Mlngyu-Park/2026ESWContest_free_A_IndustryGyuArm/ARM_STUDIO.md

# ARM STUDIO — 블록 코딩 · 디지털 트윈 · 실물 로봇 제어

ARM STUDIO 는 [RACHEL](RACHEL.md) 이 만든 블록을 **실제 로봇의 움직임**으로 바꾸는 프로그램이다.
블록을 직접 끌어다 놓아도 되고, 말로 시켜도 된다. 어느 쪽이든 3D 디지털 트윈에서 먼저 검증한 뒤 실물을 움직인다.

```
말 ─▶ RACHEL ─▶ 블록 ─▶ [ARM STUDIO] 경로 계산 ─▶ 3D 디지털 트윈 검증 ─▶ 실물 실행
```

블록을 손으로 조립해도 같은 길을 간다.

> 원칙: **AI 에 전적으로 의존하지 않는다.** AI 는 블록까지만. 관절 각도·경로·충돌·높이는 전부 기구학 계산이고,
> 계산 결과도 시뮬레이션에서 먼저 확인한 뒤에만 실물로 보낸다.

---

## 1. 화면

| 탭 | 하는 일 |
|---|---|
| ① 공장 꾸미기 | 도킹 스테이션·펜·바닥판을 3D 공장에 배치. 이름과 색 지정 (색은 무지개 6색만 — 말로 부를 때 헷갈리지 않게) |
| ② 시뮬레이션 | 블록 조립, 또는 마이크로 말하기 → 블록 자동 생성 → ▶ 3D 미리보기 |
| ③ 연동 | 실물 로봇 실행 · 일시 정지 · 정지, 자리 보정(미세 조정) |

웹 화면(`http://localhost:7900`, 3D 뷰어 7870). LattePanda Mu 에서는 바탕화면 아이콘으로 전체 화면(키오스크)으로 켠다.

---

## 2. 블록

| 블록 | 뜻 |
|---|---|
| 이동 | 그 대상(도킹·펜) 위로 이동 |
| 잡기 | 열기 → 하강 → 닫기 → 상승 |
| 놓기 | 하강 → 열기 → 상승 → 닫기 |
| 열기 / 닫기 | 그리퍼 |
| 하강 / 상승 | 지금 자리에서 수직으로 |
| 팔 | 이 뒤의 블록은 A팔 또는 B팔이 한다 |
| 기다리기 | N초 쉬기 |

- 「옮기기」 는 [이동→펜] [잡기] [이동→도킹] [놓기] 4개로 자동으로 풀린다.
- 복잡한 동작도 새로운 종류의 일이 아니라 **기존 블록의 조합**이다. 새 동작이 생기면 AI 는 그대로 두고 블록 이름만 늘린다.

---

## 3. 모터 제어 과정 — 블록이 실제 움직임이 되기까지

### ① 닿을 수 있는 곳을 미리 전부 계산 (도달표)

로봇 기준으로 엔드이펙터(그리퍼 끝)가 갈 수 있는 자리를 미리 계산해 둔다.
가로·세로 20mm 칸마다, 높이는 1mm 간격으로 "어느 높이 구간에 닿는가" 를 저장한다.
**로봇 기준 상대 좌표**라서 로봇이나 설비를 옮겨도 다시 계산하지 않고 표만 찾는다.

### ② 목표의 z축 선과 그리퍼의 z축 선을 맞춘다

도킹(목표)의 수직선과 그리퍼의 수직선을 일치시킨다. 그 위에서 **수직으로만** 내려가고 올라온다.
옆으로 밀면서 내려가면 펜이 소켓에 걸리기 때문이다.

### ③ 높이를 기준으로 가장 짧은 경로부터

출발점과 목표 사이를 지나갈 안전 높이를 정하고, 갈 수 있는 경로 중 가장 짧은 것부터 시도한다.
잡는 높이는 실측 치수로 **고정**했다:

```
바닥판 원점 → 도킹 윗면  115mm
도킹 윗면  → 펜 잡는 면  +10mm
그 면      → 그리퍼 기준점 +37mm
                         = 162mm   (잡는 높이, 고정)
접근·이동 높이 = 209mm   (도킹 윗면 + 여유 20mm + 그리퍼 아래로 늘어진 펜 74mm)
```

잡는 높이를 다른 값에서 빼고 더해 구하면, 기준이 어긋날 때마다 펜을 부순다. 그래서 상수로 박았다.

### ④ 경로를 검증한다 — 공정 조건, 물병 규칙

- 관절 한계 안인가, 목표에 3mm 안으로 도달하는가 (IK 결과를 다시 순기구학으로 확인).
- 설비·다른 팔과 부딪히지 않는가 (fcl 충돌 검사).
- **물병 규칙**을 지키는가 (4장).

통과하면 3D 시뮬레이션으로 보여 주고, 실물 실행은 그다음이다.

---

## 4. 물병 규칙 — 그리퍼 위에 물병을 올려도 쏟지 않는다

물건을 나르는 로봇은 도착 정확도만큼 **가는 동안 기울지 않는 것**이 중요하다.

- j2·j3·j4 는 회전축이 나란하다. 그래서 **세 각도의 합이 그리퍼 기울기**를 정한다. 이 합을 경로 전체에서 일정하게 유지한다.
- 손목(j5)은 돌리면 무조건 기울어지므로 쓰지 않는다. 팔이 방향을 바꿀 때는 j1 으로 **몸 전체를 돌린다** (닭이 머리 대신 몸을 돌리듯).
- 축마다 움직이는 양이 다른데 속도가 같으면, 적게 가는 축이 먼저 도착해 합이 깨진다. 많이 가는 축의 속도를 **올려서** 같이 도착하게 했다 (느린 축을 낮추면 떨림이 생긴다).
  → 기울기 최대 4.49° → **0.70°**, 떨림 0회.
- 자리 보정이 있으면 "수평" 은 그 보정 자세의 기울기다. 보정한 기울기를 지키며 수직으로 내려간다.

---

## 5. 디지털 트윈 → 실물

| | 3D 디지털 트윈 | 실물 |
|---|---|---|
| 자세 | 이론값 (URDF 기구학) | 이론값 + **자리 보정** |
| 용도 | 블록 검증, 공정 시간 측정 | 실제 작업 |

### 자리 보정 — 사람이 손으로 맞춘 값을 그대로 쓴다

- 실물 팔은 뻗는 방향에 따라 처지고 유격이 있다. 그래서 자주 쓰는 자리(펜이 놓이는 XY 자리)에서 사람이 팔을 손으로 맞추고 [보정 저장] 을 누른다.
- **보정 = 그 자리에서의 모터값.** 사람이 다시 저장하기 전에는 프로그램이 절대 바꾸지 않는다.
- 보정은 도킹 개체가 아니라 **자리(XY)에 묶인다.** 도킹을 바꿔 끼워도 그 자리의 보정은 그대로다.
- B팔은 보정 자세의 점을 지나는 **수직선**을 따라 내려가 잡는 높이까지 간다.

### 두 팔

- A팔 = 모터 ID 1~5, B팔 = ID 11~15. USB 선 하나에 두 팔이 같이 물려 있다.
- B팔은 A팔과 같은 모델이라 도달표도 그대로 복사해 쓴다.
- 충돌 방지 규칙: **한 팔이 움직이기 전에 다른 팔은 반드시 기본 자세로.** 기본 자세의 팔은 다른 팔이 절대 닿지 않는 곳에 있다.

### 떨림 잡기

| 설정 | 정지 오차 |
|---|---|
| 모터 공장 기본 (Kp32/Kd32/Ki0) | 1.58° |
| 실측 튜닝 (Kp64/Kd64/Ki4, 가속 8) | **0.35° · 떨림 0** |

---

## 6. 블록 코딩 응용 — 산업형 로봇 제어

- **조립된 블록은 물건의 상태와 상관없이 작동한다.** 이동 블록은 실행하는 순간 대상의 위치를 다시 계산한다. 실행 중에 [일시 정지] 하고 3D 화면에서 도킹을 옮기면, [계속] 을 누를 때 팔이 **새 자리**로 간다.
- **조립된 블록은 로봇의 종류와 상관없이 쓸 수 있다.** 블록에는 관절 각도가 없고 "어디로, 무엇을" 만 있다. 기구학은 URDF 에서 읽으므로 로봇이 바뀌면 URDF 만 바뀐다 (`urdf/` 에 SO-ARM(STS3215)·OpenManipulator(Dynamixel) 모델).

---

## 7. 안전

| 기능 | 동작 |
|---|---|
| 일시 정지 | 토크를 유지한 채 멈춤. 그동안 3D 에서 도킹을 옮기면 계속할 때 새 자리로 |
| 정지 | 실행을 멈추고 지금 팔의 토크를 끔 |
| 비상정지 버튼 (아두이노) | 누르는 순간 **두 팔 모두** 그 자리에서 토크 유지로 멈춤 → 버튼을 떼면 두 팔 토크 해제. 버튼 선이 빠지면 뗀 것과 같게 |
| 그리퍼 잡힘 감지 | 닫는 중 위치가 멈추면 잡은 것으로 보고 더 조이지 않음 (모터 과부하 방지) |
| 실행 전 검사 | 도달 불가·충돌·안전 높이 불가면 시작하지 않고 이유를 알려 줌 |

---

## 8. 실행

### LattePanda Mu (시연)

바탕화면의 **ARM STUDIO** 아이콘 → 서버가 켜지고 전체 화면으로 열린다.
실행 스크립트: `dusk_boom_fpga_v35/mu/dusk_tpu/panda_launch_tpu.sh` (DUSK_BOOM TPU 화면까지 같이 연결).
모니터를 더 꽂으면 같은 화면이 자동으로 복제되게 해 두었다 (`mu/dusk_tpu/auto_mirror.py`).

### 노트북 (Windows + WSL2)

```powershell
# Windows PowerShell — 로봇 USB 를 WSL 로 넘기기
usbipd list
usbipd attach --wsl --busid <busid>
```

```bash
conda create -n gyu_arm python=3.10 && conda activate gyu_arm
pip install fastapi uvicorn numpy trimesh python-fcl ikpy pyserial
cd Industry_gyu_arm && ./start_pro.sh        # → http://localhost:7900
```

- 보정·배치 데이터(`calib.json`)는 로봇마다 달라 저장소에 넣지 않았다. 처음 켜면 빈 공장에서 시작한다.
- 더블 레이첼 가중치가 없으면 「말로 만들기」 는 규칙 파서로 동작한다 → [RACHEL.md](RACHEL.md) 8장.

---

## 9. 파일

| 무엇 | 어디 (`Industry_gyu_arm/` 아래) |
|---|---|
| 코어: 기구학·경로·모터·보정·RACHEL 연결 (약 1만 3천 줄) | `arm_studio_web.py` |
| 웹 서버 (FastAPI) | `arm_studio_pro.py` |
| 화면 (바닐라 JS + three.js) | `pro_ui/` |
| B팔 모터 영점·범위 | `sts_arm2.py` |
| 실행 스크립트 | `start_pro.sh` |
| 로봇 모델 · 설비 메쉬 | `../urdf/` · `../stl/` |

---

## 10. 기술 스택

| 분야 | 쓴 것 |
|---|---|
| 기구학 | numpy (동차변환·IK 직접 구현), ikpy, trimesh, python-fcl |
| 모터 | pyserial — Feetech STS3215 직접 통신 |
| 서버 · 화면 | FastAPI, three.js, 바닐라 JS |
| 개발 | ROS 2 Humble · RViz (초기 개발), VS Code |
