Mlngyu-Park/2026ESWContest_free_A_IndustryGyuArm/Industry_gyu_arm/ARMSTUDIO_전체정리_20261026.md

# ARM STUDIO — AI 로봇팔 프로그램 정리

**박민규 · 2026-10-26 기준 · 프로그램(소프트웨어)만**

말이나 블록으로 로봇팔에 일을 시키고, 그 움직임을 3D 디지털 트윈에서 먼저 확인한 뒤, 같은 명령을 실물 팔로 보내는 프로그램이다. 휴대폰 카메라로 실제 판을 비추면, 도킹·로봇이 놓인 자리를 읽어 트윈에 그대로 옮기고, 실행 중 목표가 사라지면 팔을 든 채 기다렸다가 다시 꽂으면 이어 간다.

이 문서는 코드와 실측 기록에서 확인한 사실만 적는다. 모터·회로 같은 하드웨어 이야기는 뺐다. 10-03 문서(`인규암_ARMSTUDIO.md`) 이후 바뀐 것은 **[10-03 이후]** 로 표시했다.

---

## 목차

1. 한눈에 보기
2. 설계 원칙 — AI 경계선
3. 프로그램 구성
4. 좌표계·툴 중심·목심 격자
5. 기구학
6. 모션 실행 논리
7. 블록 파이프라인
8. AI 층 — 말이 블록이 되는 과정
9. RACHEL — 직접 만든 언어모델
10. 디지털 트윈
11. 공장 꾸미기와 배치 프리셋
12. 미세조정(보정) — 자리에 묶는 보정
13. 휴대폰 카메라 — 실제 판을 트윈에 옮기기
14. 실행 중 카메라 연동 — 경로 표시·대기·이어가기
15. DUSK — 파이썬 없는 C 엔진
16. 실측 숫자 종합
17. 장점
18. 단점과 알려진 문제
19. 파일 구조와 실행 방법

---

## 1. 한눈에 보기

```
사람의 말 / 블록 끌어놓기                 휴대폰 카메라 (실제 판)
        │                                        │
        ▼                                        ▼
  [음성 인식]  소리 → 글자          AI     [격자 추적]  구멍 → 판 좌표·카메라 위치   계산
  [힌트]       색·번호 → 도킹 id    계산   [물건 찾기]  바닥색·3D 모양 → 로봇·도킹    계산
  [명령 해석]  글자 → 블록 목록     AI     [판 맞춤]    카메라 판 → 앱 바닥판         계산
  [검증]       없는 대상 버리기     계산          │
  [기구학]     블록 → 관절각 경로   계산          │ 도킹 이동·숨김·로봇 이동
        │                                        ▼
        ├──▶ [3D 디지털 트윈]  이론 자세 + 지금 블록의 경로 + 카메라 위치
        └──▶ [실물 명령]       이론 자세 + 그 자리의 XY 보정
                                (목표가 카메라에서 사라지면 팔을 든 채 대기)
```

| 항목 | 값 |
|---|---|
| 코어 | `arm_studio_web.py` **11,722줄** — 기구학·경로·충돌·명령 전송·LLM·시뮬레이션·카메라 반영 |
| 서버 | `arm_studio_pro.py` **1,028줄**, FastAPI. `/api/call` 하나로 핸들러 약 90개를 부른다 |
| 화면 | `pro_ui/` — app.js 1,756줄 · index.html 555줄 · app.css 461줄 · phone.html 106줄, 바닐라 JS + three.js |
| 카메라 | `cam_grid/` — livecam.py 815줄 · grid.py 393줄 · objects.py 178줄 · pose.py 61줄 |
| 포트 | 앱 7900 · 3D 뷰어 7870 · 휴대폰 https 7943 · DUSK 7880 · (선택) Spark LLM 18000 · Spark 음성 18090 |
| 실행 | `Industry_gyu_arm/start_pro.sh` |

화면은 네 탭이다.

| 탭 | 하는 일 |
|---|---|
| ① 공장 꾸미기 | 설비(STL)를 끌어다 놓기, 다리 2개를 목심에 찍어 자리·방향 정하기, 바닥판 늘리기, 배치 저장·불러오기 |
| ② 시뮬레이션 | 블록 목록과 3D. [🎤 누르고 말하기] [보내기] [▶ 미리보기] [실물 실행] |
| ③ 연동 | 자세별 미세조정·보정 저장, **📱 휴대폰 카메라** |
| ④ 조이콘 | 조그 이동 (미리 계산한 조종표) |

---

## 2. 설계 원칙 — AI 경계선

> **AI 는 말을 블록으로 바꾸는 일까지만 한다. 좌표·경로·충돌·명령·카메라 인식은 전부 계산이 한다.**

AI 는 두 곳에만 있다. 소리를 글자로 바꾸는 곳과, 글자를 블록으로 바꾸는 곳이다. 그 사이와 그 뒤는 전부 결정론적 계산이라 같은 블록은 언제나 같은 관절각을 낸다. 카메라 인식도 신경망이 아니라 기하 계산(호모그래피·색 비교·3D 투영)이다.

이유는 안전이다. "대체로 맞는" 답을 내는 부품을 좌표를 만드는 자리에 두지 않는다. 효과는 실측으로 확인했다. "빨간 도킹이 몇 번인가" 같은 표 조회를 신경망에 시켰을 때 색 지칭 정확도가 **65.2%** 였고, 이것을 20여 줄짜리 계산(`hints.py`)으로 옮기자 **99.6%** 가 됐다 (같은 검증셋 267문장).

---

## 3. 프로그램 구성

```
브라우저 (pro_ui)  ──/api/call──▶  arm_studio_pro.py (FastAPI)  ──▶  arm_studio_web.py (코어)
      │                               │  /state·/mesh·/camframe 중계        │
      └── 3D 뷰어 (7870, three.js) ◀──┘                                     ├─ 기구학·경로·충돌
                                                                             ├─ 블록 실행 (시뮬 / 실물)
휴대폰 phone.html ──POST /api/live/frame (https 7943)──▶ cam_grid/livecam   ├─ LLM 호출·검증
                                                         (일꾼 스레드)       └─ 카메라 반영 루프 (0.5초)
```

| 구성 | 하는 일 |
|---|---|
| 코어 | 로봇 정의(URDF)를 읽어 기구학을 세우고, 블록을 관절각 경로로 바꿔 시뮬레이션·실물 명령으로 보낸다 |
| 서버 | 화면 요청을 코어 핸들러로 연결하고, 3D 뷰어·휴대폰 페이지를 띄운다. 화면 파일은 캐시하지 않는다 (옛 app.js 가 남아 보정이 한 번에 지워지던 일 뒤) |
| 화면 | 블록 편집, 3D 조작, 보정, 카메라 버튼 |
| 3D 뷰어 | 트윈 표시. 서버를 거쳐 앱 상태를 받는다 |
| 카메라 | 휴대폰 영상으로 판·로봇·도킹 인식 (별도 스레드, 최신 장만 처리) |
| 로봇 교체 | URDF 만 바꾸면 기구학이 따라온다. 보정 파일도 로봇(URDF 패키지)마다 따로 |

---

## 4. 좌표계·툴 중심·목심 격자

### 4-1. cr_7 (툴 중심)

로봇이 "어디에 있는가"를 말할 때의 기준점이다. j6 링크에서 `[-9, 39.5, 39.3] mm` 떨어진, 그리퍼 회전 원의 중심이다. 그리퍼를 열면 움직이는 죠의 좌표가 바뀌므로, 툴 중심은 j6 를 기준각(`J6_TOOL_REF`)으로 고정하고 계산한다.

### 4-2. 잡는 높이 — 고정값

```
115 mm   도킹 스테이션 높이
+ 10 mm  도킹 윗면 → 그리퍼가 닿는 면      (GRASP_FACE_DZ)
+ 37 mm  잡는 면 → cr_7 중심               (실측 36.67)
= 162 mm 바닥 기준 잡는 점
```

메쉬로 매번 계산하면 오차가 쌓이고 도킹마다 흔들려서, 한 번 재서 고정했다.

### 4-3. 목심 격자 — 바닥판은 안 바뀐다

바닥판은 20 mm 간격 목심 격자다. 타일 하나가 200 mm(10×10칸), 판은 최대 **3×3 타일(30×30칸)** 이다. 파랑·흰 타일이 체크무늬로 깔린다. 앱의 첫 목심은 (−90, −90) mm 에서 20 mm 간격이다.

**바닥판은 고정 기준이고, 로봇과 도킹은 움직일 수 있다** — 카메라 연동의 기본 전제다 (§13).

---

## 5. 기구학

| 항목 | 내용 |
|---|---|
| 순기구학 | URDF 관절 체인 행렬 곱. `fk(q)` = j6 원점, `tool_pos(q)` = cr_7 |
| 수평 구속 「물컵 규칙」 | j2·j3·j4 가 평행하므로 **j2+j3+j4 = 0** 이면 그리퍼가 늘 수평. j5 는 0 고정. 실측 최대 오차 1.07° |
| IK | `ik_level`(수평 유지, 여러 초기값), `ik_tool`(툴 기준, 수렴 0.002 mm), `ik_general`(구속 없는 로봇용) |
| 간편 이동 | **뽑기(수직 상승) → 수평(A* 격자 경로, 높이 유지) → 하강(수직)**, `plan_simple` |
| 목심 도달표 | 658칸, 목심마다 닿는 높이 구간을 1 mm 단위로 미리 계산 |
| 조종표 | 143,667칸(10 mm 격자). 시작할 때 0.5~0.7초에 불러온다 |
| 충돌검사 | trimesh + fcl. 로봇 링크와 설비 STL 의 겹침을 **실행 전 표시만** 한다 (피해 가지는 않음) |

도달표·조종표는 **로봇 기준 상대좌표**라, 로봇이나 설비를 옮겨도 다시 계산할 필요가 없다 (재계산 0초). 카메라가 로봇을 옮겨도 마찬가지다.

---

## 6. 모션 실행 논리

- 이동은 **"보내고 → 기다리고"** 의 반복이 전부다. 도착 확인 후 오차만큼 다시 미는 단계(settle)가 진동의 근원이라 뺐다 (`SETTLE_ON=[False]`).
- 이동 중 상태 읽기도 뺐다 (걸음마다 250 ms 씩 멈췄다).
- 그리퍼만 닫힘을 확인한다 (쥐면 목표 각도에 못 가므로).
- **3D 는 이론 자세, 실물 명령은 이론 자세 + 그 자리의 보정** (§12).
- 카메라가 지켜보는 중이면 실물로 보내는 매 걸음마다 목표가 그대로 있는지 확인한다 (§14).
- 정지 버튼은 즉시 멈춤. 3D 에서 고른 로봇과 실물이 다르면 실물 전송을 막는다 (`real_robot_ok()`). 말로 실물을 움직이려면 "실물 실행 확인"까지 두 번 말해야 한다.

---

## 7. 블록 파이프라인

### 7-1. 블록 7종

| 블록 | 기호 | 실제 동작 | 좌표 |
|---|---|---|---|
| 이동 | `@goto:<id>` | 뽑기 → 수평 → 하강 | **있음** |
| 잡기 | `@grasp:<물체>` | 열기 → 하강 → 닫기 → 상승 | 없음 |
| 놓기 | `@release:<도킹>` | 하강 → 열기 → 상승 → 닫기 | 없음 |
| 열기 / 닫기 | `@open` `@close` | 제자리 | 없음 |
| 하강 / 상승 | `@down` `@up` | 지금 XY 유지, 수직 | 없음 |

### 7-2. 좌표는 이동 블록만 갖는다

잡기·놓기가 스스로 XY 를 계산하면 이동이 계산한 XY 와 둘이 생겨 실측 23 mm 가 어긋났다. 그래서 좌표는 이동 블록 하나만 갖고, 잡기·놓기 앞에 이동이 없으면 `seq_fix_moves()` 가 넣는다.

### 7-3. 이동 블록은 실행하는 순간 다시 계산한다

미리 계산한 경로는 물체가 중간에 옮겨지면 옛 위치로 간다. 이동 블록은 실행하는 순간 대상의 **지금 위치**로 경로를 다시 푼다. 카메라가 도킹을 옮겨 놓았으면 옮긴 자리로 간다.

### 7-4. 블록 어휘의 한계

"등록된 도킹 사이의 이송"만 표현한다. "옆에", "두 개 다", 밀기·누르기는 못 한다. 위치 제어만 있다.

---

## 8. AI 층 — 말이 블록이 되는 과정

### 8-1. 음성 인식

| 엔진 | 위치 | 특징 |
|---|---|---|
| Spark Whisper (large-v3-turbo) | DGX Spark (18090) | 정확하다. 네트워크가 필요하다 |
| Moonshine 한국어 27MB | 로컬 단독 | 네트워크 없이 돈다. 정확도는 낮다 |

Moonshine 은 4초 창을 3초 간격으로 겹쳐 돌리고 이어 붙인다. 반복 루프와 끝의 헛말("감사합니다" 등)은 규칙으로 자른다.

### 8-2. FIXER — 받아쓴 말 다듬기 (자작 7.5MB)

Moonshine 결과에만 쓴다. 글자 단위 GPT(7,603,200 파라미터, int8 7.5MB, 호출당 25~31 ms). 고친 결과에서 색·동작이 사라지거나, 순서가 바뀌거나, 없던 것이 생기면 **원문을 그대로** 쓴다. 음성 인식과 FIXER 를 합쳐 WHISPER DUSK 라 부른다.

### 8-3. 명령 해석 엔진

| 선택 | 내용 |
|---|---|
| `auto` (기본) | Spark 가 살아 있으면 Gemma 4 E4B **원본**(5.15 GB, 생각하기 끔), 없으면 로컬 ollama, 둘 다 없으면 규칙 파서 |
| `rachel` | 직접 만든 RACHEL (C++, §9) |
| `rule` | 규칙 파서 (AI 없음) |

Gemma 4 는 "생각하기"를 끄지 않으면 블록을 못 만든다 (켜면 14초·블록 0개, 끄면 4.3초·블록 8개).

### 8-4. 힌트 — AI 에게 시키지 않는 일

`hints.py` 가 문장에서 색·번호 언급을 찾아 언급 순서대로 도킹 id 를 붙인다. 모델에 남는 일은 "어느 것이 출발·경유·도착인가" 뿐이다.

```
장면: 보라=d2 빨강=d10 주황=d11 | 펜=초록@d2
힌트 d2 d10
보라색 도킹의 초록 펜 빨간 데로 옮겨
>
```

### 8-5. 출력 검증과 폴백

- 이중 포장된 배열을 펴고(`_flat_blocks`), 짧은 별명을 실제 id 로 바꾸고(`_llm_expand`), **등록되지 않은 대상은 버린다**(`_resolve_item`).
- 입력 문장의 **줄바꿈·여러 칸 띄어쓰기를 한 칸으로** 바꾼 뒤 넣는다 **[10-03 이후]** — 받아쓴 문장에 줄바꿈이 섞이면 RACHEL 이 그 뒤 색(빨강)을 건너뛰었다.
- 폴백: RACHEL/Gemma → 실패 → 규칙 파서(검증 200문장 중 30.0%) → "무슨 뜻인지 모르겠습니다".
- 검증은 id 가 있는지만 본다. 같은 도킹으로 세 번 가는 식의 **뜻이 틀린 순서는 걸러지지 않는다.**

---

## 9. RACHEL — 직접 만든 언어모델

Robot Arm Command Handling Embedded Language-model. 한국어 명령을 블록 JSON 으로 바꾸는 일 하나만 하도록 밑바닥부터 만들었다.

### 9-1. 제원 (`rachel_v9.bin`)

| 항목 | 값 |
|---|---|
| 구조 | GPT decoder-only, 차원 320 / 8층 / 8헤드 |
| 어휘 / 문맥 | 448 (글자 단위) / 179 |
| 파라미터 | **10,122,240** |
| 파일 | **10,126,061 B (10.1 MB)**, int8 |
| 앱이 여는 파일 | `rachel_cpp/rachel.bin` = **v9 와 같은 파일** (md5 일치) **[10-03 이후 — 예전엔 v8]** |

### 9-2. 학습 데이터

규칙 생성기로 합성한 15만 쌍(사람 라벨 없음). 명령 분기 9종, 문장 틀 48개, 음성 오염 규칙 7개. 장면(색↔도킹 배치) 140,483가지를 무작위 배정해 외우지 않고 장면을 읽게 했다. 장면에 없는 요청은 빈 블록으로 거절하게 학습했다. 손실은 답 부분에만 건다.

### 9-3. 정확도

| 시험 | 결과 |
|---|---|
| 검증 200문장 | **197/200 (98.5%)** — 정수 엔진·평가기·Spark 모두 같은 값 |
| 검증 3,000문장 | 2,875/3,000 (95.8%) |
| Gemma 4 E4B 원본 (같은 200문장) | 78/200 · 5.15 GB · 메모리 3,866 MB |
| RACHEL 메모리 | **21.9 MB, CPU 1스레드** |
| 지연 (C int8) | 중앙 180 ms · 평균 225 ms |
| **실제 사람이 한 말** (사용 기록 98문장, 화자 1명) | 명령 86문장 중 **최소 36개(42%) 오류** — 합성 검증과 큰 차이 |

---

## 10. 디지털 트윈

### 10-1. 구조

three.js 뷰어가 별도 포트(7870)에서 돌고, 앱(7900)이 애니메이션 청크를 보낸다. 서버가 `/state`, `/mesh`, `/camframe` 등을 뷰어로 중계한다. **같은 파이프라인이 3D 와 실물 양쪽으로 나간다.** 청크를 바이너리로 바꿔 4.1 MB/2,825 ms → 1.1 MB/6 ms 가 됐다. **[10-03 이후]** 설비 이름에 든 `#` 을 중계가 잘라먹지 않게 주소를 다시 인코딩했다.

### 10-2. 트윈이 보여 주는 것

| 표시 | 내용 |
|---|---|
| 로봇 | URDF 메쉬. **언제나 이론 자세** (보정은 실물 명령에만, §12) |
| 설비 | 바닥판·도킹·물체 STL. 도킹 색은 이름 붙이기에서 정한 색 |
| **지금 블록의 경로** **[10-03 이후]** | 실행 중인 이동 블록 **하나**의 예상 경로를 하늘색 반투명 관으로 (`PATH_VIS` → `/state` 의 `path` → 뷰어 `drawPath`, 불투명도 0.35) |
| **휴대폰 카메라 위치** **[10-03 이후]** | 주황 사각뿔(시야)로 카메라 위치·방향. 손떨림은 One Euro 필터로 거른다 |
| **1인칭** **[10-03 이후]** | 카메라 자리에서 본 트윈. 보기 3가지: 트윈+영상 겹치기 / 트윈만 / 영상만 |
| 카메라가 옮긴 결과 | 도킹 이동·숨김·다시 보임, 바닥판 추가, 로봇 이동이 바로 반영된다 |

### 10-3. 트윈 검증

| 무엇 | 값 |
|---|---|
| 툴 IK 수렴 | 0.15 mm → 0.002 mm |
| 도착 판정 | 3 mm |
| 트윈 3단계 (검증 200문장, 3 mm) | 블록 정답 197 · 도달·충돌 없음 143 · 3 mm 도착 143. 못 잰 57개는 판정 불가(도킹 3개뿐인 배치 등)이고 실패 0건 |

### 10-4. 원위치 버튼 **[10-03 이후]**

[원위치]는 팔을 영(0) 자세로 돌리면서, **물체(펜)도 [불러오기]로 고른 배치 프리셋의 자리로** 되돌린다 (`h_home_zero(preset)`, 고른 게 없으면 마지막으로 불러온 배치). 실물 실행으로 펜이 다른 도킹에 남았는데 손으로 되돌려 놓은 경우, 트윈이 옛 자리를 믿는 문제를 없앴다. 설비·로봇 위치는 건드리지 않는다.

---

## 11. 공장 꾸미기와 배치 프리셋

- 설비 STL 을 끌어다 놓으면 실물 모양이 커서를 따라온다. **다리(핀) 2개를 목심에 클릭**해 자리와 방향을 정한다. 위치는 20 mm 격자에 맞춘다.
- 우클릭으로 이동·핀 다시 찍기·삭제.
- 물체는 늘 도킹 위에 올라간다 (중심축 일치).
- 도킹은 배치 순서대로 색·번호를 고정 배정한다.
- 바닥판은 3D 에서 더블클릭 → 빈 자리 클릭으로 늘린다. 카메라도 9장까지 자동으로 늘린다.
- 배치를 이름 붙여 **프리셋**으로 저장·불러오기 한다. 켤 때는 "바닥판만 있는 공장"으로 시작하고, 직전 배치는 '이전 배치' 프리셋에 남는다.
- **[10-03 이후]** 도킹 모델을 다리가 하나 더 있는 새 STL 로 바꿨다. 주요 치수·소켓 자리(270, 62.5 mm)는 이전과 같다.

---

## 12. 미세조정(보정) — 자리에 묶는 보정 **[10-03 이후 크게 바뀜]**

### 12-1. 원칙

| 원칙 | 내용 |
|---|---|
| **보정의 주인은 물건이 아니라 판 위 XY 자리** | 보라 도킹에서 보정해 두고 같은 자리에 주황 도킹을 놓아도 그 보정을 쓴다. 이동 목표 XY 에서 10 mm(`SLOT_TOL`) 안에 등록된 '이동' 자세를 이름과 상관없이 찾는다 (`_goto_pose_q`, `_slot_pose`) |
| **트윈은 이론, 실물은 이론 + 보정** | 예전엔 보정 각도로 3D 까지 움직여 트윈 속 펜이 도킹에서 어긋났다. 이제 3D 는 계산 자세 그대로 간다 |
| **보정은 XY 만** | 보정 자세에서 "실제로 가리키는 XY − 자리 XY" 만 뽑아(`_slot_delta`), 트윈 팔 끝과 **같은 높이**에서 XY 만 옮긴 자리를 실물 목표로 푼다. 미세조정 중 높이까지 바뀐 채 저장된 경우(실측: 이름은 235 mm 인데 실제 175.9 mm) 펜 속으로 내려가던 문제를 없앴다 |
| 서서히 붙고 떨어짐 | 자리 중심에서 XY 5→30 mm 사이, 등록 높이보다 2→8 cm 위 사이에서 보정량이 1→0 으로 준다. 30 mm 넘는 XY 보정은 잘못 저장된 것으로 보고 안 쓴다 |

### 12-2. 흐름

```
블록 우클릭 [🎯 자세 등록]  →  ③연동 [로봇을 이 자세로]  →  J1~J5 +/−  →  [보정 저장]
```

- **같은 자리를 다시 등록하면 덮어쓴다** (값이 둘이 되어 옛 값으로 가던 문제 해결).
- **보정 자세를 지울 때는 두 번 묻는다** — "보정 좌표까지 삭제할까요? (취소하면 삭제하지 않습니다)" (`poseDelOk`).
- +/− 는 메모리에서만 바뀌고, [보정 저장]이 저장 파일에 쓴다. 저장 직전 하루 한 번 자동 백업(`calib.json.YYYYMMDD.bak`).
- 저장 파일 `calib.json`(로봇마다 하나)에 자세·보정·블록·배치·프리셋·로봇 자리가 다 들어 있다. 자동 저장은 "파일에는 있는데 메모리에는 없는 항목"을 지우지 않고 살려 둔다.

---

## 13. 휴대폰 카메라 — 실제 판을 트윈에 옮기기 **[10-03 이후 새로 만듦]**

휴대폰을 손에 들고 판을 비추면, 판 위 로봇·도킹의 자리(와 도킹 색)를 읽어 트윈에 그대로 옮긴다. 예전의 녹화 영상용 연동(`camsync.py`)은 자동 반영이 보정 파일을 덮어쓴 사고 뒤 꺼 두었다 (`CAM_ENABLED=False`). 지금 쓰는 것은 휴대폰 실시간판이다.

### 13-1. 전체 흐름

```
휴대폰 브라우저  https://<주소>:7943/phone   [시작]
   │  후면 카메라 → 긴 변 1920 JPEG(품질 0.75) → POST /api/live/frame
   │  답을 기다리지 않고 동시에 2장까지, 초당 최대 10장
   ▼
livecam.LiveCam (일꾼 스레드, 늘 가장 최근 장만 처리 — 밀리지 않는다)
   ├ 빠른 길 (매 장)     : 격자 추적 → 카메라 위치·방향
   └ 느린 길 (0.4초마다) : 판 무늬 · 바닥색 · 로봇·도킹 찾기 · 도킹 3D 모양 맞추기
   ▼
layout()  : 로봇 받침 칸, 도킹(색·가운데·다리·방향), 비어 보이는 칸, 본 타일
   ▼
앱 _live_apply_loop (0.5초마다)
   ├ 판 맞춤 (카메라 판 → 앱 바닥판)
   ├ 바닥판 늘리기 · 도킹 옮기기/숨기기/다시 보이기 · 로봇 옮기기
   └ 트윈: 카메라 위치(주황 사각뿔), 1인칭
```

### 13-2. 휴대폰 연결

| 항목 | 내용 |
|---|---|
| 왜 https 인가 | 아이폰 브라우저는 https 에서만 카메라를 연다. 앱이 같은 서버를 **https 7943** 으로도 띄운다 (`start_phone_https`) |
| 인증서 | 처음 켤 때 openssl 로 자체 서명 인증서를 만든다 (`certs/`). 사파리 경고에서 "이 웹사이트 방문" |
| 주소 표시 | ③연동 → 📱 휴대폰 카메라에 접속 주소가 나온다 |
| 화면 꺼짐 방지 | 촬영 중 화면이 꺼지지 않게 잠금(wakeLock) |
| 상태 | 휴대폰 화면 아래에 "격자 추적 중 · 카메라 높이 · 장/초 · 처리 시간"과 안내 문구 |

③연동의 버튼: 판 90° 회전·◀▶▲▼(손으로 맞추기), 1인칭 켜기/끄기, 1인칭 보기 바꾸기, 자동 반영 켜기/끄기, 판 다시 맞추기, **녹화 시작/끝**(모든 프레임 저장 — 인식 맞추기용), 손떨림 거르기, 처음부터 다시 찾기.

### 13-3. 구멍 찾기 (`grid.detect_holes`)

1. 화면에서 **파랑 또는 흰색 판 영역**만 남긴다 (벽·책상·로봇 제외).
2. 주변보다 **어두운 동그란 덩어리**를 찾는다 (구멍 안은 그늘이 진다).
3. 너무 길쭉하거나(가로세로 2배 넘게) 작은 것은 버린다.
4. 크기로 큰 구멍(목심 자리)과 작은 물빠짐 구멍을 가른다.
   - 처음: 면적 분포를 두 무리로 나눠 큰 쪽.
   - **추적 중: 예상 격자로 화면 자리마다 칸 넓이를 계산해, 그 자리에 맞는 크기만** (면적 ≈ 0.107 × 칸 넓이). 비스듬히 보면 가까운 구멍은 크고 먼 구멍은 작아서, 화면 가운데 크기 하나로 거르면 맞음 비율이 55~60% 로 떨어졌다 → 자리별로 바꿔 **96%**.

### 13-4. 각도 찾기 — 구멍 4개 + 판 색 경계

- **처음부터 찾기** (`fit_full`): 이웃 구멍끼리의 짧은 화살표에서 격자의 두 방향을 고르고, **구멍 하나와 그 오른쪽·아래·대각선, 구멍 4개로 판의 기울기·크기(호모그래피)를 계산**한다. 그것으로 판 전체 구멍 자리를 예측해 실제 구멍과 맞춰 다듬는다. 출발 구멍을 바꿔 최대 60번, 75% 이상 맞으면 바로 멈춘다.
- **판 색 경계 검사** (사용자 제안): 그렇게 구한 격자로 **구멍이 맞은 칸의 색이 10칸 타일 체크무늬와 85% 넘게 맞아야** 받아들인다. 실측: 맞는 격자는 중앙 99%, 틀린 격자는 중앙 87%.
- **몇 번째 칸인지**: 구멍은 다 똑같이 생겨 칸 번호를 모르므로 파랑·흰 체크무늬로 정한다. 칸 색은 구멍 사이 한가운데가 아니라 **구멍에서 0.3칸 안쪽**에서 읽는다 — 한가운데(0.5)는 타일 마지막 줄에서 퍼즐 이음새 위라 무늬 위치가 1칸 어긋났다 (판 경계와 맞는 장 4장 → 23장).
- **추적 중**: 앞 장과 이번 장에서 로봇·도킹·판 모서리처럼 하나뿐인 모양(특징점)으로 화면 이동을 먼저 잡고, 앞 장 격자를 그만큼 옮겨 실제 구멍에 다듬는다. 특징점은 절반 크기 화면에서 1,500개, 앞 장 것은 다시 쓴다.
- **실패 판정**: 맞은 구멍 60% 미만이거나 오차 4px 초과면 실패. 추적 결과가 나쁘면 **같은 장에서 바로 처음부터** 다시 찾는다. 두 번 연속 실패하면 앞 장 정보를 버린다.

### 13-5. 카메라 위치·방향 (`pose.py`)

- 호모그래피와 카메라 화각으로 판 기준 카메라 위치·방향을 푼다 (`camera_pose`).
- 화각: 아이폰 1080×1920 실측 초점거리 약 1,356~1,384 px. 계산값이 긴 변 화각 55~80° 범위일 때만 받아 최근 40장 중앙값을 쓰고, 모이기 전엔 70° 로 둔다. (계산이 흔들려 411~3,454 px 이 나와 주황 사각형이 갑자기 커지던 문제를 이렇게 막았다.)
- **거울상 판 축**: 보는 쪽에 따라 판 격자 축이 거울상(왼손 좌표)으로 잡히는 장면이 있다. 그때 카메라가 반대 방향을 보는 것으로 그려지고 판 맞춤도 거울상이 됐다 → 진짜 카메라→판 변환으로 투영하고, 밖으로 낼 때는 늘 오른손 좌표로 맞춘다.
- **판이 아닌 것 거르기**: 화면 속 판 칸 중 파란 바닥이 8% 미만이거나 카메라 높이가 말이 안 되면 버린다 (키보드 같은 네모 무늬).
- **손떨림**: 위치·방향을 One Euro 필터로 거른다. 1인칭에서 영상과 겹칠 때만 거르지 않은 값을 쓴다 (영상과 같이 흔들려야 맞으므로).

### 13-6. 로봇·도킹 찾기 — 바닥색 차이 (사용자 제안)

판 무늬를 알면 칸마다 **원래 바닥색(파랑/흰)** 을 안다. 실제 찍힌 색이 그와 꾸준히 다르면 "그 칸에 물건이 서 있다"고 본다.

| 바닥 | '다르다'의 기준 |
|---|---|
| 흰 타일 | 채도가 80 넘음 (색이 있음) |
| 파란 타일 | 희거나(채도<60, 밝기>150) 파랑이 아닌 색 |
| 타일 가장자리 칸 | **판정 안 함 = 모름** (퍼즐 톱니로 옆 타일 색이 들어와 이음새를 따라 가짜 줄이 생겼다) |

칸마다 이동 평균(0.25)을 쌓아 0.6 넘고 4번 넘게 본 칸만 "다른 칸"이다.

**로봇 받침**: 다른 칸 중 **흰·회색(채도<70) 덩어리**의 가장 큰 것, 그중 카메라 쪽 40% 의 가운데. 키 큰 로봇이 뒤쪽 칸을 가려 덩어리가 길게 늘어지기 때문이다. 바닥색이 다르지 않은 자리는 로봇으로 보지 않는다 — 휴대폰 앞 흐린 판이 로봇으로 잡혀 판 맞춤이 180° 뒤집혔던 일(실측: 그 자리 바닥색 차이 0.0, 진짜 받침 0.57~1.0) 뒤에 넣었다.

**도킹 다리**: 다리 간격이 40 mm(2칸) 정사각형으로 정해져 있다. 네 다리 자리가 모두 "다르거나 모름"이고 **진짜 다른 색 다리가 2개 이상**이면 후보다. 파란 도킹 다리는 파란 타일 위에서 색으로 안 갈리므로 그 칸은 모름으로 봐준다. 판 가장자리 한 줄과 로봇 받침 6칸 안은 뺀다. 3칸 안끼리는 한 도킹으로 묶고 카메라에 가까운 것을 쓴다. 색은 다른 칸들의 색상 평균.

### 13-7. 도킹 다듬기 — 3D 모양 맞추기

비스듬히 보면 키 큰 다리가 뒤쪽 칸을 가려 다리 자리가 한 칸(20 mm)씩 밀렸다. 그래서 후보 근처 ±2칸에 **진짜 도킹 모양(다리 4개 + 윗판, 높이 95 mm)** 을 세워 화면에 그려 보고, 도킹 색이 실루엣 안에 가장 많고 바로 바깥 띠(8 mm)에 가장 적은 자리를 고른다.

| 거르는 것 | 방법 |
|---|---|
| 가짜 도킹 (빛 반사·그늘) | 모양 맞추기 점수 **0.19 이상**만 도킹 (실측 진짜 0.21~0.35, 가짜 0~0.16) |
| 유령 도킹 | 높이 있는 윗판이 뒤쪽 바닥을 가려 "도킹이 하나 더"처럼 보인다 → 다리 자리가 카메라에 더 가까운 도킹의 실루엣 안이면 버린다 |
| 손 | 빨강·주황 후보는 채도 중앙값 140 이상이어야 (손 피부 실측 중앙 102) |

**도킹 방향 (U 홈)**: 윗판의 펜 꽂는 홈이 열린 쪽(STL 로컬 −y)으로 방향을 정한다. 4방향으로 홈 모양을 투영해, 도킹 색이 가장 적은(홈으로 바닥·그늘이 보이는) 쪽에 한 표. 30° 쯤 비스듬히 보면 홈이 화면에서 20~30px 인데 투영 오차가 10px 라 장마다 뒤집혀서, **위에서 50° 넘게 내려다보고 윗판이 90px 넘게 보이는 장에서만** 표를 준다. 또렷한 장(1·2등 차이 0.12)의 표가 2.5 넘고 2등의 두 배일 때만 앱 방향을 바꾸고, 그 전엔 앱의 방향을 그대로 둔다. 휴대폰에는 "도킹 위에서 내려다보듯 가까이 비춰 주세요"가 뜬다.

### 13-8. 판 맞춤과 앱 반영 — 바닥판이 기준 (`_live_register`, `_live_apply_once`)

**판 맞춤**

- 카메라의 30×30 판 창(구멍이 판 위에만 있으므로 판이 대부분 보이면 판 가장자리와 맞는다)을 앱의 바닥판 3×3 에 맞춘다. 타일이 5장 넘게 보여야 한다.
- 3×3 체크무늬는 90° 돌려도 똑같아 보인다. 그래서 4방향 중 **앱에 지금 있는 로봇·도킹 자리와 가장 잘 맞는 방향**을 고른다 (= 이전 자리 유지). 그래도 같으면 "로봇 팔이 판 안쪽을 본다"로 가른다.
- 처음(앱 바닥판이 9장이 아닐 때)은 로봇 받침이 보여야 위치를 정한다. 그 뒤 카메라가 본 타일이 5장 넘으면 9장을 모두 깐다.
- **한 번 맞추면 유지한다.** 추적이 이어지는 동안 판 창이 옮겨지면 그만큼만 정확히 옮긴다. **처음부터 다시 찾았을 때만**(칸 번호가 90°·180° 돌아 잡힐 수 있다) 다시 맞추고, 그때 쌓아 둔 증거(바닥색·가려진 구멍·판 칸 기록)도 그 장 것만 남긴다 — 안 그러면 예전 증거가 돌아간 번호에 남아 엉뚱한 자리가 로봇으로 보였다(실측).
- 로봇·도킹이 하나도 안 보이면 맞추지 않고 기다린다. 그동안 트윈은 이전 자리 그대로다.

**도킹 반영**

- 실제 도킹 하나 = 추적 하나. 색은 그동안 읽힌 색의 다수결.
- 같은 색의 앱 도킹을 데려온다 → 없으면 숨긴 도킹의 색을 바꿔 쓴다 → 그것도 없으면 복제한다.
- 3 cm 넘게 옮겨졌을 때만 옮긴다 (20 mm 격자에 맞춤). 방향 표가 정해지면 방향도 돌린다.
- **지우지 않고 숨긴다.** 블록이 "#10 도킹"처럼 이름으로 가리키므로, 지웠다 다시 만들면 이름이 바뀌어 블록이 끊긴다. 그 자리가 **또렷이 비어 보이는 판정이 2번 연속**일 때만 숨기고, 다시 보이면 같은 도킹을 다시 보이게 한다.

**로봇 반영 (로봇은 움직일 수 있다)** — 아래를 모두 만족할 때만 앱 로봇을 옮긴다.

- 판 맞춤이 맞다는 증거: 도킹 하나 이상이 (옮기기 전) 앱 자리와 4 cm 안
- 받침이 앱 자리에서 **9 cm 넘게** 떨어진 같은 자리에서 3번, **2초 넘게** 보임 (안 옮겼을 때 받침 인식 차이가 50~67 mm 라 그보다 크게 잡음)
- 블록 실행 중이 아님

옮길 때 방향은 지금 값 그대로, **로봇 핀이 목심에 오게** 20 mm 격자로 맞춘다. 저장은 배치 상태에만 하고 보정 값은 건드리지 않는다.

### 13-9. 속도 — 빠른 길과 느린 길

카메라는 빨리 움직이지 않으므로, 매 장은 격자 추적과 카메라 위치만 하고 나머지는 0.4초마다 한다.

| 하는 일 | 시간 (1080×1920) | 언제 |
|---|---|---|
| 화면 이동 잡기 | 약 12 ms (절반 크기, 앞 장 재사용) | 매 장 |
| 구멍 찾기 | 약 40 ms (색 마스크 11 → 1 ms) | 매 장 |
| 판 칸 색·무늬 | 3~4 ms (한꺼번에 계산, 예전 3~6초 걸리던 반복 제거) | 0.4초마다 |
| 바닥색·물건·도킹 모양 | 약 120 ms | 0.4초마다 |

| 결과 | 전 | 후 |
|---|---|---|
| 한 장 (빠른 길) | 약 240 ms | **57 ms** |
| 서버 처리 | 약 4장/초 | **약 15장/초** |
| 가장 느린 장 | 6.4초 (다시 찾기) | 0.22초 |
| 예상 화면 | 2~3장/초 | **8~10장/초** (휴대폰 → 전송이 먼저 막힘, 한 장 약 390 KB) |

바꾸기 전후 결과는 같다 (구멍·칸 색·판 무늬 동일 확인, 카메라 위치 차이 중앙 5.8 mm).

### 13-10. 인식 정확도 (10-22 실제 아이폰 사진)

| 항목 | 결과 |
|---|---|
| 격자 | 구멍 92~98% 가 한 격자에 맞음, 오차 약 1px = 판 위 **0.3~0.9 mm** |
| 로봇 받침 판 | 41장 중 38장 맞음 (93%) |
| 도킹 | 41장 중 32장. 못 찾은 9장 중 5장은 실제로 도킹이 없거나 손에 들려 있던 장면 |
| 연속 시험 (판 놓쳤다 다시 찾기 5번) | 로봇 제자리 유지, 도킹 가운데 판 유지(장마다 20~60 mm 흔들림), 판 맞춤 매번 앱 바닥판 9장 |
| 연속 영상 (1280×720) | 31장 모두 추적, 평균 39 ms |

### 13-11. 카메라 기능의 한계

- 로봇 **방향**(제자리에서 돌린 경우)은 아직 안 읽는다. 위치만 따라간다.
- 도킹 방향은 위에서 내려다본 실제 장면으로 아직 확인하지 못했다.
- 로봇을 9 cm 미만(목심 1~4칸) 옮긴 것은 못 잡는다.
- 파란 도킹이 파란 타일 위에 서 있으면 색으로 안 보인다 (흰 타일 위에서만 잡힌다).
- 판 무늬 위치는 41장 중 18장에서 아직 어긋나서, 판 맞춤은 판 무늬가 아니라 판 창(구멍이 있는 30×30)을 기준으로 한다.
- 위 수치는 저장된 사진·가짜 연속 재생으로 잰 것이고, 실제 휴대폰으로 연속 촬영한 시험은 아직이다.

---

## 14. 실행 중 카메라 연동 — 경로 표시·대기·이어가기 **[10-03 이후]**

| 기능 | 동작 |
|---|---|
| 경로 표시 | 실행 중인 이동 블록 **하나**의 예상 경로를 트윈에 반투명으로 그린다 (모든 블록이 아니라 지금 것만) |
| 목표가 사라지면 | 카메라에서 목표 도킹이 사라지면(트윈에서 숨겨짐) **팔을 든 채 그 자세를 유지하고** 기다린다 (`_wait_target`) |
| 이동 중 사라지거나 옮겨지면 | 실물로 보내는 걸음마다 목표를 확인해(`GOTO_GUARD`), 숨겨지거나 15 mm 넘게 옮겨지면 그 자리에서 멈추고 다시 계산한다 (`_TargetLost`) |
| 다시 꽂으면 | 트윈에 그 자리로 놓고 **확인 없이 바로 이어 간다** (블록은 그대로, 좌표만 그 순간 다시 계산) |
| 잡기·놓기 | 시작 전 목표가 있는지 확인하고, 옮겨졌으면 다시 이동한 뒤 한다 |
| 켜지는 조건 | 실물 모드 + 휴대폰 연결 중 + 자동 반영 켬 + 판 맞춤 완료일 때만. 시뮬레이션에는 영향 없음 |

실측: 실행 중 목표 도킹을 숨기자 2초 멈췄다가, 새 자리 (70, 22)에 다시 보이게 하자 그 자리로 이어서 도착했다 (가짜 실물 전송으로 시험).

---

## 15. DUSK — 파이썬 없는 C 엔진

앱과 완전히 분리된 C 실행 파일(`dusk/dusk`, 포트 7880). 파이썬 링크 0개.

| 기능 | 내용 |
|---|---|
| RACHEL 추론 | **실수 연산 0줄**의 정수 추론. 200문장 197/200, 문장당 1.6초 |
| 기구학 | FK/IK 를 C 로 이식. FK 20/20 · IK 29/29 일치, 호출당 0.005 ms |
| 블록 실행·3D | 앱의 규칙을 그대로 옮김, 자체 렌더링 |

---

## 16. 실측 숫자 종합

| 항목 | 값 | 비고 |
|---|---|---|
| 툴 IK 수렴 | 0.002 mm | |
| 수평 유지 오차 | 최대 1.07° | |
| 도착 판정 | 3 mm | |
| RACHEL | 197/200 (98.5%) · 10.1 MB · 21.9 MB 메모리 · 중앙 180 ms | 합성 검증 |
| RACHEL 실제 발화 | 명령 86문장 중 최소 42% 오류 | 화자 1명 |
| Gemma 4 E4B 원본 | 78/200 · 5.15 GB | |
| 규칙 파서 | 60/200 | |
| 트윈 3단계 | 197 / 143 / 143 (200문장, 3 mm) | 실패 0, 판정 불가 57 |
| 뷰어 청크 전송 | 2,825 ms → 6 ms | JSON → 바이너리 |
| 휴대폰 격자 정밀도 | 0.3~0.9 mm (판 위) | |
| 휴대폰 처리 | 57 ms/장, 약 15장/초 | |
| 로봇 받침 판 인식 | 93% | 41장 |
| 도킹 모양 맞추기 점수 | 진짜 0.21~0.35 / 가짜 0~0.16 | 기준 0.19 |
| 체크무늬 검사 | 맞는 격자 중앙 99% / 틀린 87% | 기준 85% |
| 목표 사라짐 → 이어가기 | 2초 대기 후 새 자리 도착 | 가짜 실물 |

---

## 17. 장점

1. **안전한 구조.** AI 는 말 → 블록까지. 좌표·경로·명령·카메라 인식은 전부 계산이라, 같은 블록은 언제나 같은 동작이다.
2. **작은 모델로 된다.** 10.1 MB RACHEL 이 같은 과제에서 5.15 GB Gemma 원본보다 정확했다 (197 대 78).
3. **네트워크 없이 돈다.** RACHEL·Moonshine·FIXER·카메라 인식 모두 로컬 CPU 에서 단독으로 돈다.
4. **사람이 읽고 고칠 수 있다.** AI 출력이 블록이라 실행 전에 보고 끌어서 고친다.
5. **트윈과 실물이 같은 파이프라인.** 트윈은 이론 자세, 실물 명령만 그 자리의 XY 보정을 더한다.
6. **실제 배치를 트윈이 따라온다.** 휴대폰으로 비추면 도킹 자리·색, 로봇 자리, 바닥판이 트윈에 맞춰진다. 바닥판을 기준으로 삼아 판을 놓쳤다 다시 찾아도 이전 자리를 유지한다.
7. **실행 중 사람이 끼어들어도 안전하다.** 목표를 빼면 팔을 든 채 기다리고, 다시 꽂으면 새 자리로 이어 간다.
8. **보정이 자리에 묶인다.** 같은 자리에 다른 물건을 놓아도 보정이 따라오고, 트윈은 흐트러지지 않는다.
9. **미리 계산한 표.** 도달표·조종표가 로봇 기준이라 로봇·설비를 옮겨도 재계산 0초.
10. **모든 기준값에 실측 근거가 있다.** 잡는 높이 37 mm, 구멍 면적 비율 0.107, 모양 맞추기 기준 0.19, 체크무늬 기준 85%, 로봇 이동 기준 9 cm 같은 값이 전부 재서 정한 값이다.

---

## 18. 단점과 알려진 문제

### 18-1. 동작

| 문제 | 내용 |
|---|---|
| 충돌을 피하지 않는다 | 검출해서 ⚠ 표시만 하고 진행한다 |
| 뜻이 틀린 블록은 통과 | 검증은 id 가 있는지만 본다 |
| 블록 어휘가 좁다 | 등록된 도킹 사이 이송만 |

### 18-2. AI

| 문제 | 내용 |
|---|---|
| **실제 말에 약하다** | 합성 98.5% 지만 실제 발화 명령의 최소 42% 가 틀렸다. 학습·검증이 같은 생성기에서 나왔다 |
| 생성 상한 200토큰 | `rachel_cpp/rachel.cpp` 가 200토큰에서 끊어 5단계 답(약 238자)이 잘린다. 평가용 `rachel_eval` 만 상한 400 |
| 문맥 179자 | 긴 답을 통째로 못 담는다 |
| 기본 엔진 | `auto` 는 Spark 가 살아 있으면 Gemma 원본을 쓴다. RACHEL 은 직접 골라야 돈다 |

### 18-3. 보정과 저장

| 문제 | 내용 |
|---|---|
| +/− 만으로는 저장되지 않는다 | [보정 저장]을 눌러야 한다 |
| 켤 때 배치 초기화 | "바닥판만 있는 공장"으로 시작, 직전 배치는 '이전 배치' 프리셋 |
| 앱 코어를 import 하면 파일을 쓴다 | 시험 스크립트는 반드시 복사본 경로(`ARM_BASE_URDF`)로 돌린다 |
| ~~같은 자리 재등록 시 옛 자세로 감~~ | **해결 [10-03 이후]** — 같은 자리는 덮어쓴다 |
| ~~앱이 옛 RACHEL(v8)을 씀~~ | **해결 [10-03 이후]** — 앱 파일이 v9 |

### 18-4. 카메라

§13-11 참고. 로봇 방향 미인식, 도킹 방향 미확인, 로봇 9 cm 미만 이동 미인식, 파란 도킹·파란 타일 구분 불가, 실제 연속 촬영 시험 전.

### 18-5. 개발 관리

| 문제 | 내용 |
|---|---|
| 핵심 폴더 일부가 git 미추적 | `nano_llm/`, `dusk/`, `rachel_cpp/`, `whisper_dusk/`, `cam_grid/` 등 |
| 코어가 한 파일 1만 2천 줄 | `arm_studio_web.py` 에 기구학·명령·LLM·UI 핸들러·카메라 반영이 다 있다 |

---

## 19. 파일 구조와 실행 방법

### 19-1. 주요 파일

```
Industry_gyu_arm/
├─ start_pro.sh            앱 실행 (이전 서버 정리 → Spark 터널 → 앱 기동, 로그 /tmp/arm_studio.log)
├─ arm_studio_web.py       코어 11,722줄
├─ arm_studio_pro.py       FastAPI 서버 1,028줄 (+ 휴대폰 https 7943)
├─ pro_ui/                 화면 — app.js · index.html · app.css · phone.html(휴대폰 카메라 페이지)
├─ cam_grid/
│  ├─ livecam.py           휴대폰 실시간 카메라 (빠른 길/느린 길, 로봇·도킹 찾기, 3D 모양 맞추기)
│  ├─ grid.py              구멍 찾기 · 격자 맞추기 · 추적 · 판 무늬
│  ├─ pose.py              초점거리 · 카메라 위치
│  ├─ objects.py           가려진 구멍으로 물건 판정
│  ├─ camsync.py           녹화 영상 연동 (꺼 둠)
│  └─ shots/live/          진단용 표본 (실패 3초·성공 10초마다, 최근 60장) · rec_*/ 녹화
├─ certs/                  휴대폰 https 인증서 (자동 생성)
├─ nano_llm/ · rachel_cpp/ RACHEL 학습 · C++ 추론기 (rachel.bin = v9)
├─ nano_fix/ · whisper_dusk/  FIXER · 음성 인식
├─ dusk/                   C 단독 엔진 (7880)
├─ 인규암_ARMSTUDIO.md     10-03 기술 문서
└─ ARMSTUDIO_전체정리_20261026.md   이 문서

urdf/sts3215/Industry_gyu_arm_20260728_base/
├─ urdf/*.urdf             로봇 형상
└─ calib.json              자세·보정·블록·배치·프리셋 (+ 날짜별 .bak)
```

### 19-2. 실행

```bash
cd ~/2026_project/Industry_gyu_arm
bash start_pro.sh                      # 브라우저 http://localhost:7900
tail -f /tmp/arm_studio.log            # 로그

# 휴대폰 카메라: 사파리에서 https://<주소>:7943/phone → '이 웹사이트 방문' → 카메라 허용 → [시작]

cd dusk && ./dusk                      # DUSK (앱과 별개) http://localhost:7880
```

카메라 쓰는 순서:
1. 앱을 켜고 휴대폰 페이지에서 [시작]
2. **로봇과 판이 같이 보이게** 한 번 훑는다 (처음 판 맞춤)
3. 도킹을 옮기거나 빼고 꽂으면 트윈이 따라온다
4. 도킹 방향을 맞추려면 도킹 위에서 내려다보듯 가까이 비춘다
5. 이상하면 ③연동 [녹화 시작/끝]으로 그 구간을 남긴다

---

## 2026-11-04 변경 (Claude)

| 무엇 | 내용 |
|---|---|
| **보정 자리 = 로봇 기준** | §12 의 '판 위 XY 자리' 를 **로봇 기준 자리**로 바꿨다. 자세마다 `rel`(등록 때 이론 목표점, 로봇 좌표 m)·`arm`(잰 팔) 을 저장하고, 쓸 때 `l2w(rel)` 로 지금 로봇 자리의 판 좌표를 다시 구한다 (`_pose_slot`). 로봇을 옮기거나 돌려도 '로봇 기준 X+2칸, Y+3칸' 보정이 그대로 따라간다. 팔마다 자기 보정만 쓴다 (B팔도 B팔로 잰 보정은 쓴다). 이름 속 숫자는 등록 당시 판 좌표(표시용). |
| 예전 보정 옮겨 적기 | 시작할 때 `_adopt_legacy_slots()` 가 rel 없는 자세의 등록 당시 로봇 자리를 후보(지금·프리셋·원점) 중에서 찾아 딱 하나 맞으면 rel 을 붙인다. 11-04 기준 #2·#10·#11 세 개 모두 로봇 원점(0,0,0°)에서 등록한 것으로 확정. |
| **잡기·놓기가 '어디' 를 가짐** | 대상(잡기=물체, 놓기=도킹) 위가 아니면(15mm 넘게) [이동] 과 같은 길(goto_move, 자리 보정 포함)로 먼저 그 위로 간 뒤 동작 (`_goto_before`). 예전엔 제자리 수직만 해서 [놓기 #8] 을 #2 위에서 하면 실물은 #2 에, 트윈만 #8 에 놓였다. 시작 때 잡기/놓기 앞에 이동을 몰래 끼우던 정리(`seq_fix_moves`)는 끔. |
| 블록 칸 = 사물 이름 | 잡기·놓기 칸에 색만이 아니라 사물 이름 알약을 그대로 보인다 (app.js). |
| 펜은 도킹 위에만 | [원위치] 가 프리셋 자리로 펜을 되돌릴 때 그 자리에 도킹이 없으면 옮기지 않는다 (`_bricks_to_preset`). |
| 이동 미리 계산 | 이동 블록으로 가는 구간은 미리 풀지 않는다 (실행 때 goto_move 가 푼다, 미리 계산분은 원래 버려졌음). '#2 → #2', '펜 꽂힌 #2 → #8' 이 '시작/도착이 금지 영역' 으로 전체를 막던 문제. 지금 자리와 같은 목표면 움직이지 않는다 (`SAME_SPOT_*`). |
| 판다 웹캠·마이크 | `panda_devices.py`. ③연동 [🖥 판다 웹캠 켜기/끄기] (휴대폰과 같은 처리 길), 🎤 는 브라우저 마이크가 안 되면 판다 USB 마이크(arecord)로. |
| 주의 | 앱은 시작할 때 배치를 '이전 배치' 로 덮어쓰고 바닥판만 남긴다. 재시작 뒤 배치를 안 불러온 채 또 재시작하면 '이전 배치' 가 빈 배치(도킹 위치 0)로 덮인다 → 11-04 에 실제로 겪음, '복구 배치 1104' 프리셋으로 되살림. |
| **보정 자세 이름 = 로봇 기준 mm** | 이동 블록을 자세로 등록하면 이름이 `A팔 보정 (X+210, Y-37)` (로봇 기준 좌표만, 도킹 이름 없음). 로봇 기준 같은 자리(10mm 안)의 보정이 이미 있으면 새로 만들지 않고 그것을 연다 → 보정 자세 수 ≤ 팔이 닿는 점의 수. 시작할 때 예전 이름을 이 형식으로 바꾸고 같은 자리 중복은 최근 것만 남긴다 (`_rename_slot_poses`). |
| 배치 불러오기 = 로봇 자리도 저장 | `_factory_apply` 가 로봇을 save=False 로 옮겨서, 다시 켜면 로봇이 옛 자리(0,0)로 돌아가던 문제. `h_factory_load` 가 S['robot_xy'/'robot_yaw'] 도 저장한다. |
| **놓은 자리 기억 → 다시 잡기** | 놓기 바닥에서 꽂힌 채(A1)·놓은 뒤(A2) 실제 각도를 읽어 A1-A2(소켓이 팔을 끌어준 양)를 그 도킹에 기억(SEAT_MEM). 같은 로봇 자리·같은 도킹 축에서 그 펜을 잡을 때 이만큼 더해 내려간다(SEAT_FIX, 실물만, j1~j4, 4°/10mm 넘으면 안 씀). 놓기·잡기 명령 좌표는 틱까지 같았는데 다시 내려갈 때 펜 머리를 찍던 문제. 로그: [꽂힘 자리] |
| 자리 보정 높이 페이드 | 보정 자리 바로 위(5mm)면 높이와 상관없이 100% — 이동의 마지막 하강에서 옆으로 4mm 밀리던 것 |
