Mlngyu-Park/2026ESWContest_free_A_IndustryGyuArm/RACHEL.md

# RACHEL — 말을 블록으로 바꾸는 25MB 자체 AI

**R**obot **A**rm **C**ommand **H**andling **E**mbedded **L**anguage-model

```
사람의 언어 (자연어) ──[ RACHEL ]──▶ 중간 다리 (블록) ──[ 계산 · 디지털 트윈 ]──▶ 로봇의 언어 (모터 제어)
```

사람이 한국어로 말하면 RACHEL 이 그 말을 **블록 코딩의 블록**으로 바꾼다.
블록을 실제 관절 각도와 경로로 바꾸는 일은 AI 가 아니라 **계산**이 하고, 실물로 보내기 전에 디지털 트윈에서 먼저 검증한다.
AI 는 해석만 하고 제어에는 손대지 않는다. 그래서 모델이 작아도 되고, 로봇이 AI 의 실수를 그대로 따라 하지 않는다.

모델 구조, 글자 사전, 학습 데이터, 학습 코드(PyTorch), C++ 추론 엔진, FPGA TPU 까지 전부 직접 만들었다.
TPU 는 [DUSK_BOOM.md](DUSK_BOOM.md) 에 따로 정리했다.

🎬 영상: [한이음 드림업 — 자체 개발 AI 'RACHEL' 기반 자연어 음성 로봇팔 제어 · 디지털 트윈](https://www.youtube.com/watch?v=7IwZH8eliuM) (2026-09, 한 팔 RACHEL 시기) · [임베디드SW경진대회 시연 영상](https://www.youtube.com/watch?v=rnEmlPO3QYE)

---

## 1. 한눈에 보기

| 항목 | 더블 레이첼 (지금 쓰는 판, 두 팔용) |
|---|---|
| 하는 일 | 지저분한 한국어 말 → 두 팔 로봇 블록 |
| 구조 | 글자 단위 GPT (디코더만 있는 트랜스포머), PyTorch 로 직접 구현 |
| 크기 | 파라미터 2,560만 개 · 가중치 파일 **25.6MB** (int8) |
| 층 / 차원 / 헤드 | 10 / 448 / 8 |
| 한 번에 읽는 길이 | 768글자 |
| 글자 사전 | 2,502자 (자주 쓰는 한글 2,350자 + 영문·숫자·기호 + 낱자모) |
| 학습 | DGX Spark GPU 1장 · 사람이 라벨을 단 데이터 0줄 (전부 규칙으로 합성) |
| 실행 | CPU (C++ 엔진, 외부 라이브러리 없음) 또는 직접 만든 FPGA TPU |
| 실제 말 시험 | 사용자의 실제 음성 명령 87문장 → **87/87** |

---

## 2. 작동 원리 — 4단계

예: 발표 자료의 문장을 지금 모델에 그대로 넣은 결과.

```
말:    "펜을 잡고 파란색 도킹스테이션으로 옮기고, 다음에 빨간색으로 옮겨"

① 글자 쪼개기   펜 / 을 / (띄어쓰기) / 잡 / 고 / …
② 입력 만들기   팔 A=빨강 B=파랑 | 보라=d2 파랑=d4 빨강=d10 | 펜=초록@d2   ← 공장 화면을 한 줄로
③ 읽기          "펜" 이 대상, "파란색" 다음 "빨간색" 이 순서라는 걸 파악
④ 블록 쓰기     펜을 파란색으로 옮긴 다음 빨간색으로 옮겨
                =move_to:펜 grab:pen move_to:파랑 release:파랑 grab:pen move_to:빨강 release:빨강

앱 블록:  이동 #2 → 잡기 펜 → 이동 #4 → 놓기 #4 → 잡기 펜 → 이동 #10 → 놓기 #10
```

### ① 글자 쪼개기

말을 **글자 하나하나**로 쪼개 글자 사전의 번호로 바꾼다 (`nano_norm/tok_norm.py`).
- 사전 = 자주 쓰는 한글 2,350자 + 영문·숫자·기호 + 낱자모(ㄱ~ㅣ).
- 사전에 없는 한글 음절은 낱자모로 풀어서 넣는다. "모르는 글자" 로 뭉개지지 않게.
- 단어 단위가 아니라 글자 단위인 이유: 음성 인식은 띄어쓰기와 받침을 자주 틀린다 (도킹 → 토킹·도킨, B팔 → 비팔·B8팔).

### ② 입력 만들기 — 공장 화면을 글로

모델은 화면을 볼 수 없다. 그래서 앱이 지금 공장 배치를 **한 줄**로 만들어 말 앞에 붙인다.

```
팔 A=빨강 B=파랑 | 보라=d2 파랑=d4 빨강=d10 | 펜=초록@d2
```

팔 이름과 색, 도킹 색과 번호, 펜이 꽂힌 자리. 색과 도킹의 짝은 배치마다 다르므로 외우게 하지 않고 **이 줄을 읽고 답하게** 학습했다.

### ③ 읽기 — 트랜스포머

최대 768글자 안의 **모든 글자 사이의 관계**를 본다 (어텐션).
"빨간색" 과 "옮겨", "다음에" 같은 순서 표현을 서로 이어서, 무엇을 어떤 순서로 해야 하는지 파악한다.

### ④ 블록 쓰기

한 글자씩 써 나간다. 매 글자마다 다음에 올 글자를 계산하고 **가장 가능성이 높은 글자**를 고른다. 그래서 같은 말은 늘 같은 답이 된다.
모델이 쓰는 답은 두 줄이다.

1. **정리문** — 지저분한 말을 정해진 꼴로 다시 쓴 문장. "음…", "아 아니", 잡담, 고쳐 말하기가 여기서 빠진다.
2. **이름 블록** — 도킹을 번호가 아니라 **색 이름**으로 쓴 블록 (`move_to:파랑`).

### ⑤ 검사 — AI 출력을 그대로 믿지 않는다

모델 출력은 블록이 되기 전에 **계산으로 9가지를 검사**한다 (`nano_double/check.py`).

| | 검사 |
|---|---|
| ① | 정리문이 문법에 맞나 |
| ② | 모델이 쓴 블록이 정리문을 계산으로 푼 블록과 같나 |
| ③ | 말에 없는 색·번호를 지어내지 않았나 |
| ④ | 말에 '팔' 이 없는데 팔을 지어내지 않았나 |
| ⑤ | 명령을 지우지 않았나 |
| ⑥ | 뒤쪽 단계를 빠뜨리지 않았나 |
| ⑦ | 가운데 단계·기다리기를 빠뜨리지 않았나 |
| ⑧ | 말이 분명히 부른 팔을 다른 팔로 바꾸지 않았나 |
| ⑨ | 출발지를 목적지로 바꾸지 않았나 |

- 걸리면 조금씩 다르게 6번 더 뽑아, 검사를 통과한 답 중 가장 많이 나온 것을 쓴다.
- 그래도 없으면 **실행하지 않고** "못 알아들었다" 고 말한다. 실물이 움직이는 시스템에서는 틀린 답보다 못 한다는 답이 낫다.

### ⑥ 이름 → 번호 → 앱 블록

- `move_to:파랑` → `d4` 처럼 색 이름을 도킹 번호로 바꾸는 일은 **계산**이 한다 (`canon.resolve`). 사전 찾기는 계산이 완벽하게 하는 일이라 모델에 시키지 않는다 (4장).
- 이름 블록은 앱 블록과 1:1 로 바뀐다: `arm:A`→팔 고르기, `move_to`→이동, `grab`→잡기, `release`→놓기, `wait:10`→10초 기다리기.
- 그다음은 ARM STUDIO 가 기구학으로 경로를 만들고, 3D 디지털 트윈에서 검증한 뒤 실물로 보낸다 → [ARM_STUDIO.md](ARM_STUDIO.md).

두 팔 예 (지금 모델로 실제로 돌린 결과):

```
말:   빨간 팔이 보라색에 있는 펜 잡아서 노랑에 두고 10초 뒤에 파란 팔이 그거 초록으로 옮겨
정리: A팔: 보라색 도킹의 펜을 노란색으로 옮겨 / 10초 기다려 / B팔: 노란색 도킹의 펜을 초록색으로 옮겨
블록: [A팔] 이동 #2 → 잡기 → 이동 #12 → 놓기 #12 → 10초 기다리기 → [B팔] 이동 #12 → 잡기 → 이동 #5 → 놓기 #5
```

---

## 3. PyTorch 로 직접 만들고 학습시킨 과정

### 3-1. 모델 — 남의 모델을 가져오지 않았다

`nano_norm/model.py` (한 팔 판은 `nano_llm/model.py`). PyTorch 의 기본 부품(Linear, LayerNorm, Embedding)만으로 GPT 구조를 직접 짰다.

- 트랜스포머 블록 = LayerNorm → 어텐션 → 잔차, LayerNorm → MLP(4배 넓힘, GELU) → 잔차.
- 어텐션도 직접 짰다. PyTorch 의 `nn.MultiheadAttention` 은 마스크를 주면 빠른 경로를 못 타서 DGX Spark(GB10)에서 한 걸음에 1,972ms 가 걸렸다. `scaled_dot_product_attention(is_causal=True)` 로 바꿔 같은 계산을 빠른 커널로 돌렸다.
- 출력층은 입력 임베딩과 가중치를 같이 쓴다 (파라미터 절약).

### 3-2. 데이터 — 사람이 한 줄도 만들지 않았다

`nano_norm/gen_norm.py`(말투 엔진) + `nano_double/gen_double.py`(두 팔·장면).

- 생성기가 **정답(정리문)을 먼저 정하고**, 그 정답을 사람 말투로 지저분하게 만든다.
- 블록은 정답 정리문에서 계산으로 만든다 → **라벨이 틀릴 일이 없다.**
- 1차 학습 150만 쌍. 그 뒤로는 차수마다 새 말투를 넣은 데이터(예: 7차 42만 쌍, 9차 36만 쌍)로 앞 차수에서 이어서 학습했다.

생성기가 넣는 말투 (전부 실제로 들은 말에서 가져온 종류):

| 종류 | 예 |
|---|---|
| 잇는 말 | 옮긴 다음, 옮긴 후, 뒤에, 하고 나서, 옮긴 담에 |
| 잡기 말씨 | 잡아서, 갖고, 들고, 가지고, 꺼내다가 |
| 군말·머뭇거림 | 야, 어, 음…, 빨간…색 |
| 고쳐 말하기 | 빨강, 아 아니 파랑으로 (마지막 말이 정답) |
| 앞뒤 잡담 | "네, 그냥 들어가면 돼요? 내가 하고 싶은 공정은 …" |
| 음성 인식 오타 | 도킹→토킹·도킨, 펜→팬, B팔→비팔·B8팔 |
| 두 팔 | 빨간 팔이 …, 그다음 파란 팔이 받아서 …, 10초 있다가 |
| 명령 아님 | 잡담, 칭찬 → 빈 블록 |
| 헷갈리는 낱말 | 비우고, 비닐, 비켜 → B팔로 읽지 않게 |

### 3-3. 학습

`nano_double/train_double.py`

```
한 줄:  <장면>\n<말>\n><정리문>\n=<블록><eos>
```

- 손실은 `>` 뒤(답)에만 건다. 장면과 말을 외우는 데 용량을 쓰지 않게.
- 말이 길면 **말의 앞부분**을 자른다. 장면 줄은 절대 자르지 않는다.
- AdamW, bf16, 배치 128. 처음은 학습률 4e-4, 이어서 배울 때는 1e-4 로 짧게. 1000걸음마다 저장하고 자동 채점.
- DGX Spark GPU 1장. 학습만 GPU 를 쓰고, 실행은 CPU 또는 TPU.

### 3-4. 가볍게 만들기

- `export_double.py` → 가중치를 **int8 + 텐서마다 배율 하나**로 저장 (RCHL 형식). PyTorch 체크포인트 98MB → **25.6MB**.
- 처음엔 활성값까지 int8 로 했다가 "겨겨겨겨" 같은 출력이 나왔다. 작은 모델은 활성값 분포가 좁아 뭉개지면 정보가 사라진다. 그래서 가중치만 int8, 계산은 float (W8A32).
- C++ 엔진(`rachel_cpp/rachel.cpp`)이 이 파일을 읽는다. 파이썬·PyTorch 없이 실행 파일 하나.
  KV 캐시(이미 계산한 글자는 다시 안 함), 상주 모드(엔진을 띄워 두고 문장만 주고받음), 일꾼 스레드에 행렬 행 나눠 맡기기.
  노트북 CPU 기준 문장당 0.77초 → **0.31초**, 답은 같음.

### 3-5. 채점 — 안 본 문장으로 고른다

- **실제 말 87문장**(사용자 실제 음성 명령)은 채점에만 쓰고 학습에는 넣지 않았다.
- 실제 말에서 틀린 말투의 **종류**는 생성기에 넣었으므로, 그것만으로는 완전히 처음 보는 시험이 아니다. 그래서 **생성기에 넣지 않은 말씨로 미리 만든 시험지**를 따로 둔다 (말씨 격자 1·2·3, 팔 이름, '비…' 낱말, 손으로 쓴 세트3).
- '맞음', '거부', **'틀린 채 실행'** 을 따로 센다. 가장 위험한 것은 틀린 채 실행이다.
- 고르는 규칙: 모든 시험에서 틀린 채 실행 0 → 그중 안 본 시험 점수가 가장 높은 것.

---

## 4. 정확도를 올린 방법 — "덜 시키기"

### 4-1. 사전 찾기는 신경망에 시키지 않는다 (한 팔 RACHEL, v1→v4)

| 판 | 접근 | 색 지칭 정확도 |
|---|---|---|
| v1 | 장면표를 주고 모델이 찾게 함 | 62.7% |
| v2 | 표 방향을 '색=도킹' 으로 | 65.2% |
| v3 | 찾은 결과를 먼저 쓰게 함 | 64.0% |
| v4 | **찾기를 계산(전처리 33줄)으로 뺌** | **99.6%** |

모델 크기나 학습량이 아니라, **신경망에 무엇을 시키고 무엇을 계산에 넘기느냐**가 정확도를 정했다.
더블 레이첼 2차에서 같은 일이 다시 일어났고(모델이 쓴 블록 55%, 정리문을 계산으로 풀면 87%), 3차에서 같은 방법(이름 블록 + 계산)으로 풀었다.

### 4-2. 실제 말에서는 56% 였다 → 말투 데이터로 다시

한 팔 RACHEL v9 는 합성 시험 98.5% 였지만, 사용자의 실제 음성 명령에서는 **49/87 (56%)** 였다.

- 학습 문장은 최대 51자인데 실제 말은 중간값 73자, 최대 221자.
- "옮긴 후·뒤·나서" 같은 잇는 말이 학습 데이터에 0번.
- 글자 사전이 179자라 실제 말 106문장 중 87문장에 모르는 글자가 있었다.

모델 크기가 아니라 **데이터의 말투** 문제였다. 그래서 더블 레이첼은 글자 사전을 2,502자로, 읽는 길이를 768글자로 늘리고 말투 엔진으로 데이터를 새로 만들었다.

### 4-3. 차수별 기록 (더블 레이첼)

| 차수 | 바꾼 것 | 결과 |
|---|---|---|
| 1차 | 150만 쌍, 처음 학습 | 실제 말 아직 약함 |
| 2차 | 실제 말에서 틀린 말투 9가지 | 블록의 '색→번호 찾기' 가 자주 틀림 |
| 3차 | **블록을 이름 블록으로**, 번호 찾기는 계산 | 실제 말 92% |
| 4차 | 팔 위치·넘겨받기·'다시 X에' 등 | 실제 말 86/87, 틀린 채 실행 0 |
| 5차 | 실제 말에 맞춘 말투 | 새 문장에서 나빠져 **버림** |
| 6차 | 잡기 말씨 25꼴·동사·맺음 어미 | 2000걸음만 모든 시험 틀린 채 실행 0 |
| 7차 | 잇는 말 자리에 **아무 말** (목록 외우기 대신 원리) | 격자3 99 → 144 |
| 8차 | 팔 이름 꼴 (비팔·B8팔) | 팔 시험 69 → 139, 그러나 '비우고' 를 B팔로 읽음 |
| 9차 | '비…' 낱말 반례 | 비 낱말 52/52 |
| 10차 | 경유 말투 ("주황색 거쳐서") | 생성기·시험지 준비 |

5차에서 배운 것: 실제 말에 맞춰 고친 모델이 그 문장들은 다 맞혔지만 새로 쓴 40문장에서는 나빠졌다.
그 뒤로는 시험지를 생성기보다 **먼저** 만들고, 안 본 시험에서 틀린 채 실행이 없는 것을 고른다.

---

## 5. 성적

### 5-1. RACHEL vs Gemma 4 E4B (같은 200문장, DGX Spark 한 대)

Gemma 4 E4B 는 추가 학습 없이 프롬프트 엔지니어링만으로 같은 일을 시켰다.

| | 정확도 | 크기 | 실행 장치 |
|---|---|---|---|
| 규칙 파서 (AI 없음) | 30.0% (60/200) | — | — |
| Gemma 4 E4B | 39.0% (78/200) | 5.15GB | GPU |
| **RACHEL v9 (한 팔)** | **98.5% (197/200)** | **10.1MB** | CPU 1스레드 |

### 5-2. 더블 레이첼 — 지금 앱에 들어 있는 모델 (9차, 2026-11-03)

| 시험 | 맞음 | 틀린 채 실행 |
|---|---|---|
| 실제 말 (옮기기 명령) | **87/87** | 0 |
| 실제 말 (명령 아님) | 11/11 | 0 |
| 말씨 격자 1 | 384/384 | 0 |
| 말씨 격자 2 (생성기에 없는 말씨) | 156/156 | 0 |
| 말씨 격자 3 (생성기보다 먼저 만든 시험지) | 144/152 | 0 (나머지는 거부) |
| 팔 이름 (비팔·B8팔·둘째 팔 …) | 147/151 | 0 |
| '비…' 낱말 (비우고·비닐 …) | 52/52 | 0 |
| 손으로 쓴 세트3 | 33/37 | 2 |

PyTorch(GPU)로 채점한 결과와 C++ 엔진으로 채점한 결과가 같다.

### 5-3. 속도

| 실행 장치 | 한 문장 |
|---|---|
| 노트북 CPU (C++ 엔진) | 0.31초 |
| DUSK_BOOM 보드 CPU 만 | 14.2초 |
| **DUSK_BOOM TPU** | **2.66초** (글자 하나에 27~40ms) |

자세한 것은 [DUSK_BOOM.md](DUSK_BOOM.md).

---

## 6. 앱에서 쓰는 법

ARM STUDIO 의 「말로 만들기」 에서 AI 를 고른다.

| 선택 | 동작 |
|---|---|
| 자동 | Spark 서버가 있으면 Gemma → 없으면 **더블 레이첼** → 그것도 안 되면 규칙 파서 |
| 더블 레이첼 | 내장 자작 모델만 (LattePanda Mu 시연 설정) |
| 규칙 파서 | AI 없이 정규식 해석 (마지막 대비책) |

앱 연결 코드: `Industry_gyu_arm/arm_studio_web.py` 의 `_rachel2_parse`, `_llm_parse`.

---

## 7. 파일 위치

| 무엇 | 어디 |
|---|---|
| **더블 레이첼** (지금 쓰는 것) | `Industry_gyu_arm/nano_double/` |
| ├ 앱이 부르는 곳 (엔진 + 검사 + 블록 변환) | `rachel2.py` |
| ├ 정리문 문법 · 블록 이름 · 이름→번호 | `canon.py` |
| ├ 출력 검사 ①~⑨ | `check.py` |
| ├ 학습 데이터 생성 | `gen_double.py` (옛 판 `gen_double_v3~v5.py`, 10차 `gen_double_v10.py`) |
| ├ 학습 · 내보내기 (PyTorch) | `train_double.py` · `export_double.py` |
| └ 시험지 · 채점 | `make_grid*.py` · `eval_gpu.py` · `eval_cpp.py` · `eval_grid.py` |
| 말투 엔진 · 글자 사전 · 모델 구조 | `Industry_gyu_arm/nano_norm/` (`gen_norm.py` · `tok_norm.py` · `model.py`) |
| C++ 추론 엔진 | `Industry_gyu_arm/rachel_cpp/rachel.cpp` |
| 한 팔 RACHEL (v1~v9) | `Industry_gyu_arm/nano_llm/` |
| TPU 판 엔진 | `dusk_boom_fpga_v35/tpu/sw/rachel_tpu.cpp` → [DUSK_BOOM.md](DUSK_BOOM.md) |

그때그때 쓴 자세한 기록 (숫자는 그 시점 기준): `nano_llm/더블레이첼_계획.md` (차수별 진행), `nano_llm/RACHEL_한계와_v10계획.md` (실제 말 56% 분석), `nano_llm/MAKING_RACHEL.md` (v1~v4).

**가중치(`double.bin` 25.6MB, `double.pt` 98MB)와 글자 사전(`vocab.json`)은 용량 때문에 저장소에 넣지 않았다.** 아래 순서로 다시 만들 수 있다.

---

## 8. 다시 만들기

```bash
cd Industry_gyu_arm/nano_double

# 1) 데이터 (정답 정리문 → 지저분한 말, 블록은 계산)
python gen_double.py --show 30                    # 예시 30개 보기
python gen_double.py 1500000 > double_data.jsonl  # 150만 쌍

# 2) 학습 (PyTorch, GPU) — vocab.json 도 여기서 만든다
DBL_DIM=448 DBL_LAYER=10 DBL_CTX=768 python train_double.py

# 3) int8 가중치로 내보내기
python export_double.py double.pt double.bin

# 4) C++ 엔진 빌드 (-ffast-math 가 없으면 4배 느리다)
cd ../rachel_cpp
g++ -O3 -march=native -ffast-math -pthread -o rachel rachel.cpp

# 5) 한 문장 시험
cd ../nano_double
python rachel2.py double.bin \
  "팔 A=빨강 B=파랑 | 보라=d2 파랑=d4 빨강=d10 | 펜=초록@d2" \
  "펜을 잡고 파란색 도킹스테이션으로 옮기고, 다음에 빨간색으로 옮겨"
```

---

## 9. 남은 것

- **경유 말투** — "주황색 거쳐서 빨간색으로" 의 경유지를 빠뜨리는 문제 (10차).
- **새 동작** — 버튼 누르기, 펜이 아닌 물건 잡기, 두 팔 동시 공정. AI 가 하는 일은 그대로 "블록 나열" 이고, 블록 이름만 늘린다.
- 실제 말 시험은 화자 한 명 기준이다. 여러 사람의 말로 넓혀야 한다.
