Mlngyu-Park/2026ESWContest_free_A_IndustryGyuArm/Industry_gyu_arm/nano_llm/더블레이첼_계획.md

# 더블 레이첼 계획 (2026-10-30)

## 1. 결정한 것
| 항목 | 결정 |
|---|---|
| 레이첼 개수 | **하나** — 더블 레이첼 (두 팔용) |
| 하는 일 | 사람 말 → 두 팔 블록을 **직접** 쓴다 |
| 중간 공정 자동 짜기 | **뺀다** (계산이든 AI 든). 공정은 사람이 말한다 |
| 팔 부르기 | A팔·B팔, 또는 색 (빨간 팔·파란 팔·노랑 팔) |
| B팔 | A팔 **복제**. 같은 모델이라 도달표(로봇 기준 상대 좌표)도 그대로 복사 |
| 정형 영어 | 따로 단계를 두지 않는다 — **블록 이름 자체를 정형 영어로** |
| 가장 중요한 것 | 레이첼을 만드는 것보다 **사람의 여러 말투를 다 알아듣는 것** |

### 말 정리기는?
"레이첼은 하나" 에 맞춰 **따로 돌리지 않는다**. 대신 말 정리기를 만들며 만든
**말투 생성기**(`nano_norm/gen_norm.py`)를 더블 레이첼의 학습 데이터 만드는 데 쓴다.
→ 지저분한 말을 레이첼이 **직접** 알아듣게 한다. 모델 크기는 키워도 된다(사용자).

## 2. 블록 이름 (정형 영어)
| 블록 | 뜻 | 앱 안의 지금 블록 |
|---|---|---|
| `arm:A` / `arm:빨강` | 이 뒤의 블록은 이 팔이 한다 | (새로 — 팔 고르기) |
| `move_to:d3` | 그 자리로 이동 | `@goto:d3` |
| `grab:pen` | 잡기 | `@grasp:ppap` |
| `release:d3` | 놓기 | `@release:d3` |
| `wait:10` | 10초 기다리기 | (새로) |

- 앱 안의 블록 이름은 바꾸지 않고, 레이첼 출력 → 앱 블록을 **1:1 표로** 바꾼다 (앱이 깨지지 않게).
- 나중 동작(버튼 '누르기' 등)은 이 표에 한 줄씩 더한다 — AI 는 블록 나열 그대로, 어휘만 늘린다.

예) "빨간 팔이 보라색에 있는 펜 잡아서 노랑에 두고, 10초 뒤에 파란 팔이 그거 초록으로 옮겨"
```
arm:빨강 move_to:보라 grab:pen move_to:노랑 release:노랑
wait:10
arm:파랑 move_to:노랑 grab:pen move_to:초록 release:초록
```

## 3. 팔 이름 규칙
- **'팔'(로봇팔) 이 붙어야 팔** — 도킹도 색으로 부르므로 "빨간 팔" ≠ "빨간 도킹".
- 말에 팔이 없으면: 바로 앞에 말한 팔. 처음부터 없으면 기본 팔(A팔).
- 레이첼 입력 장면 줄에 팔 정보를 넣는다: `팔 A=빨강 B=파랑`.
- 블록 화면에서도 스크래치처럼 팔을 고른다 (팔 블록 + 이름·색).

## 4. 말투 넓히기 — 핵심
기준: 사용자의 실제 음성 명령 `paper_evidence/15_REAL_VOICE_1028.json`
(98문장 · 명령 87 · 명령 아닌 말 11 · 명령 길이 중앙 73자, 최대 221자 · **지금 맞춤 49/87 = 56%**)

| 종류 | 예 | 지금 |
|---|---|---|
| 연결어 | 옮긴 **다음**, 옮긴 **후**, **뒤에**, 하고 **나서** | 학습 0회 (후·뒤·나서) — 가장 약함 |
| 앞뒤 잡담 | "네, 그냥 들어가면 돼요? … 내가 하고 싶은 공정은 …" | 실제 말에 많음 |
| 고쳐 말하기 | "빨강, 아니 파랑으로" | |
| 희망·부탁 말투 | "~하고 싶어", "~해 줄래?", "~하는 그 공정" | |
| 음성 인식 오타 | 피피에이피·PPAP, 도킹 스테이션·도킨 | |
| 되돌리기·반복 | "다시 원래 자리로", "한 번 더" | |
| 명령 아님 | "멈춰", 잡담 | → 빈 블록 |
| **두 팔** (새로) | "빨간 팔이 …", "그다음 파란 팔이 받아서 …", "10초 있다가" | 없음 |

- 실제 말의 틀린 것을 종류별로 모아 **그 종류를 생성기에 더하고 → 다시 학습 → 다시 채점** 을 반복한다.
- 실제 문장 자체는 **채점에만** 쓰고 학습에는 넣지 않는다 (점수가 부풀지 않게).

## 5. 돌리는 구조
```
사람 말 → 더블 레이첼 (여러 번 뽑기) → 검사(계산) → 다수결 → 블록 → 앱
```
- **검사(계산)**: 입력에 없는 색·번호가 나왔나, 문법이 맞나, 그 팔이 그 자리에 닿나 (도달표).
- **다수결(실험)**: 매번 조금씩 다르게 뽑아야 의미가 있다. 우연히 틀리는 건 고쳐지지만,
  학습에 없던 말투는 다수결로 못 고친다 → 그건 4번(말투 넓히기)이 고친다.
- 검사를 통과한 답이 없으면 실행하지 않고 "못 알아들었다" 고 말한다.

## 6. 학습
- 스파크에서. 데이터 = `gen_data.py`(블록 정답) + 말투 생성기(`gen_norm.py`) + 두 팔 문장.
- 지금 v9 의 한계(문맥 448 · 어휘 179자 · 도킹 번호 2~14 · 학습 문장 최대 51자)를
  실제 말 길이(최대 221자)에 맞게 늘린다.

## 7. 오늘 밤 순서
- [ ] ① 지금 상태 확인 — 레이첼 v9, 말 정리기 학습 결과, 실제 말 채점
- [ ] ② 블록 이름 표·팔 규칙 확정 (이 문서 2·3장)
- [ ] ③ 두 팔 말투까지 데이터 생성기 넓히기
- [ ] ④ 더블 레이첼 학습 (스파크)
- [ ] ⑤ 실제 말로 채점 → 틀린 종류를 데이터에 반영 → 반복
- [ ] ⑥ 여러 번 뽑기 + 검사 + 다수결 실험 (뽑는 횟수별 정확도)
- [ ] ⑦ 보고 (완료/남은 것)

## 9. 진행 기록 (10-30 밤)
| 시각 | 한 일 | 결과 |
|---|---|---|
| 00:40 | 말 정리기(10-29 학습)를 실제 말로 채점 | **이송 56% → 92% (80/87)**, 명령 아님 5/11 → 10/11 — 말투 생성기가 실제 말에 통한다 |
| 00:45 | `nano_double/` — 정리문 해석기(`canon.py`)·검사(`check.py`)·두 팔 생성기(`gen_double.py`) | 출력 = `정리문\n=블록` 한 모델 |
| 00:47 | 1차 학습 (150만 쌍, d448 L10 ctx768, 25.6M) | 2000걸음 합성 31% — 실제 말은 아직 약함, 대부분 '정리문 맞고 블록 줄 틀림' 을 검사가 막음 |
| 00:55 | 2차 생성기 — 실제 말에서 틀린 7문장의 말투 9가지 추가 | 조사 실수·말 다시 시작·무시할 동작·같은 목적지 다시 말하기·끝 반복·같은 자리·펜 없이 짧게·출발지 정정·긴 잡담 / 두 팔: X에서 Y로·팔 정정·다른 팔은 쉬고 |
| 01:15 | 2차 학습 (2000걸음에서 이어서, 2에폭 약 4시간) + 중간 저장마다 자동 채점 | `evals_v2.log` (스파크 `~/arm_eval/nano_double/`) |
| 01:20 | C++ 엔진: 온도 뽑기(`RACHEL_TEMP`/`RACHEL_SEED`, 기본은 그대로) · 답 안 줄바꿈 | v9 출력 그대로 확인 |
| 01:25 | 앱: `@arm:A` · `@wait:10` 블록 (팔레트·파이프라인 팔 표시·실행·미리보기), AI 모델 '더블 레이첼', 팔 이름·색 설정 | 연습용 복사본에서 확인 |
| 01:40 | 2차 2000걸음 채점 | 실제 말 한번 55% / **정리문+계산 87%** — 틀리는 곳은 블록 줄의 '색→도킹 번호 찾기' |
| 01:45 | **3차: 블록 줄을 '이름 블록' 으로** (`move_to:보라` · `#3` · `펜`), 번호 찾기는 계산(`canon.resolve`) | 앱 주석의 교훈 "조회를 모델에 맡기면 64%, 계산으로 99.6%" 와 같은 결론 |
| 02:08 | 3차 2000걸음 | **실제 말 이송 92% (80/87)**, 두 팔 세트1 30/30, 세트2(다른 말투) 23/30 |
| 02:15 | 4차 생성기 — 팔을 중간·맨 뒤에 · 넘겨받기 말 안 함 · '다시 X에' · 팔+조작 · 도킹 잡담 · 'X, Y 순서로' · 잡은 뒤 '그 초록색 펜을' · 같은 자리 다시 말하기 | 3차 4000걸음에서 이어 학습 (스파크에서 자동 전환) |
| 02:20 | 앱: **두 팔 3D 트윈** — B팔 = A팔 복제(같은 URDF·도달표), 팔 블록에서 '지금 팔' 을 바꿔 이동·잡기·놓기가 그 팔 기준, 팔마다 그 팔 색, B팔 자리 저장, 블록별 도달 표시도 그 팔 기준, 실물 실행은 B팔이 있으면 시작 전에 막음 | 연습용 앱에서 A팔→3초→B팔 넘겨받기 재생·스크린샷 확인 |
| 02:30 | 버그 수정 ① 시작 메시지 한 줄이 앱 시작을 막던 것(10-29 내가 넣음) ② `seq_fix_moves` 가 펜 이동을 추적하지 않아 재시작 때 2단계 이송의 두 번째 잡기 앞에 엉뚱한 이동을 끼우던 것 | 연습용 복사본에서 확인 |
| 02:55 | 4차 2000걸음 | **실제 말 이송 94% (82/87), 다수결 95%**, 두 팔 세트1 30/30, 세트2 25/30 |
| 03:00 | 다수결 곡선 (뽑기 1·2·3·5·9·17개) | **거의 안 오름** (실제 말 82→82, 두 팔 55→56) — 남은 오류는 모델이 확신을 갖고 틀리는 것(덜 배운 말투). 다수결은 정확도보다 '애매하면 거부' 안전장치로 → 앱은 '검사에 걸릴 때만 6개 더 뽑기' |
| 03:20 | 4차 4000걸음 | 두 팔 손 문장 **60/60**, 실제 말 이송 81/87 |
| 03:25 | 검사 보강 ① 펜 색은 색 검사에서 뺌 (모델이 장면의 펜 색을 끌어와 쓰는 건 블록과 무관) ② **뒤쪽 단계를 빠뜨렸나** (원문에서 마지막 목적지 뒤에 또 자리가 나오면 거부, 팔 색·펜 색 제외) | 4000걸음 출력 158문장: 맞음 142→**149**, 틀린 채 실행 7→**4**, 거부 9→5. 잘못 거부 = 합성 0/5000 · 실제 정답 0/87 · 손 0/60 |
| 03:25 | 앱 안전: 3D '지금 팔' 이 실물 팔이 아니면 실물 목표 쓰기·영점 저장을 막음 | 연습용 복사본에서 확인 |
| 04:07~04:53 | 4차 8000·10000·12000걸음 | 실제 말 이송 81→82→**83/87**, **틀린 채 실행 2→1→0**, 두 팔 손 문장 60/60 유지 |
| 05:05 | **앱에 12000걸음 설치** (`nano_double/double.bin`, 예전 6000걸음은 `double_v4_6000.bin.bak`) | 시험 문장 정상 · 0.7초 |
| 05:15 | 5차 생성기 — 12000걸음에서 거부된 실제 말 4종: 중간을 '…하면 좋겠어. 그 다음에' 로 끊고 그 자리 펜을 다시 잡기 · '있을/위치할 펜' · 펜을 빠뜨림 · '음,.....'·'빨간....색' 머뭇거림 · '다시 그렇게 공정을 끝내고 싶어' · 더 긴 잡담 | 생성 정답을 검사에 넣어 잘못 거부 5000 중 2 (4차 생성기 8). 4차가 끝나면 4차 마지막에서 이어 1에폭 (`switch_v5.sh`, `evals_v5.log`) |
| 05:40~07:05 | 4차 14000~22000걸음, 학습 끝 (총 273분) | 22000걸음: 실제 말 이송 한번 **85/87**, 검사+보충 **86/87 (99%)**, 틀린 채 실행 0, 명령 아님 **11/11**, 두 팔 손 60/60 |
| 07:10 | **앱에 22000걸음 설치** (예전 12000·6000 은 `.bak`) | 시험 문장 정상 · 0.8초 |
| 07:05 | 5차 학습 시작 (4차 마지막에서 이어 1에폭, 약 100분) | `evals_v5.log` |
| 08:38 | 5차 끝. 6000·7946걸음 모두 실제 말 98 + 손 60 **전부 맞음** | 그러나 실제 말에서 틀린 말투를 생성기에 넣었으므로 부풀었을 수 있음 |
| 09:30 | **세트3** (`dual_eval_hand3.json`, 5차 결과 보기 전에 새로 쓴 40문장)으로 공정 비교 | 검사+보충 맞음: 4차 22000 **33/40** · 5차 6000 31/40 · 5차 7946 32/40 → 5차는 낫지 않음(실제 말 98에 맞춰진 것). **앱은 4차 22000 유지** |
| | 세트3 에서 남은 약점 | ① 넘겨받는 팔이 'X에서 꺼내서' 라고 하면 X 를 목적지로 한 번 더 넣음(틀린 채 실행 2, 같은 자리 집었다 놓기) ② 'X로 Y에서 Z로' 나열만 하기 ③ 팔 이름 없이 기다리기 넣은 한 팔 공정에 A팔을 붙임(거부) ④ 장면의 펜 자리를 '2번 도킹' 으로 써서 검사가 거부 — 모두 다음 생성기 후보 |
| 10:00 | **말씨 격자** (`make_grid.py`): 동사·잡기 말씨·잇는 말·맺음 어미를 하나씩만 바꾼 문장. 세트1 384(6차 생성기에 넣는 말씨) · **세트2 156(생성기에 안 넣는 말씨 = 정직한 시험)**. 채점은 `squash`(같은 팔 다시 고르기·같은 자리 다시 가기 빼기)로 동작이 같으면 맞음 | 4차 22000: 세트1 372/384(틀린 채 실행 10 — 꺼내다가 0/4·챙겨서·꺼내 가지고·끼우다) · 세트2 150/156(틀린 채 실행 0, 거부 6 — '-ㄴ 담에'·'-ㄴ 다음 거기서') |
| 10:10 | 6차 (gen_double V6: 갖고·들고·가지고·꺼내다가 등 잡기 25꼴, 끼우다·옮겨 놓다·갖다 꽂다 등 동사 9, 맺음 어미 20, 잇는 말 7) 4차 22000에서 이어 1에폭 | `evals_v6.log` |
| 12:27 | 6차 끝. 맞음/틀린 채 실행 — 4차 22000: 실제 86/0 · 세트3 33/2 · 격자1 372/10 · 격자2 150/0 ‖ **6차 2000: 87/0 · 35/0 · 384/0 · 148/0** ‖ 4000: 86/1 · 34/1 · 384/0 · 149/2 ‖ 6000: 87/0 · 34/2 · 384/0 · 151/2 ‖ 7946: 86/1 · 35/1 · 384/0 · 150/2 | **어디서도 틀린 채 실행 0 은 6차 2000 뿐 → 앱 후보.** 더 배울수록 처음 보는 말씨에서 틀린 채 실행이 생김. 두 팔 문장은 모든 걸음 격자 전부 맞음 |
| 10-31 | '담에'·'거기서' 원인 (앱 모델로 12문장 직접 넣어 봄) | 모델이 **첫 단계만 쓰고 뒤를 버림** ('…옮긴 담에 노란색으로' → '파란색으로 옮겨'). 생성기에 이 잇는 말이 한 번도 없어서, 단계를 잇는 말을 '외운 목록'으로만 알아봄. '다음에'·'옮기고 담에'(‑고 가 아는 말)로 바꾸면 바로 맞음. 두 팔은 '파란 팔'·'B팔' 이 뒤 단계 신호가 되어 맞음. 검사가 '마지막 목적지 뒤에 자리' 로 거부해서 틀린 채 실행 0. 고칠 길: 잇는 말 자리에 아무 말이나 넣은 데이터로 '목적지가 더 나오면 단계가 더 있다' 를 배우게 (목록 늘리기보다 일반화) |

채점 방식 (`nano_double/eval_cpp.py`, 앱과 같은 C++ 엔진·CPU):
한번 / 한번+검사 / 정리문만(블록 줄 대신 정리문을 계산으로) / 다수결(8개 뽑기, 검사 통과한 것 중 최다).
'틀린 채 실행' 과 '거부' 를 나눠 센다 — 틀린 채 실행이 가장 위험하다.

## 10. 엔진 속도 (10-31)

`rachel_cpp/rachel.cpp` — 일꾼 스레드를 처음에 띄워 두고 행렬 곱셈의 행을 나눠 맡김 (기본 CPU 스레드의 절반, `RACHEL_THREADS` 로 바꿈).
노트북(8845HS, 8스레드): 문장당 0.77초 → **0.31초**, 예전 엔진과 답 120/120 같음 (온도 뽑기도 같음), 기다리는 동안 CPU 0.
채점(`eval_cpp.py`)은 엔진을 여러 개 동시에 돌리므로 엔진마다 1스레드. 예전 파일: `rachel*.bak_20261031`.
N305(4스레드) 예상: 문장당 약 0.6~0.8초 (재 보지 않음).

## 11. 7차 학습 계획 (아직 안 함)

**교훈**: 5차 = 실제 말 98에 맞춰져 새 문장에서 나빠짐. 6차 = 오래 배울수록 처음 보는 말씨에서 틀린 채 실행이 생김(2000걸음이 최고).
→ 짧게, 작은 학습률로, 1000걸음마다 저장·채점, **안 본 시험으로 고른다.**

1. **시험지를 먼저 만든다** (생성기 고치기 전에, 생성기에 넣지 않을 말씨로) — 격자 세트3
   - 처음 보는 잇는 말: 그 담엔 · 그러구서 · -구 나서(말할 때 '고'→'구') · -고 나선 · 하고서는 · 그런 담에
   - 음성 인식이 흔히 내는 모양: 띄어쓰기 없음('옮긴다음에') · '도킹'→'도킨'·'토킹' · 숫자 '이 번 도킹'
   - 세트3 약점 꼴: 넘겨받는 팔의 'X에서 꺼내서' · 자리만 나열('보라에서 노랑, 노랑에서 파랑') · 팔 이름 없는 한 팔 + 기다리기
2. **생성기 7차** (gen_double V7)
   - 핵심: **잇는 말 자리에 아무 말** — 아는 잇는 말 + 아무 낱말 1~3개(의미 없는 말 포함)를 섞어, '목적지가 더 나오면 단계가 더 있다' 를 배우게 한다. 목록을 외우는 대신 원리.
   - 세트3 약점 꼴을 생성기에 (시험지와 다른 낱말로)
   - 비율: 6차 데이터 70% 그대로(잊지 않게) + 새 꼴 30%
3. **학습**: 6차 2000걸음에서 이어, 약 3000걸음, 학습률 1e-4, 1000걸음마다 저장 + 자동 채점(실제 말 98 · 세트3 · 격자 1·2·3)
4. **고르는 규칙**: ① 모든 시험에서 틀린 채 실행 0 (필수) ② 안 본 시험(격자2·격자3·세트3) 합이 가장 높은 것 ③ 실제 말 86/87 이상. 없으면 앱은 그대로.
5. 시간: 생성 15분 + 학습 약 60분 + 마지막 채점 25분 ≈ 1시간 40분 (스파크)

**10-31 23:30 진행**
- 격자 세트3 (`make_grid.py` GRID_SET=3, `grid_eval3.json` 152문장) 을 생성기보다 먼저 만듦. 토킹·팬·'걸 다시'·'놓고서'·'옮긴다음에' 는 예전 데이터에 이미 있음(이미 본 말씨로 따로 셈).
- 6차 2000(앱) 격자3: 98/152, **틀린 채 실행 23** — 자리만 나열('찍고'·쉼표·동사 없음) 0/24, 팔 이름 없는 한 팔 기다리기 6/24, 잇는 말 담엔·-구·거기서 약함. 끼는 말('있잖아 그거')·음성 인식 모양은 거의 다 맞음.
- **검사 ⑦ 추가** (`check.py`): 가운데 단계 빠뜨림 · 기다리기 빠뜨림. 맞는 답 거부 0 (실제 말·손·격자1·2), 생성기 정답 5000 중 8, 세트3 틀린 채 실행 19 중 16 을 막음. 앱에 바로 적용됨 (예전 `check.py.bak_1031`).
- 7차 생성기 V7 (잇는 말 자리에 아무 말 20% · 끼는 말 · 자리만 나열 · 팔 이름 없는 한 팔 기다리기, 시험지 말은 BLOCK7 로 막음) 6×70000 → 6차 2000에서 이어 3258걸음, 1e-4, 1000걸음마다 저장(watch_v7.sh) → 채점 큐(auto_eval7.sh) → `evals_v7.log`. 기준(6차 2000, 새 검사)은 `evals_base6.log`.

**11-01 01:10 7차 결과** (채점은 학습 뒤 GPU `eval_gpu.py`, 고른 것만 C++ 확인 · 모두 새 검사 ⑦)
| 모델 | 실제 말 87 | 명령 아님 11 | 세트3 40 | 격자1 384 | 격자2 156 | 격자3 152 |
|---|---|---|---|---|---|---|
| 6차 2000 (앱, GPU) | 87 | 11 | 36 · 틀림 0 | 384 | 148 | 99 · 틀림 3 · 거부 50 |
| 7차 1000 (GPU) | 86 · 틀림 1 | 10 | 37 · 틀림 2 | 384 | 156 | 142 · 틀림 3 |
| **7차 2000 (GPU)** | **87** | 10 (거부 1) | **38 · 틀림 1** | 384 | **156** | **144 · 틀림 0** |
| **7차 2000 (C++ 확인)** | **87** | 10 (거부 1) | **38 · 틀림 1** | 384 | **156** | **144 · 틀림 0** |
| 7차 3000·3258 (GPU) | 86~87 | 10~11 | 38 · 틀림 1 | 384 | 156 | 141 · 틀림 2 |
- 7차 2000 의 틀림 1 = 세트3 "파란 팔이 노란색에서 그걸 가져다가 초록색에 꽂아" → 초록에 꽂은 뒤 같은 초록에서 다시 잡아 다시 꽂음 (펜 마지막 자리는 정답과 같음, 헛동작). 명령 아님 거부 1 = 긴 잡담에서 옮기기를 지어냈지만 검사가 막음.
- 격자3: 자리만 나열(동사 없음·쉼표) 0→16/16, 팔 이름 없는 한 팔 기다리기 6→24/24, '찍고' 8개는 모두 거부(틀린 채 실행 0). 격자2(담에·거기서·-고는) 148→156.
- 규칙 ①(모든 시험 틀린 채 실행 0)에는 헛동작 1개로 못 미침 → 사용자에게 물음 → **11-01 사용자 승인, 앱에 설치** (예전 6차 2000 은 `double_v6_2000.*.bak`).

**10-31 23:25 완료**: 스파크 통로 다시 연결(허락받음) → 6차 2000걸음을 앱에 설치 (내용 대조 일치, 예전 4차 22000 은 `double_v4_22000.*.bak`).

## 8. 나중 할 일
`../TODO.md` — 버튼·LED 누르기, 두 팔 동시 공정·펜 아닌 물건 잡기.
