Mlngyu-Park/2026ESWContest_free_A_IndustryGyuArm/stl/Industry_gyu_arm_20260727 - docking_station-5.STL

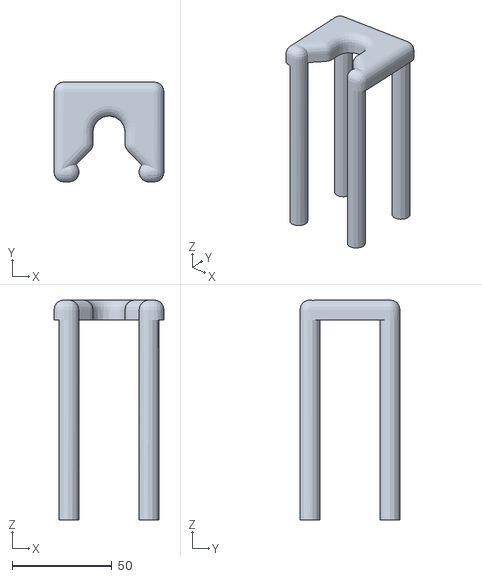
[picture p1: CAD file, 2026-11-05]
stl/Industry_gyu_arm_20260727 - docking_station-5.STL
55.0 x 50.0 x 110.0
