Mlngyu-Park/2026ESWContest_free_A_IndustryGyuArm/urdf/bricks/Industry_gyu_arm_20260809_ppap/meshes/ppap_l1.STL

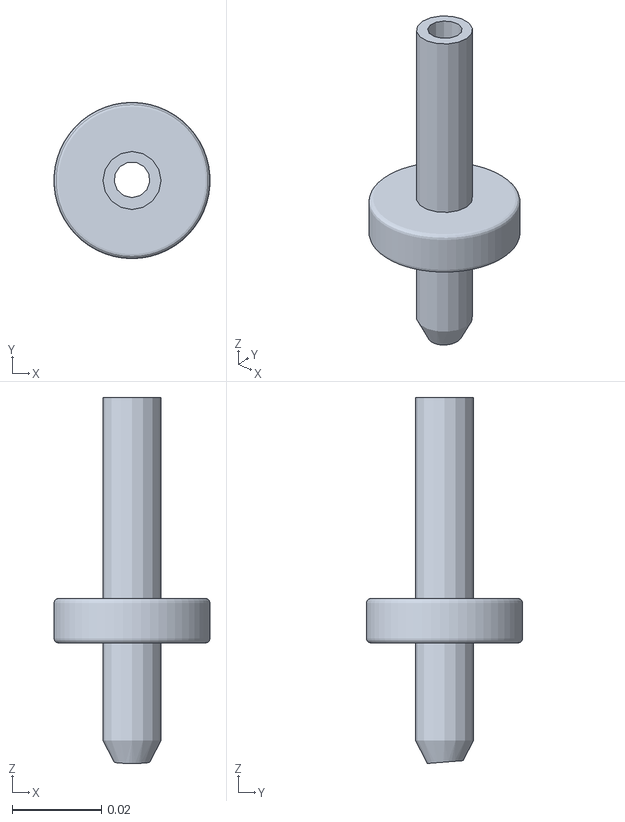
[picture p2: CAD file, 2026-11-05]
urdf/bricks/Industry_gyu_arm_20260809_ppap/meshes/ppap_l1.STL
0.0349 x 0.035 x 0.082
