Mlngyu-Park/2026ESWContest_free_A_IndustryGyuArm/urdf/sts3215/Industry_gyu_arm_20260809_base/meshes/l2.STL

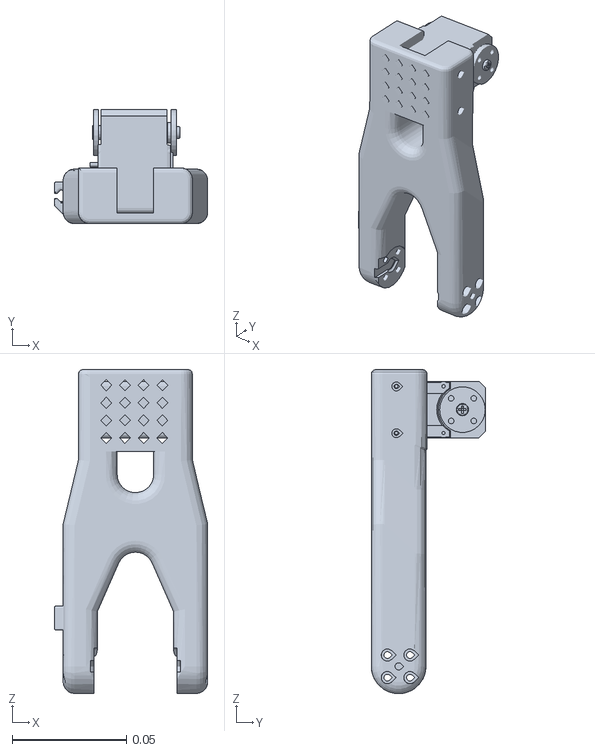
[picture p3: CAD file, 2026-08-09]
urdf/sts3215/Industry_gyu_arm_20260809_base/meshes/l2.STL
0.0673 x 0.0502 x 0.142
