Mlngyu-Park/2026ESWContest_free_A_IndustryGyuArm/stl/Industry_gyu_arm_20260727 - seed_plate-1.STL

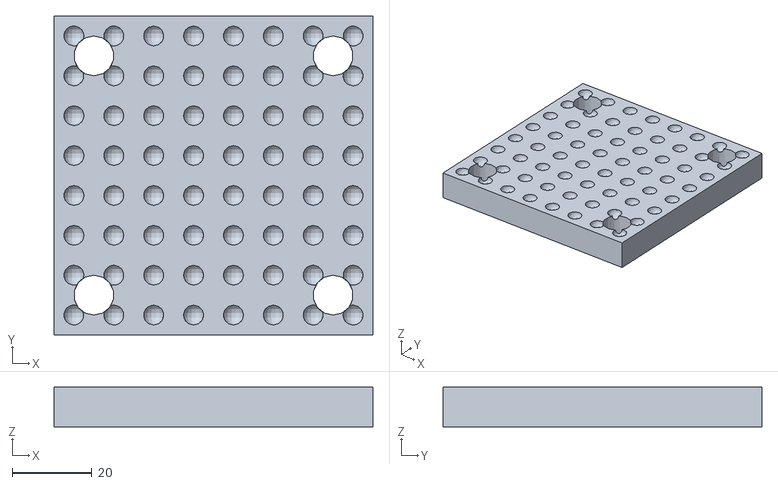
[picture p4: CAD file, 2026-08-05]
stl/Industry_gyu_arm_20260727 - seed_plate-1.STL
80.0 x 80.0 x 10.0
