Mlngyu-Park/2026ESWContest_free_A_IndustryGyuArm/urdf/sts3215/Industry_gyu_arm_20260809_base/meshes/l5.STL

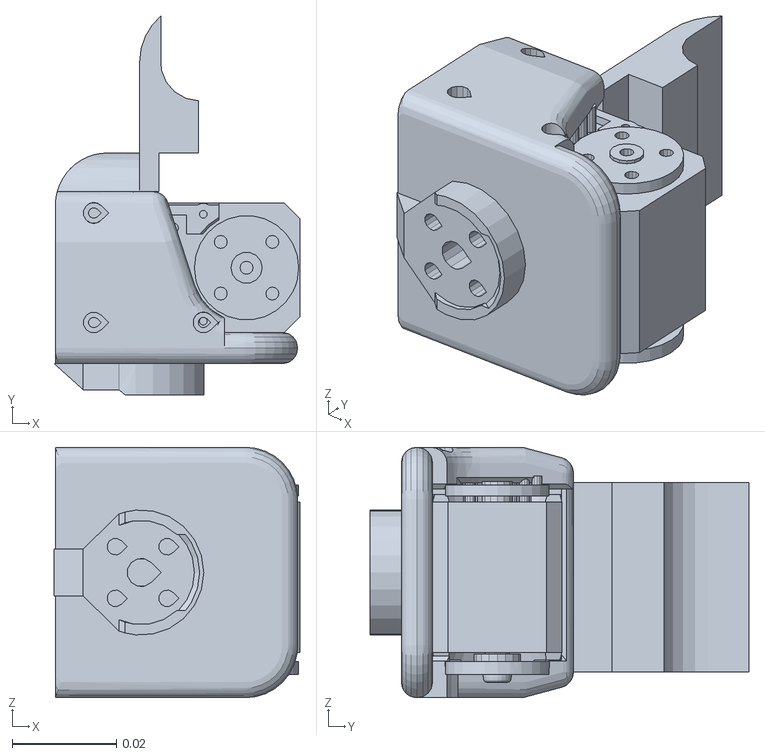
[picture p5: CAD file, 2026-08-09]
urdf/sts3215/Industry_gyu_arm_20260809_base/meshes/l5.STL
0.0471 x 0.0727 x 0.048
