Mlngyu-Park/2026ESWContest_free_A_IndustryGyuArm/stl/Industry_gyu_arm_20260727 - plate_bottom-7.STL

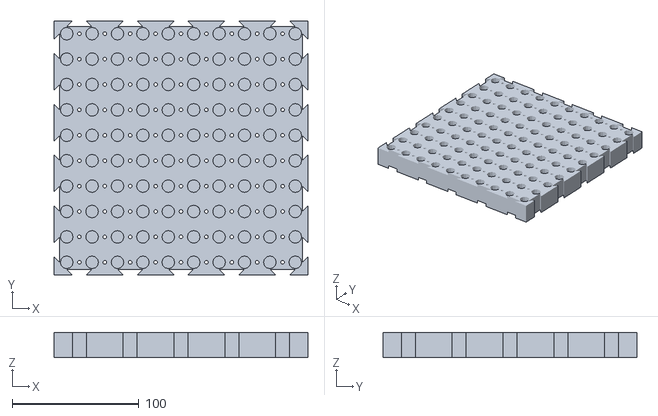
[picture p6: CAD file, 2026-08-05]
stl/Industry_gyu_arm_20260727 - plate_bottom-7.STL
200.0 x 200.0 x 20.0
