Mlngyu-Park/2026ESWContest_free_A_IndustryGyuArm/urdf/sts3215/Industry_gyu_arm_20260809_base/meshes/l7.STL

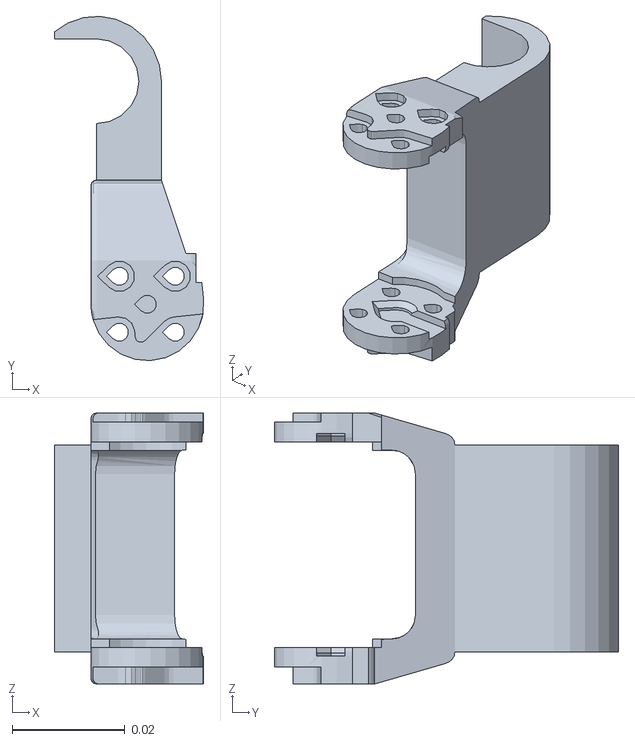
[picture p7: CAD file, 2026-08-09]
urdf/sts3215/Industry_gyu_arm_20260809_base/meshes/l7.STL
0.0264 x 0.061 x 0.048
