Mlngyu-Park/2026ESWContest_free_A_IndustryGyuArm/urdf/sts3215/Industry_gyu_arm_20260809_base/meshes/l3.STL

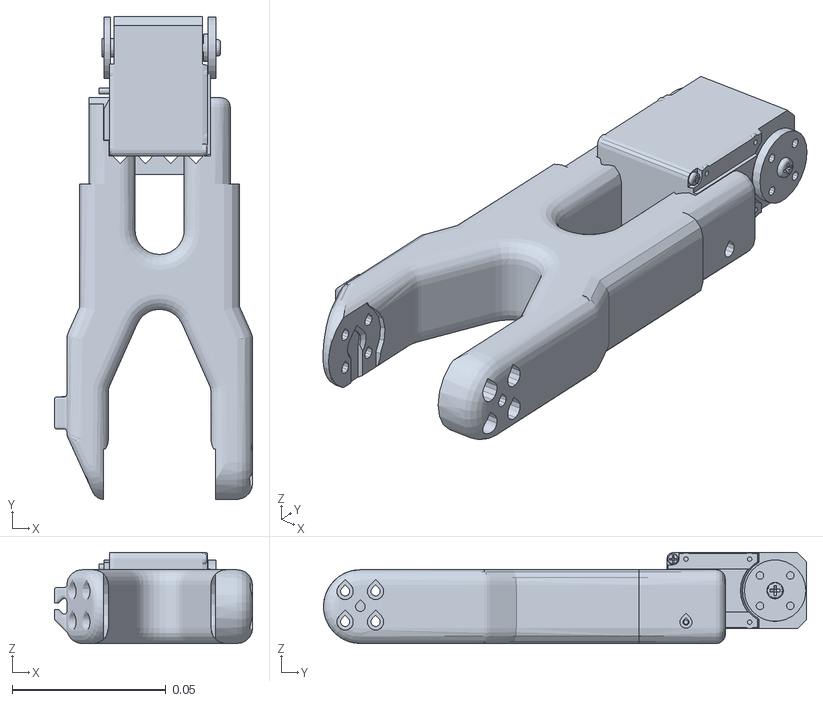
[picture p8: CAD file, 2026-08-09]
urdf/sts3215/Industry_gyu_arm_20260809_base/meshes/l3.STL
0.0644 x 0.157 x 0.0296
