Mlngyu-Park/2026ESWContest_free_A_IndustryGyuArm/urdf/sts3215/Industry_gyu_arm_20260809_base/meshes/l4.STL

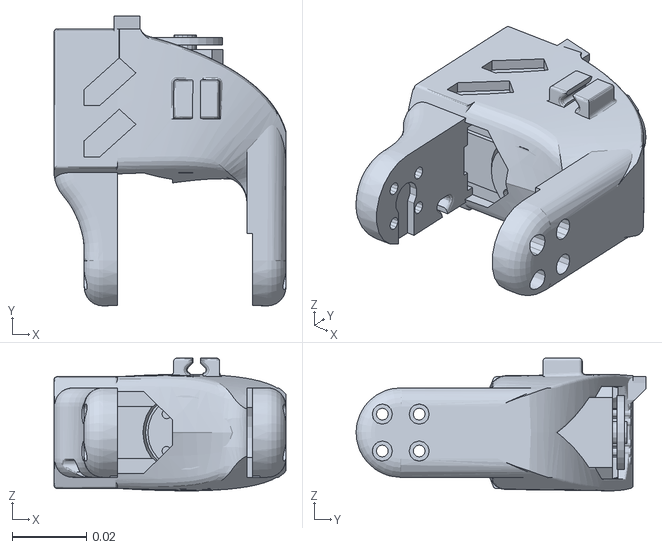
[picture p9: CAD file, 2026-08-09]
urdf/sts3215/Industry_gyu_arm_20260809_base/meshes/l4.STL
0.0623 x 0.0778 x 0.0357
