Mlngyu-Park/2026ESWContest_free_A_IndustryGyuArm/stl/Industry_gyu_arm_20260721 - docking_station-6.STL

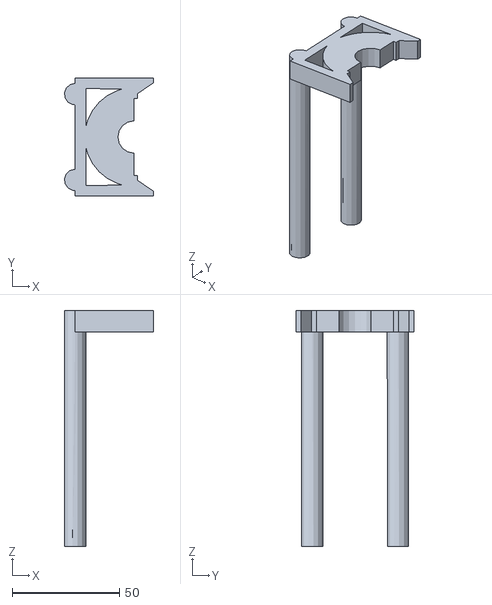
[picture p10: CAD file, 2026-08-05]
stl/Industry_gyu_arm_20260721 - docking_station-6.STL
41.5 x 55.0 x 110.0
