Mlngyu-Park/2026ESWContest_free_A_IndustryGyuArm/urdf/sts3215/Industry_gyu_arm_20260809_base/meshes/base_link.STL

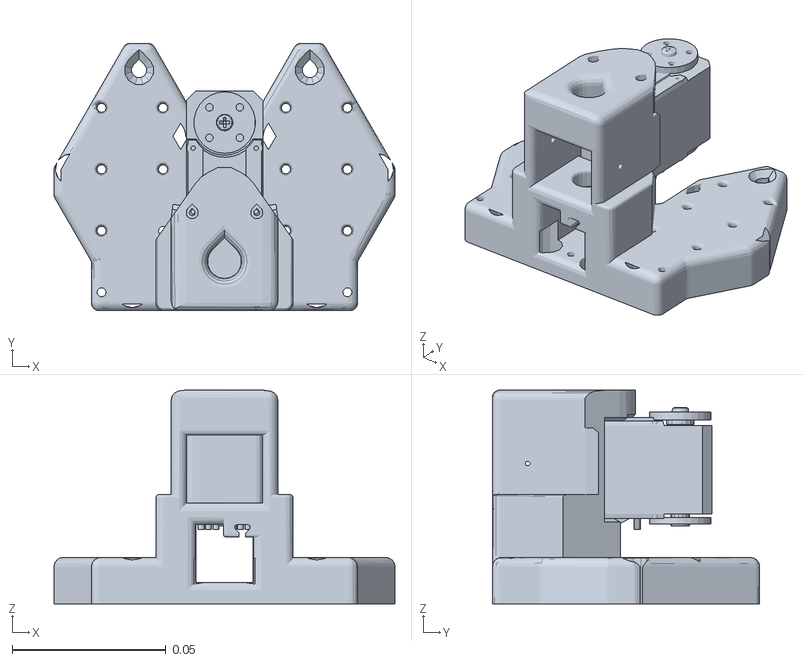
[picture p12: CAD file, 2026-08-05]
urdf/sts3215/Industry_gyu_arm_20260809_base/meshes/base_link.STL
0.111 x 0.087 x 0.0696
