Mlngyu-Park/2026ESWContest_free_A_IndustryGyuArm/urdf/dynamixel/Industry_gyu_arm_20260723_1st_position/meshes/l1.STL

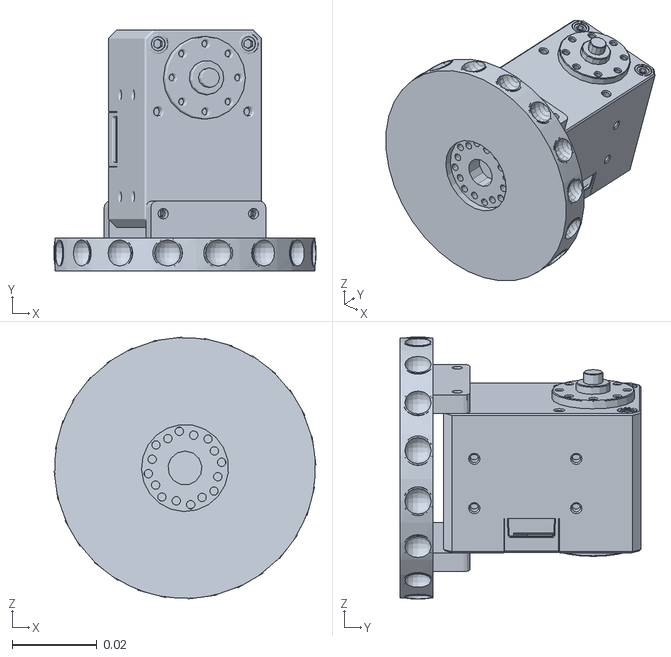
[picture p13: CAD file, 2026-08-07, an earlier design]
urdf/dynamixel/Industry_gyu_arm_20260723_1st_position/meshes/l1.STL
0.0617 x 0.0567 x 0.0617
