Mlngyu-Park/2026ESWContest_free_A_IndustryGyuArm/(list of files, cad)

Other CAD files:
stl/Industry_gyu_arm_20260727 - plate_bottom-8.STL
stl/Industry_gyu_arm_20260727 - plate_bottom-10.STL
stl/Industry_gyu_arm_20260727 - plate_bottom-9.STL
urdf/sts3215/Industry_gyu_arm_20260809_base/meshes/l6.STL
urdf/dynamixel/Industry_gyu_arm_20260723_1st_position/meshes/base_link.STL
urdf/dynamixel/Industry_gyu_arm_20260723_1st_position/meshes/l2.STL
urdf/dynamixel/Industry_gyu_arm_20260723_1st_position/meshes/l3.STL
urdf/dynamixel/Industry_gyu_arm_20260723_1st_position/meshes/l4.STL
urdf/dynamixel/Industry_gyu_arm_20260723_1st_position/meshes/l5.STL
urdf/dynamixel/Industry_gyu_arm_20260723_1st_position/meshes/l6.STL
urdf/dynamixel/Industry_gyu_arm_20260723_2nd_position/meshes/base_link.STL
urdf/dynamixel/Industry_gyu_arm_20260723_2nd_position/meshes/l1.STL
urdf/dynamixel/Industry_gyu_arm_20260723_2nd_position/meshes/l2.STL
urdf/dynamixel/Industry_gyu_arm_20260723_2nd_position/meshes/l3.STL
urdf/dynamixel/Industry_gyu_arm_20260723_2nd_position/meshes/l4.STL
urdf/dynamixel/Industry_gyu_arm_20260723_2nd_position/meshes/l5.STL
urdf/dynamixel/Industry_gyu_arm_20260723_2nd_position/meshes/l6.STL
urdf/dynamixel/Industry_gyu_arm_20260723_3rd_position/meshes/base_link.STL
urdf/dynamixel/Industry_gyu_arm_20260723_3rd_position/meshes/l1.STL
urdf/dynamixel/Industry_gyu_arm_20260723_3rd_position/meshes/l2.STL
urdf/dynamixel/Industry_gyu_arm_20260723_3rd_position/meshes/l3.STL
urdf/dynamixel/Industry_gyu_arm_20260723_3rd_position/meshes/l4.STL
urdf/dynamixel/Industry_gyu_arm_20260723_3rd_position/meshes/l5.STL
urdf/dynamixel/Industry_gyu_arm_20260723_3rd_position/meshes/l6.STL
urdf/dynamixel/Industry_gyu_arm_20260723_base_postion/meshes/base_link.STL
urdf/dynamixel/Industry_gyu_arm_20260723_base_postion/meshes/l1.STL
urdf/dynamixel/Industry_gyu_arm_20260723_base_postion/meshes/l2.STL
urdf/dynamixel/Industry_gyu_arm_20260723_base_postion/meshes/l3.STL
urdf/dynamixel/Industry_gyu_arm_20260723_base_postion/meshes/l4.STL
urdf/dynamixel/Industry_gyu_arm_20260723_base_postion/meshes/l5.STL
urdf/dynamixel/Industry_gyu_arm_20260723_base_postion/meshes/l6.STL
urdf/sts3215/Industry_gyu_arm_20260728_1st_position/meshes/l1.STL
urdf/sts3215/Industry_gyu_arm_20260728_1st_position/meshes/l2.STL
urdf/sts3215/Industry_gyu_arm_20260728_1st_position/meshes/l3.STL
urdf/sts3215/Industry_gyu_arm_20260728_1st_position/meshes/l4.STL
urdf/sts3215/Industry_gyu_arm_20260728_1st_position/meshes/l5.STL
urdf/sts3215/Industry_gyu_arm_20260728_1st_position/meshes/l6.STL
urdf/sts3215/Industry_gyu_arm_20260728_base/meshes/l1.STL
urdf/sts3215/Industry_gyu_arm_20260728_base/meshes/l2.STL
urdf/sts3215/Industry_gyu_arm_20260728_base/meshes/l3.STL
urdf/sts3215/Industry_gyu_arm_20260728_base/meshes/l4.STL
urdf/sts3215/Industry_gyu_arm_20260728_base/meshes/l5.STL
urdf/sts3215/Industry_gyu_arm_20260728_base/meshes/l6.STL
