Mlngyu-Park/2026ESWContest_free_A_IndustryGyuArm/Industry_gyu_arm/tpu_pe/WIRING.md

# PE 2개 배선표 — 핀 번호까지

**핀 배치 4개 전부 공식 데이터시트로 검증 완료 (2026-09-14).**

| 칩 | 출처 | 상태 |
|---|---|---|
| SST39SF010A | Microchip **DS20005022F** p.3 Figure 2-1 | ✓ |
| 74HC283 | Philips Rev.03 p.4 Fig 5 | ✓ |
| 74HC574 | Nexperia Rev.10 p.3 Table 2 | ✓ |
| 74HC74 | Nexperia Rev.9 p.3 | ✓ **오류 발견→수정** |

---

## 0. 칩 핀 배치

### 74HC574 (DIP-20) — 8비트 D 플립플롭 ✓확인됨

| 핀 | 신호 | 핀 | 신호 |
|---|---|---|---|
| 1 | /OE (출력 허용, LOW 활성) | 20 | VCC |
| 2 | D0 | 19 | Q0 |
| 3 | D1 | 18 | Q1 |
| 4 | D2 | 17 | Q2 |
| 5 | D3 | 16 | Q3 |
| 6 | D4 | 15 | Q4 |
| 7 | D5 | 14 | Q5 |
| 8 | D6 | 13 | Q6 |
| 9 | D7 | 12 | Q7 |
| 10 | GND | 11 | CP (클럭, 상승 엣지) |

**D0~D7 이 2~9번, Q0~Q7 이 19~12번(역순).** 헷갈리기 쉬우니 주의.

### 74HC283 (DIP-16) — 4비트 가산기 ✓확인됨

| 핀 | 신호 | 핀 | 신호 |
|---|---|---|---|
| 1 | S2 | 16 | VCC |
| 2 | B2 | 15 | B3 |
| 3 | A2 | 14 | A3 |
| 4 | S1 | 13 | S3 |
| 5 | A1 | 12 | A4 |
| 6 | B1 | 11 | B4 |
| 7 | CIN | 10 | S4 |
| 8 | GND | 9 | COUT |

**핀 순서가 뒤죽박죽이다.** A1=5, A2=3, A3=14, A4=12. 배선할 때 표를 보면서 할 것.

### SST39SF010A (DIP-32) — 128KB 플래시 ✓확인됨

Microchip DS20005022F 3쪽 Figure 2-1 "PIN ASSIGNMENT FOR 32-LEAD PDIP" 그대로:

| 핀 | 신호 | 핀 | 신호 |
|---|---|---|---|
| 1 | NC ※1 | 32 | VDD (5V) |
| 2 | **A16** | 31 | WE# |
| 3 | A15 | 30 | NC ※2 |
| 4 | A12 | 29 | A14 |
| 5 | A7 | 28 | A13 |
| 6 | A6 | 27 | A8 |
| 7 | A5 | 26 | A9 |
| 8 | A4 | 25 | A11 |
| 9 | A3 | 24 | OE# |
| 10 | A2 | 23 | A10 |
| 11 | A1 | 22 | CE# |
| 12 | A0 | 21 | DQ7 |
| 13 | DQ0 | 20 | DQ6 |
| 14 | DQ1 | 19 | DQ5 |
| 15 | DQ2 | 18 | DQ4 |
| 16 | VSS (GND) | 17 | DQ3 |

※1 핀1: SF010A/SF020A 는 NC, **SF040 은 A18**
※2 핀30: SF010A 는 NC, **SF020A/SF040 은 A17**
→ 나중에 SF040(512KB)으로 바꾸면 **핀 1·30 을 GND 로 내려야 한다.**
   띄워두면 주소가 떠서 엉뚱한 곳을 읽는다.

**주소선 17개(A0~A16)가 딱 필요한 만큼이다:**
- A0~A7 = x (활성값)
- A8~A15 = w (가중치)
- A16 = 곱의 상위/하위 바이트 선택

---

## 1. PE 하나의 배선

PE 하나에 칩 9개:
- U1 = SST39SF010 (곱셈 LUT)
- U2 = 74HC574 (w 래치)
- U3 = 74HC574 (x 래치)
- U4~U7 = 74HC283 ×4 (16비트 가산기)
- U8, U9 = 74HC574 ×2 (psum 래치 하위/상위)

### ① w 래치 (U2) → LUT 주소 상위

| U2 (74HC574) | → | U1 (SST39SF010) |
|---|---|---|
| 핀 19 (Q0) | → | 핀 27 (A8) |
| 핀 18 (Q1) | → | 핀 26 (A9) |
| 핀 17 (Q2) | → | 핀 23 (A10) |
| 핀 16 (Q3) | → | 핀 25 (A11) |
| 핀 15 (Q4) | → | 핀 4 (A12) |
| 핀 14 (Q5) | → | 핀 28 (A13) |
| 핀 13 (Q6) | → | 핀 29 (A14) |
| 핀 12 (Q7) | → | 핀 3 (A15) |

U2 의 D0~D7 (핀 2~9) 은 MEGA 의 w 데이터선에 연결.
U2 의 CP (핀 11) 는 MEGA 의 "w 세팅" 신호.
U2 의 /OE (핀 1) 는 GND (항상 출력).

### ② x 래치 (U3) → LUT 주소 하위 + 다음 PE

| U3 (74HC574) | → | U1 (SST39SF010) | → 다음 PE |
|---|---|---|---|
| 핀 19 (Q0) | → | 핀 12 (A0) | → PE1 U3 핀 2 |
| 핀 18 (Q1) | → | 핀 11 (A1) | → PE1 U3 핀 3 |
| 핀 17 (Q2) | → | 핀 10 (A2) | → PE1 U3 핀 4 |
| 핀 16 (Q3) | → | 핀 9 (A3) | → PE1 U3 핀 5 |
| 핀 15 (Q4) | → | 핀 8 (A4) | → PE1 U3 핀 6 |
| 핀 14 (Q5) | → | 핀 7 (A5) | → PE1 U3 핀 7 |
| 핀 13 (Q6) | → | 핀 6 (A6) | → PE1 U3 핀 8 |
| 핀 12 (Q7) | → | 핀 5 (A7) | → PE1 U3 핀 9 |

**★ 이 연결이 시스톨릭의 핵심이다.** x 가 클럭마다 오른쪽으로 흐른다.

U3 의 CP (핀 11) = 시스템 클럭.
U3 의 /OE (핀 1) = GND.

### ③ LUT 제어

| U1 핀 | 연결 |
|---|---|
| 핀 2 (A16) | 위상 신호 (74HC74 출력) — 0=하위, 1=상위 |
| 핀 22 (/CE) | GND (항상 선택) |
| 핀 24 (/OE) | GND (항상 읽기) |
| 핀 31 (/WE) | **VCC** (쓰기 금지 — 중요) |
| 핀 1, 30 | NC (미연결) |
| 핀 32 | VCC |
| 핀 16 | GND |

### ④ LUT 출력 → 가산기 A 입력

U1 의 DQ0~DQ7 (핀 13,14,15,17,18,19,20,21) 이 가산기로 간다.

**위상 0 (하위 바이트):** U4·U5 의 A 입력으로
**위상 1 (상위 바이트):** U6·U7 의 A 입력으로

| U1 (LUT) | → | 가산기 |
|---|---|---|
| 핀 13 (DQ0) | → | U4 핀 5 (A1) |
| 핀 14 (DQ1) | → | U4 핀 3 (A2) |
| 핀 15 (DQ2) | → | U4 핀 14 (A3) |
| 핀 17 (DQ3) | → | U4 핀 12 (A4) |
| 핀 18 (DQ4) | → | U5 핀 5 (A1) |
| 핀 19 (DQ5) | → | U5 핀 3 (A2) |
| 핀 20 (DQ6) | → | U5 핀 14 (A3) |
| 핀 21 (DQ7) | → | U5 핀 12 (A4) |

**주의: 74283 의 A1~A4 는 핀 5,3,14,12 다.** 순서가 아니다.

### ⑤ 가산기 캐리 체인

| 칩 | 담당 비트 | CIN (핀 7) | COUT (핀 9) |
|---|---|---|---|
| U4 | 0~3 | GND | → U5 핀 7 |
| U5 | 4~7 | U4 핀 9 | → U6 핀 7 |
| U6 | 8~11 | U5 핀 9 | → U7 핀 7 |
| U7 | 12~15 | U6 핀 9 | 미연결 |

**U4 의 CIN 을 GND 에 반드시 물릴 것.** 띄워두면 값이 튄다.

### ⑥ psum_in → 가산기 B 입력

앞 PE 의 psum_out (또는 첫 PE 면 0) 을 B 입력에 넣는다.

| 비트 | 가산기 핀 |
|---|---|
| 0 | U4 핀 6 (B1) |
| 1 | U4 핀 2 (B2) |
| 2 | U4 핀 15 (B3) |
| 3 | U4 핀 11 (B4) |
| 4 | U5 핀 6 (B1) |
| 5 | U5 핀 2 (B2) |
| 6 | U5 핀 15 (B3) |
| 7 | U5 핀 11 (B4) |
| 8~15 | U6, U7 도 같은 순서 |

**첫 PE 는 B 입력을 전부 GND 에.**

### ⑦ 가산기 출력 → psum 래치

| 가산기 | 핀 | → | psum 래치 |
|---|---|---|---|
| U4 S1 | 핀 4 | → | U8 핀 2 (D0) |
| U4 S2 | 핀 1 | → | U8 핀 3 (D1) |
| U4 S3 | 핀 13 | → | U8 핀 4 (D2) |
| U4 S4 | 핀 10 | → | U8 핀 5 (D3) |
| U5 S1 | 핀 4 | → | U8 핀 6 (D4) |
| U5 S2 | 핀 1 | → | U8 핀 7 (D5) |
| U5 S3 | 핀 13 | → | U8 핀 8 (D6) |
| U5 S4 | 핀 10 | → | U8 핀 9 (D7) |
| U6, U7 | 같은 방식 | → | U9 (상위 8비트) |

**74283 의 S1~S4 는 핀 4,1,13,10 이다.**

U8·U9 의 CP (핀 11) = 시스템 클럭.
U8·U9 의 /OE (핀 1) = GND.
U8·U9 의 Q 출력 (핀 19~12) = psum_out → 다음 PE 의 B 입력.

---

## 2. 공통 회로

### 클럭 분주 (74HC74, 서랍에 있음)

```
오실레이터 ──→ 74HC74 첫째 FF ──→ 위상 신호 (LUT A16)
                     │
                     └─→ 74HC74 둘째 FF ──→ PE 클럭 (574 CP)
```

**LUT 는 PE 클럭의 2배로 돈다.** 하위·상위를 2회 읽어야 하니까.

74HC74 (DIP-14) 핀 — ✓Nexperia 데이터시트 Rev.9 확인됨:

| 핀 | 신호 | 연결 |
|---|---|---|
| 1 | 1RD (리셋1, LOW활성) | **VCC** |
| 2 | 1D | ← 핀 6 (되먹임) |
| 3 | 1CP (클럭1) | ← 오실레이터 |
| 4 | 1SD (셋1, LOW활성) | **VCC** |
| 5 | 1Q | → 위상 신호 (LUT A16) |
| 6 | /1Q | → 핀 2, 그리고 → 핀 11 |
| 7 | GND | GND |
| 8 | /2Q | → 핀 12 (되먹임) |
| 9 | 2Q | → PE 클럭 (574 CP) |
| 10 | 2SD (셋2, LOW활성) | **VCC** |
| 11 | 2CP (클럭2) | ← 핀 6 |
| 12 | 2D | ← 핀 8 (되먹임) |
| 13 | 2RD (리셋2, LOW활성) | **VCC** |
| 14 | VCC | 5V |

**주의 — 흔한 착각:** 2번 FF 는 핀 번호가 1번 FF 와 거울처럼 뒤집혀 있다.
1번은 `D=2, CP=3` 인데 **2번은 `CP=11, D=12`** 로 순서가 반대다.

**2분주 배선 (/Q 를 자기 D 로 되먹임):**
```
핀 6 (/1Q) → 핀 2 (1D)     ← 1단 2분주
핀 6 (/1Q) → 핀 11 (2CP)   ← 1단 출력을 2단 클럭으로
핀 8 (/2Q) → 핀 12 (2D)    ← 2단 2분주
```

**RD·SD 4개(핀 1,4,10,13)를 전부 VCC 에 물릴 것.** 띄워두면 안 돈다.

### 클럭 버퍼 (74HC244)

오실레이터 출력 하나로 칩 18개를 못 몰 수 있다.
74HC244 로 나눠 뿌린다.

### 전원

- **모든 칩의 VCC 에 5V, GND 에 접지**
- **칩마다 0.1µF 를 VCC-GND 사이에, 칩 바로 옆에**
- 기판 전체에 10µF 전해 2~4개

---

## 3. MEGA 연결

| MEGA 핀 | 신호 | 방향 |
|---|---|---|
| 22~29 | w/x 데이터 8비트 | 출력 |
| 30 | w 래치 CP (PE0) | 출력 |
| 31 | w 래치 CP (PE1) | 출력 |
| 32 | x 래치 CP | 출력 |
| 33 | 시스템 클럭 (수동 스텝) | 출력 |
| 34 | 리셋 | 출력 |
| 42~49 | psum 읽기 8비트 | 입력 |
| 35 | psum 상위/하위 선택 | 출력 |

**수동 클럭이 핵심이다.** MEGA 가 한 클럭씩 주면 한 단계씩 멈춰가며 확인할 수 있다.

---

## 4. 배선 순서 — 이 순서로 할 것

```
1. 소켓을 기판에 배치하고 납땜
2. 전원선 (VCC·GND) 먼저 — 모든 칩에
3. 커패시터를 칩마다
4. 클럭 분주 회로 (74HC74) → 오실로스코프나 LED 로 확인
5. PE0 의 w 래치 → LUT 주소 상위
6. PE0 의 x 래치 → LUT 주소 하위
7. PE0 의 LUT → 가산기
8. PE0 의 가산기 캐리 체인
9. PE0 의 가산기 → psum 래치
10. 여기서 PE0 하나만 시험  ← 중요
11. PE1 을 같은 방식으로
12. PE0 x_out → PE1 x_in
13. PE0 psum_out → PE1 psum_in
```

**10번에서 반드시 멈추고 시험할 것.** PE0 가 안 되는데 PE1 을 만들면 원인이 두 배가 된다.

---

## 5. 만들기 전 확인할 것

- [x] ~~SST39SF010 데이터시트 대조~~ — **완료. DS20005022F 와 일치.**
- [ ] 74HC574 의 Q 출력이 핀 19→12 역순인 것 확인
- [ ] **74HC74 의 2번 FF 는 CP=11, D=12** (1번 FF 와 반대 순서)
- [ ] 74HC283 의 A/B/S 핀 순서가 뒤죽박죽인 것 확인
- [ ] 모든 칩의 /OE 를 GND, /WE 를 VCC 에
- [ ] U4 의 CIN 을 GND 에
- [ ] 첫 PE 의 B 입력을 전부 GND 에

---

## 6. VeroRoute 로 자동 배선하기

`pe2.net` 이 VeroRoute 용 넷리스트다. `layout.py` 가 만든다.

### 가져오는 법

```
1. VeroRoute 실행
2. File → Import Netlist
3. 형식을 "Protel1/Tango" 로 선택
4. pe2.net 열기
5. 부품이 화면에 뜨면 배치하고 Auto-route
```

**윈도우에서 파일 찾는 경로:**
```
\\wsl$\Ubuntu\home\drboom\2026_project\Industry_gyu_arm\tpu_pe\pe2.net
```

### 들어 있는 것

| 항목 | 개수 |
|---|---|
| 칩 | 20 |
| 0.1µF 커패시터 | 20 (칩마다 1개, 자동 추가됨) |
| 넷 | 108 |
| 연결 지점 | 343 |
| VCC 핀 | 46 |
| GND 핀 | 70 |

**검증 완료:** 핀 중복(쇼트) 없음, 잘못된 핀 참조 없음, 외톨이 넷 없음.

### 풋프린트

VeroRoute 가 아는 이름만 썼으므로 그대로 열린다:

| 칩 | 풋프린트 |
|---|---|
| SST39SF010A | DIP32 |
| 74HC574 / 74HC244 | DIP20 |
| 74HC283 | DIP16 |
| 74HC74 | DIP14 |
| 0.1µF | CAP_CERAMIC |

### 주의

- **VeroRoute 의 자동 배치는 참고만 하라.** `layout.svg` 의 배치는
  신호가 왼→오른쪽으로 흐르게 손으로 정한 것이다. 자동 배치는
  배선 길이만 보므로 흐름이 엉킬 수 있다.
- 커패시터는 **반드시 칩 바로 옆에** 둘 것. 자동 배치가 멀리 보내면 손으로 옮긴다.
