Mlngyu-Park/2026ESWContest_free_A_IndustryGyuArm/Industry_gyu_arm/TODO.md

# ARM STUDIO 할 일 (나중에)

2026-10-30 사용자가 정한 것. 지금 당장은 하지 않고 적어만 둔다.

## 버튼·LED (사용자가 직접 만들 예정)
- 버튼과 LED 를 놓고, 팔이 PPAP 펜으로 버튼을 **눌러서** 특정 LED 를 켠다.
- 펜에 버튼 등을 달아서, 누르면 모터를 켜는 식으로도 해 본다.
- → 블록 어휘에 '누르기' 같은 동작이 추가될 것 (AI 는 블록 나열 그대로, 어휘만 늘린다).

## 두 팔이 꼭 따로따로여야 하나
- 지금은 두 팔이 번갈아 펜을 옮긴다. 두 팔이 **동시에 한 공정**을 할 수도 있다.
- 펜이 아닌 다른 물건도 잡는다. 예: A팔은 작업할 판을 잡고, B팔은 드릴·풀을 잡고 바르거나 붙인다.
- 어려운 개념이라 지금은 하지 않는다.
