Mlngyu-Park/2026ESWContest_free_A_IndustryGyuArm/urdf/dynamixel/Industry_gyu_arm_20260723_1st_position/urdf/Industry_gyu_arm_20260723_1st_position.urdf

<?xml version="1.0" encoding="utf-8"?>
<!-- This URDF was automatically created by SolidWorks to URDF Exporter! Originally created by Stephen Brawner (brawner@gmail.com) 
     Commit Version: 1.6.0-4-g7f85cfe  Build Version: 1.6.7995.38578
     For more information, please see http://wiki.ros.org/sw_urdf_exporter -->
<robot name="Industry_gyu_arm_20260723_1st_position">
  <link name="base_link">
    <inertial>
      <origin xyz="-0.00257845457715766 0.0239066269220647 1.3532561186925E-11" rpy="0 0 0" />
      <mass value="0.204101816796774" />
      <inertia ixx="0.000132404157180028" ixy="-7.25933326524076E-06" ixz="-1.38380895469124E-14" iyy="0.000166652752484632" iyz="2.16319567157909E-14" izz="0.000120628429559104" />
    </inertial>
    <visual>
      <origin xyz="0 0 0" rpy="0 0 0" />
      <geometry>
        <mesh filename="package://Industry_gyu_arm_20260723_1st_position/meshes/base_link.STL" />
      </geometry>
      <material name="">
        <color rgba="0.894117647058823 0.894117647058823 0.894117647058823 1" />
      </material>
    </visual>
    <collision>
      <origin xyz="0 0 0" rpy="0 0 0" />
      <geometry>
        <mesh filename="package://Industry_gyu_arm_20260723_1st_position/meshes/base_link.STL" />
      </geometry>
    </collision>
  </link>
  <link name="l1">
    <inertial>
      <origin xyz="6.52737068602138E-05 0.0680540116378734 0.000246539280521249" rpy="0 0 0" />
      <mass value="0.0672202475276019" />
      <inertia ixx="3.11778642266558E-05" ixy="-4.71008469739694E-08" ixz="-5.58409131637354E-07" iyy="1.81526886683823E-05" iyz="-1.77895471336314E-07" izz="2.9216615757476E-05" />
    </inertial>
    <visual>
      <origin xyz="0 0 0" rpy="0 0 0" />
      <geometry>
        <mesh filename="package://Industry_gyu_arm_20260723_1st_position/meshes/l1.STL" />
      </geometry>
      <material name="">
        <color rgba="0.894117647058823 0.894117647058823 0.894117647058823 1" />
      </material>
    </visual>
    <collision>
      <origin xyz="0 0 0" rpy="0 0 0" />
      <geometry>
        <mesh filename="package://Industry_gyu_arm_20260723_1st_position/meshes/l1.STL" />
      </geometry>
    </collision>
  </link>
  <joint name="j1" type="revolute">
    <origin xyz="0 0 0" rpy="0 0 0" />
    <parent link="base_link" />
    <child link="l1" />
    <axis xyz="0 -1 0" />
    <limit lower="0" upper="0" effort="0" velocity="0" />
  </joint>
  <link name="l2">
    <inertial>
      <origin xyz="-0.0458648280926169 0.144981991750628 0.0119405170412918" rpy="0 0 0" />
      <mass value="0.0860000025306606" />
      <inertia ixx="0.000141943491845923" ixy="6.11804270607092E-05" ixz="9.32643606693647E-06" iyy="6.11049337548228E-05" iyz="-1.57385424892759E-05" izz="0.000175586533099835" />
    </inertial>
    <visual>
      <origin xyz="0 0 0" rpy="0 0 0" />
      <geometry>
        <mesh filename="package://Industry_gyu_arm_20260723_1st_position/meshes/l2.STL" />
      </geometry>
      <material name="">
        <color rgba="0.894117647058823 0.894117647058823 0.894117647058823 1" />
      </material>
    </visual>
    <collision>
      <origin xyz="0 0 0" rpy="0 0 0" />
      <geometry>
        <mesh filename="package://Industry_gyu_arm_20260723_1st_position/meshes/l2.STL" />
      </geometry>
    </collision>
  </link>
  <joint name="j2" type="revolute">
    <origin xyz="0 0.044 0" rpy="0 0 0" />
    <parent link="l1" />
    <child link="l2" />
    <axis xyz="0.255944013796552 0 0.966691606357328" />
    <limit lower="0" upper="0" effort="0" velocity="0" />
  </joint>
  <link name="l3">
    <inertial>
      <origin xyz="-0.124988276308447 0.0963763563891897 0.00889604447454663" rpy="0 0 0" />
      <mass value="0.065534727614018" />
      <inertia ixx="2.40051604176629E-05" ixy="-3.84120090822566E-06" ixz="3.27164167749413E-06" iyy="3.12730799339159E-05" iyz="1.03083333596245E-06" izz="3.54808385176213E-05" />
    </inertial>
    <visual>
      <origin xyz="0 0 0" rpy="0 0 0" />
      <geometry>
        <mesh filename="package://Industry_gyu_arm_20260723_1st_position/meshes/l3.STL" />
      </geometry>
      <material name="">
        <color rgba="0.894117647058823 0.894117647058823 0.894117647058823 1" />
      </material>
    </visual>
    <collision>
      <origin xyz="0 0 0" rpy="0 0 0" />
      <geometry>
        <mesh filename="package://Industry_gyu_arm_20260723_1st_position/meshes/l3.STL" />
      </geometry>
    </collision>
  </link>
  <joint name="j3" type="revolute">
    <origin xyz="0.00598908992290059 0.045499999999995 0.0226205835887677" rpy="0 0 0" />
    <parent link="l2" />
    <child link="l3" />
    <axis xyz="-0.255944013796549 0 -0.966691606357328" />
    <limit lower="0" upper="0" effort="0" velocity="0" />
  </joint>
  <link name="l4">
    <inertial>
      <origin xyz="-0.082538411011371 -0.0675594010430427 0.00256025619321328" rpy="0 0 0" />
      <mass value="0.0601054977034363" />
      <inertia ixx="1.75903622806119E-05" ixy="-1.07775878286353E-05" ixz="5.99068956081135E-06" iyy="3.70538416340631E-05" iyz="2.93866694738736E-06" izz="3.78470252425988E-05" />
    </inertial>
    <visual>
      <origin xyz="0 0 0" rpy="0 0 0" />
      <geometry>
        <mesh filename="package://Industry_gyu_arm_20260723_1st_position/meshes/l4.STL" />
      </geometry>
      <material name="">
        <color rgba="0.894117647058823 0.894117647058823 0.894117647058823 1" />
      </material>
    </visual>
    <collision>
      <origin xyz="0 0 0" rpy="0 0 0" />
      <geometry>
        <mesh filename="package://Industry_gyu_arm_20260723_1st_position/meshes/l4.STL" />
      </geometry>
    </collision>
  </link>
  <joint name="j4" type="revolute">
    <origin xyz="-0.0696034840895727 0.121980117911509 0.013876809319433" rpy="0 0 0" />
    <parent link="l3" />
    <child link="l4" />
    <axis xyz="0.770749429244632 0.603574737563661 -0.204065806773286" />
    <limit lower="0" upper="0" effort="0" velocity="0" />
  </joint>
  <link name="l5">
    <inertial>
      <origin xyz="-0.113624530198571 -0.0546374988983571 0.0283622287266056" rpy="0 0 0" />
      <mass value="0.0681179211718175" />
      <inertia ixx="1.73995480731145E-05" ixy="6.18206737197632E-07" ixz="3.69044915147957E-06" iyy="4.16685799325296E-05" iyz="-9.93593233012038E-08" izz="4.04977912200193E-05" />
    </inertial>
    <visual>
      <origin xyz="0 0 0" rpy="0 0 0" />
      <geometry>
        <mesh filename="package://Industry_gyu_arm_20260723_1st_position/meshes/l5.STL" />
      </geometry>
      <material name="">
        <color rgba="0.894117647058823 0.894117647058823 0.894117647058823 1" />
      </material>
    </visual>
    <collision>
      <origin xyz="0 0 0" rpy="0 0 0" />
      <geometry>
        <mesh filename="package://Industry_gyu_arm_20260723_1st_position/meshes/l5.STL" />
      </geometry>
    </collision>
  </link>
  <joint name="j5" type="revolute">
    <origin xyz="-0.0398863717556662 -0.0300341945215395 -0.00909423632032111" rpy="0 0 0" />
    <parent link="l4" />
    <child link="l5" />
    <axis xyz="0.255944013796551 0 0.966691606357328" />
    <limit lower="0" upper="0" effort="0" velocity="0" />
  </joint>
  <link name="l6">
    <inertial>
      <origin xyz="-0.0945293505025905 -0.00478665645917917 0.00478514338327841" rpy="0 0 0" />
      <mass value="0.00557932257181679" />
      <inertia ixx="1.64332134830444E-06" ixy="-3.60455462380797E-08" ixz="3.4527056379796E-07" iyy="1.36992685577365E-06" iyz="9.62499033301506E-09" izz="2.52043694413901E-06" />
    </inertial>
    <visual>
      <origin xyz="0 0 0" rpy="0 0 0" />
      <geometry>
        <mesh filename="package://Industry_gyu_arm_20260723_1st_position/meshes/l6.STL" />
      </geometry>
      <material name="">
        <color rgba="0.894117647058823 0.894117647058823 0.894117647058823 1" />
      </material>
    </visual>
    <collision>
      <origin xyz="0 0 0" rpy="0 0 0" />
      <geometry>
        <mesh filename="package://Industry_gyu_arm_20260723_1st_position/meshes/l6.STL" />
      </geometry>
    </collision>
  </link>
  <joint name="j6" type="revolute">
    <origin xyz="-0.0559029432089947 -0.0487747429416385 0.0390738452654663" rpy="0 0 0" />
    <parent link="l5" />
    <child link="l6" />
    <axis xyz="0 1 0" />
    <limit lower="0" upper="0" effort="0" velocity="0" />
  </joint>
</robot>
