Mlngyu-Park/2026ESWContest_free_A_IndustryGyuArm/urdf/dynamixel/Industry_gyu_arm_20260723_3rd_position/urdf/Industry_gyu_arm_20260723_3rd_position.urdf

<?xml version="1.0" encoding="utf-8"?>
<!-- This URDF was automatically created by SolidWorks to URDF Exporter! Originally created by Stephen Brawner (brawner@gmail.com) 
     Commit Version: 1.6.0-4-g7f85cfe  Build Version: 1.6.7995.38578
     For more information, please see http://wiki.ros.org/sw_urdf_exporter -->
<robot name="Industry_gyu_arm_20260723_3rd_position">
  <link name="base_link">
    <inertial>
      <origin xyz="-0.00257845457715766 0.0239066269220647 1.3532561262798E-11" rpy="0 0 0" />
      <mass value="0.204101816796774" />
      <inertia ixx="0.000132404157180028" ixy="-7.25933326524075E-06" ixz="-1.38380898968537E-14" iyy="0.000166652752484632" iyz="2.16319568216498E-14" izz="0.000120628429559104" />
    </inertial>
    <visual>
      <origin xyz="0 0 0" rpy="0 0 0" />
      <geometry>
        <mesh filename="package://Industry_gyu_arm_20260723_3rd_position/meshes/base_link.STL" />
      </geometry>
      <material name="">
        <color rgba="0.894117647058823 0.894117647058823 0.894117647058823 1" />
      </material>
    </visual>
    <collision>
      <origin xyz="0 0 0" rpy="0 0 0" />
      <geometry>
        <mesh filename="package://Industry_gyu_arm_20260723_3rd_position/meshes/base_link.STL" />
      </geometry>
    </collision>
  </link>
  <link name="l1">
    <inertial>
      <origin xyz="-6.60359345451278E-05 0.0680540116378744 0.000246336211269599" rpy="0 0 0" />
      <mass value="0.0672202475276212" />
      <inertia ixx="3.11743968040591E-05" ixy="4.7648484113007E-08" ixz="5.64454792294074E-07" iyy="1.81526886683869E-05" iyz="-1.7774957234565E-07" izz="2.92200831800777E-05" />
    </inertial>
    <visual>
      <origin xyz="0 0 0" rpy="0 0 0" />
      <geometry>
        <mesh filename="package://Industry_gyu_arm_20260723_3rd_position/meshes/l1.STL" />
      </geometry>
      <material name="">
        <color rgba="0.894117647058823 0.894117647058823 0.894117647058823 1" />
      </material>
    </visual>
    <collision>
      <origin xyz="0 0 0" rpy="0 0 0" />
      <geometry>
        <mesh filename="package://Industry_gyu_arm_20260723_3rd_position/meshes/l1.STL" />
      </geometry>
    </collision>
  </link>
  <joint name="j1" type="revolute">
    <origin xyz="0 0 0" rpy="0 0 0" />
    <parent link="base_link" />
    <child link="l1" />
    <axis xyz="0 -1 0" />
    <limit lower="0" upper="0" effort="0" velocity="0" />
  </joint>
  <link name="l2">
    <inertial>
      <origin xyz="-0.0457257532560488 0.144982224882411 -0.0124606249133573" rpy="0 0 0" />
      <mass value="0.0860000273183046" />
      <inertia ixx="0.000142221452869294" ixy="6.09010175775001E-05" ixz="-9.80991889197822E-06" iyy="6.11043198138851E-05" iyz="1.67858449722226E-05" izz="0.000175309195101507" />
    </inertial>
    <visual>
      <origin xyz="0 0 0" rpy="0 0 0" />
      <geometry>
        <mesh filename="package://Industry_gyu_arm_20260723_3rd_position/meshes/l2.STL" />
      </geometry>
      <material name="">
        <color rgba="0.894117647058823 0.894117647058823 0.894117647058823 1" />
      </material>
    </visual>
    <collision>
      <origin xyz="0 0 0" rpy="0 0 0" />
      <geometry>
        <mesh filename="package://Industry_gyu_arm_20260723_3rd_position/meshes/l2.STL" />
      </geometry>
    </collision>
  </link>
  <joint name="j2" type="revolute">
    <origin xyz="0 0.044 0" rpy="0 0 0" />
    <parent link="l1" />
    <child link="l2" />
    <axis xyz="-0.25893 0 0.9659" />
    <limit lower="0" upper="0" effort="0" velocity="0" />
  </joint>
  <link name="l3">
    <inertial>
      <origin xyz="-0.112846785956237 0.0963765233346295 -0.0544668891698307" rpy="0 0 0" />
      <mass value="0.0655347274640485" />
      <inertia ixx="2.40217867060235E-05" ixy="-3.84494894713705E-06" ixz="-3.3005787850252E-06" iyy="3.12730522578541E-05" iyz="-1.01687480433129E-06" izz="3.54642398322091E-05" />
    </inertial>
    <visual>
      <origin xyz="0 0 0" rpy="0 0 0" />
      <geometry>
        <mesh filename="package://Industry_gyu_arm_20260723_3rd_position/meshes/l3.STL" />
      </geometry>
      <material name="">
        <color rgba="0.894117647058823 0.894117647058823 0.894117647058823 1" />
      </material>
    </visual>
    <collision>
      <origin xyz="0 0 0" rpy="0 0 0" />
      <geometry>
        <mesh filename="package://Industry_gyu_arm_20260723_3rd_position/meshes/l3.STL" />
      </geometry>
    </collision>
  </link>
  <joint name="j3" type="revolute">
    <origin xyz="-0.0060589 0.0455 0.022602" rpy="0 0 0" />
    <parent link="l2" />
    <child link="l3" />
    <axis xyz="0.25893 0 -0.9659" />
    <limit lower="0" upper="0" effort="0" velocity="0" />
  </joint>
  <link name="l4">
    <inertial>
      <origin xyz="-0.0728717735006678 -0.0675596813111309 -0.0388434190458101" rpy="0 0 0" />
      <mass value="0.0601054954113976" />
      <inertia ixx="1.74336031933473E-05" ixy="-1.08111675573001E-05" ixz="-5.7172257999783E-06" iyy="3.70537633025027E-05" iyz="-2.81290816075198E-06" izz="3.80038604097142E-05" />
    </inertial>
    <visual>
      <origin xyz="0 0 0" rpy="0 0 0" />
      <geometry>
        <mesh filename="package://Industry_gyu_arm_20260723_3rd_position/meshes/l4.STL" />
      </geometry>
      <material name="">
        <color rgba="0.894117647058823 0.894117647058823 0.894117647058823 1" />
      </material>
    </visual>
    <collision>
      <origin xyz="0 0 0" rpy="0 0 0" />
      <geometry>
        <mesh filename="package://Industry_gyu_arm_20260723_3rd_position/meshes/l4.STL" />
      </geometry>
    </collision>
  </link>
  <joint name="j4" type="revolute">
    <origin xyz="-0.067281 0.12198 -0.022591" rpy="0 0 0" />
    <parent link="l3" />
    <child link="l4" />
    <axis xyz="0.77011 0.60358 0.20644" />
    <limit lower="0" upper="0" effort="0" velocity="0" />
  </joint>
  <link name="l5">
    <inertial>
      <origin xyz="-0.112674552325727 -0.0546377218502914 -0.0319273443277" rpy="0 0 0" />
      <mass value="0.068117923249218" />
      <inertia ixx="1.99315252772566E-05" ixy="5.85699185833627E-07" ixz="-8.10510412725415E-06" iyy="4.16685804118928E-05" iyz="2.21378193499852E-07" izz="3.79658150758429E-05" />
    </inertial>
    <visual>
      <origin xyz="0 0 0" rpy="0 0 0" />
      <geometry>
        <mesh filename="package://Industry_gyu_arm_20260723_3rd_position/meshes/l5.STL" />
      </geometry>
      <material name="">
        <color rgba="0.894117647058823 0.894117647058823 0.894117647058823 1" />
      </material>
    </visual>
    <collision>
      <origin xyz="0 0 0" rpy="0 0 0" />
      <geometry>
        <mesh filename="package://Industry_gyu_arm_20260723_3rd_position/meshes/l5.STL" />
      </geometry>
    </collision>
  </link>
  <joint name="j5" type="revolute">
    <origin xyz="-0.030075 -0.030034 -0.027733" rpy="0 0 0" />
    <parent link="l4" />
    <child link="l5" />
    <axis xyz="-0.25893 0 0.9659" />
    <limit lower="0" upper="0" effort="0" velocity="0" />
  </joint>
  <link name="l6">
    <inertial>
      <origin xyz="-0.084371 -0.0047867 -0.042975" rpy="0 0 0" />
      <mass value="0.0055793" />
      <inertia ixx="1.5641E-06" ixy="-3.6017E-08" ixz="-2.0846E-07" iyy="1.3699E-06" iyz="-9.7322E-09" izz="2.5997E-06" />
    </inertial>
    <visual>
      <origin xyz="0 0 0" rpy="0 0 0" />
      <geometry>
        <mesh filename="package://Industry_gyu_arm_20260723_3rd_position/meshes/l6.STL" />
      </geometry>
      <material name="">
        <color rgba="0.89412 0.89412 0.89412 1" />
      </material>
    </visual>
    <collision>
      <origin xyz="0 0 0" rpy="0 0 0" />
      <geometry>
        <mesh filename="package://Industry_gyu_arm_20260723_3rd_position/meshes/l6.STL" />
      </geometry>
    </collision>
  </link>
  <joint name="j6" type="revolute">
    <origin xyz="-0.067933 -0.048775 0.006082" rpy="0 0 0" />
    <parent link="l5" />
    <child link="l6" />
    <axis xyz="0 1 0" />
    <limit lower="0" upper="0" effort="0" velocity="0" />
  </joint>
</robot>
