Mlngyu-Park/2026ESWContest_free_A_IndustryGyuArm/urdf/dynamixel/Industry_gyu_arm_20260723_base_postion/urdf/Industry_gyu_arm_20260723_base_postion.urdf

<?xml version="1.0" encoding="utf-8"?>
<!-- This URDF was automatically created by SolidWorks to URDF Exporter! Originally created by Stephen Brawner (brawner@gmail.com) 
     Commit Version: 1.6.0-4-g7f85cfe  Build Version: 1.6.7995.38578
     For more information, please see http://wiki.ros.org/sw_urdf_exporter -->
<robot name="Industry_gyu_arm_20260723_base_postion">
  <link name="base_link">
    <inertial>
      <origin xyz="-0.00257845457715766 0.0239066269220647 1.35325613076854E-11" rpy="0 0 0" />
      <mass value="0.204101816796774" />
      <inertia ixx="0.000132404157180028" ixy="-7.25933326524075E-06" ixz="-1.3838088962995E-14" iyy="0.000166652752484632" iyz="2.16319567946184E-14" izz="0.000120628429559104" />
    </inertial>
    <visual>
      <origin xyz="0 0 0" rpy="0 0 0" />
      <geometry>
        <mesh filename="package://Industry_gyu_arm_20260723_base_postion/meshes/base_link.STL" />
      </geometry>
      <material name="">
        <color rgba="0.894117647058823 0.894117647058823 0.894117647058823 1" />
      </material>
    </visual>
    <collision>
      <origin xyz="0 0 0" rpy="0 0 0" />
      <geometry>
        <mesh filename="package://Industry_gyu_arm_20260723_base_postion/meshes/base_link.STL" />
      </geometry>
    </collision>
  </link>
  <link name="l1">
    <inertial>
      <origin xyz="-7.08471559196511E-10 0.0680540116378729 0.00025503386763696" rpy="0 0 0" />
      <mass value="0.0672202475275897" />
      <inertia ixx="3.1325710039411E-05" ixy="-7.12452393511177E-13" ixz="6.57426773003697E-13" iyy="1.81526886683795E-05" iyz="-1.84025238777981E-07" izz="2.90687699447175E-05" />
    </inertial>
    <visual>
      <origin xyz="0 0 0" rpy="0 0 0" />
      <geometry>
        <mesh filename="package://Industry_gyu_arm_20260723_base_postion/meshes/l1.STL" />
      </geometry>
      <material name="">
        <color rgba="0.894117647058823 0.894117647058823 0.894117647058823 1" />
      </material>
    </visual>
    <collision>
      <origin xyz="0 0 0" rpy="0 0 0" />
      <geometry>
        <mesh filename="package://Industry_gyu_arm_20260723_base_postion/meshes/l1.STL" />
      </geometry>
    </collision>
  </link>
  <joint name="j1" type="revolute">
    <origin xyz="0 0 0" rpy="0 0 0" />
    <parent link="base_link" />
    <child link="l1" />
    <axis xyz="0 -1 0" />
    <limit lower="0" upper="0" effort="0" velocity="0" />
  </joint>
  <link name="l2">
    <inertial>
      <origin xyz="-0.00984274521455464 0.155253858492686 -0.000196030310980163" rpy="0 0 0" />
      <mass value="0.0860000082105804" />
      <inertia ixx="0.00017124023140987" ixy="2.23243381222888E-05" ixz="-5.11508079398268E-08" iyy="2.93969255240336E-05" iyz="4.92997437971865E-07" izz="0.00017799768658316" />
    </inertial>
    <visual>
      <origin xyz="0 0 0" rpy="0 0 0" />
      <geometry>
        <mesh filename="package://Industry_gyu_arm_20260723_base_postion/meshes/l2.STL" />
      </geometry>
      <material name="">
        <color rgba="0.894117647058823 0.894117647058823 0.894117647058823 1" />
      </material>
    </visual>
    <collision>
      <origin xyz="0 0 0" rpy="0 0 0" />
      <geometry>
        <mesh filename="package://Industry_gyu_arm_20260723_base_postion/meshes/l2.STL" />
      </geometry>
    </collision>
  </link>
  <joint name="j2" type="revolute">
    <origin xyz="0 0.044 0" rpy="0 0 0" />
    <parent link="l1" />
    <child link="l2" />
    <axis xyz="0 0 1" />
    <limit lower="0" upper="0" effort="0" velocity="0" />
  </joint>
  <link name="l3">
    <inertial>
      <origin xyz="-0.0811251758353718 0.150131921262749 -0.0233902703656249" rpy="0 0 0" />
      <mass value="0.0655347287185628" />
      <inertia ixx="2.22737871282598E-05" ixy="2.83552823105406E-06" ixz="1.10247158424731E-08" iyy="3.21372659170591E-05" iyz="8.41801997388108E-09" izz="3.63480317661754E-05" />
    </inertial>
    <visual>
      <origin xyz="0 0 0" rpy="0 0 0" />
      <geometry>
        <mesh filename="package://Industry_gyu_arm_20260723_base_postion/meshes/l3.STL" />
      </geometry>
      <material name="">
        <color rgba="0.894117647058823 0.894117647058823 0.894117647058823 1" />
      </material>
    </visual>
    <collision>
      <origin xyz="0 0 0" rpy="0 0 0" />
      <geometry>
        <mesh filename="package://Industry_gyu_arm_20260723_base_postion/meshes/l3.STL" />
      </geometry>
    </collision>
  </link>
  <joint name="j3" type="revolute">
    <origin xyz="0 0.0455 0.0234" rpy="0 0 0" />
    <parent link="l2" />
    <child link="l3" />
    <axis xyz="0 0 -1" />
    <limit lower="0" upper="0" effort="0" velocity="0" />
  </joint>
  <link name="l4">
    <inertial>
      <origin xyz="-0.104916044847408 -0.00531129219832457 -0.0186502340530001" rpy="0 0 0" />
      <mass value="0.0601054888257063" />
      <inertia ixx="1.2888547357013E-05" ixy="7.12280507123098E-06" ixz="2.0431910875617E-07" iyy="4.01181902161691E-05" iyz="-5.1417523460469E-08" izz="3.94844806419353E-05" />
    </inertial>
    <visual>
      <origin xyz="0 0 0" rpy="0 0 0" />
      <geometry>
        <mesh filename="package://Industry_gyu_arm_20260723_base_postion/meshes/l4.STL" />
      </geometry>
      <material name="">
        <color rgba="0.894117647058823 0.894117647058823 0.894117647058823 1" />
      </material>
    </visual>
    <collision>
      <origin xyz="0 0 0" rpy="0 0 0" />
      <geometry>
        <mesh filename="package://Industry_gyu_arm_20260723_base_postion/meshes/l4.STL" />
      </geometry>
    </collision>
  </link>
  <joint name="j4" type="revolute">
    <origin xyz="-0.024 0.139 -0.0044" rpy="0 0 0" />
    <parent link="l3" />
    <child link="l4" />
    <axis xyz="1 0 0" />
    <limit lower="0" upper="0" effort="0" velocity="0" />
  </joint>
  <link name="l5">
    <inertial>
      <origin xyz="-0.133557401276777 -0.00609726574660532 -0.00166399231713907" rpy="0 0 0" />
      <mass value="0.0681179149197741" />
      <inertia ixx="1.70864761549069E-05" ixy="6.23044863899625E-07" ixz="-2.50799391165308E-06" iyy="4.16685766308503E-05" iyz="6.21753690049052E-08" izz="4.08108580818552E-05" />
    </inertial>
    <visual>
      <origin xyz="0 0 0" rpy="0 0 0" />
      <geometry>
        <mesh filename="package://Industry_gyu_arm_20260723_base_postion/meshes/l5.STL" />
      </geometry>
      <material name="">
        <color rgba="0.894117647058823 0.894117647058823 0.894117647058823 1" />
      </material>
    </visual>
    <collision>
      <origin xyz="0 0 0" rpy="0 0 0" />
      <geometry>
        <mesh filename="package://Industry_gyu_arm_20260723_base_postion/meshes/l5.STL" />
      </geometry>
    </collision>
  </link>
  <joint name="j5" type="revolute">
    <origin xyz="-0.047014 -0.0020788 -0.019" rpy="0 0 0" />
    <parent link="l4" />
    <child link="l5" />
    <axis xyz="0 0 1" />
    <limit lower="0" upper="0" effort="0" velocity="0" />
  </joint>
  <link name="l6">
    <inertial>
      <origin xyz="-0.0925881691336365 -0.00478665645927764 -0.0194633832095234" rpy="0 0 0" />
      <mass value="0.00557932257181678" />
      <inertia ixx="1.53070639732738E-06" ixy="-3.73076380747585E-08" ixz="8.805285467105E-08" iyy="1.3699268557737E-06" iyz="2.48965459899828E-10" izz="2.63305189511604E-06" />
    </inertial>
    <visual>
      <origin xyz="0 0 0" rpy="0 0 0" />
      <geometry>
        <mesh filename="package://Industry_gyu_arm_20260723_base_postion/meshes/l6.STL" />
      </geometry>
      <material name="">
        <color rgba="0.894117647058823 0.894117647058823 0.894117647058823 1" />
      </material>
    </visual>
    <collision>
      <origin xyz="0 0 0" rpy="0 0 0" />
      <geometry>
        <mesh filename="package://Industry_gyu_arm_20260723_base_postion/meshes/l6.STL" />
      </geometry>
    </collision>
  </link>
  <joint name="j6" type="revolute">
    <origin xyz="-0.0805 -0.00023451 0.023464" rpy="0 0 0" />
    <parent link="l5" />
    <child link="l6" />
    <axis xyz="0 1 0" />
    <limit lower="0" upper="0" effort="0" velocity="0" />
  </joint>
</robot>
