Mlngyu-Park/2026ESWContest_free_A_IndustryGyuArm/dusk_boom_fpga_v35/constraints/dusk_boom_v35_pins.xdc

# dusk_boom_robot_v35.xdc — make_boom_robot_v35.py 가 만듦 · X_<볼> = 앞면 헤더 JX1/JX2 핀 (카메라 핀 16개 뺌 · 전지 없음) (ALINX AC7010C · 은행 34·35 = 3.3V)
# F_* = ESP32-S3 SPI (ESP 주인) · R_* = RP2040 SPI (RP2040 주인, R_SCK = U14 SRCC) · FE_IO0~7 = ESP_IO (470Ω 건너편)
# ESP_EN_F · ESP_BOOT_F = 2N7002 게이트 (HIGH = ESP 리셋 / IO0 내림) · EPD_* = e-ink (J13 앞면) · STAT_LED_F = WS2812 · BTN/FLED = 앞판

set_property -dict {PACKAGE_PIN N18 IOSTANDARD LVCMOS33} [get_ports f_sck]   ;# J10-7 B34_L13P_N18
set_property -dict {PACKAGE_PIN W20 IOSTANDARD LVCMOS33} [get_ports f_mosi]   ;# J11-21 B34_L16N_W20
set_property -dict {PACKAGE_PIN V20 IOSTANDARD LVCMOS33} [get_ports f_miso]   ;# J11-22 B34_L16P_V20
set_property -dict {PACKAGE_PIN W19 IOSTANDARD LVCMOS33} [get_ports f_cs]   ;# J11-23 B34_L22N_W19
set_property -dict {PACKAGE_PIN W18 IOSTANDARD LVCMOS33} [get_ports f_irq]   ;# J11-24 B34_L22P_W18
set_property -dict {PACKAGE_PIN Y18 IOSTANDARD LVCMOS33} [get_ports f_aux]   ;# J11-25 B34_L17P_Y18
set_property -dict {PACKAGE_PIN P20 IOSTANDARD LVCMOS33} [get_ports fe_io0]   ;# J10-3 B34_L14N_P20
set_property -dict {PACKAGE_PIN N20 IOSTANDARD LVCMOS33} [get_ports fe_io1]   ;# J10-4 B34_L14P_N20
set_property -dict {PACKAGE_PIN U17 IOSTANDARD LVCMOS33} [get_ports fe_io2]   ;# J10-5 B34_L9N_U17
set_property -dict {PACKAGE_PIN T16 IOSTANDARD LVCMOS33} [get_ports fe_io3]   ;# J10-6 B34_L9P_T16
set_property -dict {PACKAGE_PIN P19 IOSTANDARD LVCMOS33} [get_ports fe_io4]   ;# J10-8 B34_L13N_P19
set_property -dict {PACKAGE_PIN Y16 IOSTANDARD LVCMOS33} [get_ports fe_io5]   ;# J10-9 B34_L7P_Y16
set_property -dict {PACKAGE_PIN Y17 IOSTANDARD LVCMOS33} [get_ports fe_io6]   ;# J10-10 B34_L7N_Y17
set_property -dict {PACKAGE_PIN W15 IOSTANDARD LVCMOS33} [get_ports fe_io7]   ;# J10-11 B34_L10N_W15
set_property -dict {PACKAGE_PIN H16 IOSTANDARD TMDS_33} [get_ports hdmi_d2_p]   ;# J12-17 B35_L13P_H16
set_property -dict {PACKAGE_PIN H17 IOSTANDARD TMDS_33} [get_ports hdmi_d2_n]   ;# J12-18 B35_L13N_H17
set_property -dict {PACKAGE_PIN K19 IOSTANDARD TMDS_33} [get_ports hdmi_d1_p]   ;# J12-20 B35_L10P_K19
set_property -dict {PACKAGE_PIN J19 IOSTANDARD TMDS_33} [get_ports hdmi_d1_n]   ;# J12-19 B35_L10N_J19
set_property -dict {PACKAGE_PIN H15 IOSTANDARD TMDS_33} [get_ports hdmi_d0_p]   ;# J12-21 B35_L19P_H15
set_property -dict {PACKAGE_PIN G15 IOSTANDARD TMDS_33} [get_ports hdmi_d0_n]   ;# J12-22 B35_L19N_G15
set_property -dict {PACKAGE_PIN K14 IOSTANDARD TMDS_33} [get_ports hdmi_ck_p]   ;# J12-23 B35_L20P_K14
set_property -dict {PACKAGE_PIN J14 IOSTANDARD TMDS_33} [get_ports hdmi_ck_n]   ;# J12-24 B35_L20N_J14
set_property -dict {PACKAGE_PIN M17 IOSTANDARD LVCMOS33} [get_ports hdmi_scl_f]   ;# J12-25 B35_L8P_M17
set_property -dict {PACKAGE_PIN M18 IOSTANDARD LVCMOS33} [get_ports hdmi_sda_f]   ;# J12-26 B35_L8N_M18
set_property -dict {PACKAGE_PIN G17 IOSTANDARD LVCMOS33} [get_ports hdmi_hpd_f]   ;# J12-15 B35_L16P_G17
set_property -dict {PACKAGE_PIN B19 IOSTANDARD LVCMOS33} [get_ports exp0]   ;# J12-27 B35_L2P_B19
set_property -dict {PACKAGE_PIN A20 IOSTANDARD LVCMOS33} [get_ports exp1]   ;# J12-28 B35_L2N_A20
set_property -dict {PACKAGE_PIN C20 IOSTANDARD LVCMOS33} [get_ports exp2]   ;# J12-29 B35_L1P_C20
set_property -dict {PACKAGE_PIN B20 IOSTANDARD LVCMOS33} [get_ports exp3]   ;# J12-30 B35_L1N_B20
set_property -dict {PACKAGE_PIN D19 IOSTANDARD LVCMOS33} [get_ports exp4]   ;# J12-31 B35_L4P_D19
set_property -dict {PACKAGE_PIN D20 IOSTANDARD LVCMOS33} [get_ports exp5]   ;# J12-32 B35_L4N_D20
set_property -dict {PACKAGE_PIN E18 IOSTANDARD LVCMOS33} [get_ports exp6]   ;# J12-33 B35_L5P_E18
set_property -dict {PACKAGE_PIN E19 IOSTANDARD LVCMOS33} [get_ports exp7]   ;# J12-34 B35_L5N_E19
set_property -dict {PACKAGE_PIN F19 IOSTANDARD LVCMOS33} [get_ports exp8]   ;# J12-35 B35_L15P_F19
set_property -dict {PACKAGE_PIN F20 IOSTANDARD LVCMOS33} [get_ports exp9]   ;# J12-36 B35_L15N_F20
set_property -dict {PACKAGE_PIN U14 IOSTANDARD LVCMOS33} [get_ports r_sck]   ;# J10-15 B34_L11P_U14
set_property -dict {PACKAGE_PIN U15 IOSTANDARD LVCMOS33} [get_ports r_mosi]   ;# J10-16 B34_L11N_U15
set_property -dict {PACKAGE_PIN P14 IOSTANDARD LVCMOS33} [get_ports r_miso]   ;# J10-17 B34_L6P_P14
set_property -dict {PACKAGE_PIN R14 IOSTANDARD LVCMOS33} [get_ports r_cs]   ;# J10-18 B34_L6N_R14
set_property -dict {PACKAGE_PIN T15 IOSTANDARD LVCMOS33} [get_ports r_irq]   ;# J10-19 B34_L5N_T15
set_property -dict {PACKAGE_PIN T14 IOSTANDARD LVCMOS33} [get_ports esp_en_f]   ;# J10-20 B34_L5P_T14
set_property -dict {PACKAGE_PIN V13 IOSTANDARD LVCMOS33} [get_ports esp_boot_f]   ;# J10-21 B34_L3N_V13
set_property -dict {PACKAGE_PIN D18 IOSTANDARD LVCMOS33} [get_ports epd_din]   ;# J12-3 B35_L3N_D18
set_property -dict {PACKAGE_PIN E17 IOSTANDARD LVCMOS33} [get_ports epd_clk]   ;# J12-4 B35_L3P_E17
set_property -dict {PACKAGE_PIN F16 IOSTANDARD LVCMOS33} [get_ports epd_cs]   ;# J12-5 B35_L6P_F16
set_property -dict {PACKAGE_PIN F17 IOSTANDARD LVCMOS33} [get_ports epd_dc]   ;# J12-6 B35_L6N_F17
set_property -dict {PACKAGE_PIN G19 IOSTANDARD LVCMOS33} [get_ports epd_rst]   ;# J12-7 B35_L18P_G19
set_property -dict {PACKAGE_PIN G20 IOSTANDARD LVCMOS33} [get_ports epd_busy]   ;# J12-8 B35_L18N_G20
set_property -dict {PACKAGE_PIN J18 IOSTANDARD LVCMOS33} [get_ports stat_led_f]   ;# J12-9 B35_L14P_J18
set_property -dict {PACKAGE_PIN H18 IOSTANDARD LVCMOS33} [get_ports btn1_f]   ;# J12-10 B35_L14N_H18
set_property -dict {PACKAGE_PIN H20 IOSTANDARD LVCMOS33} [get_ports btn2_f]   ;# J12-11 B35_L17N_H20
set_property -dict {PACKAGE_PIN J20 IOSTANDARD LVCMOS33} [get_ports fled1_f]   ;# J12-12 B35_L17P_J20
set_property -dict {PACKAGE_PIN K18 IOSTANDARD LVCMOS33} [get_ports fled2_f]   ;# J12-13 B35_L12N_K18
set_property -dict {PACKAGE_PIN W14 IOSTANDARD LVCMOS33} [get_ports x_w14]   ;# J10-13 B34_L8P_W14
set_property -dict {PACKAGE_PIN V15 IOSTANDARD LVCMOS33} [get_ports x_v15]   ;# J10-12 B34_L10P_V15
set_property -dict {PACKAGE_PIN V12 IOSTANDARD LVCMOS33} [get_ports x_v12]   ;# J10-23 B34_L4P_V12
set_property -dict {PACKAGE_PIN Y14 IOSTANDARD LVCMOS33} [get_ports x_y14]   ;# J10-14 B34_L8N_Y14
set_property -dict {PACKAGE_PIN U12 IOSTANDARD LVCMOS33} [get_ports x_u12]   ;# J10-25 B34_L2N_U12
set_property -dict {PACKAGE_PIN U13 IOSTANDARD LVCMOS33} [get_ports x_u13]   ;# J10-22 B34_L3P_U13
set_property -dict {PACKAGE_PIN T10 IOSTANDARD LVCMOS33} [get_ports x_t10]   ;# J10-27 B34_L1N_T10
set_property -dict {PACKAGE_PIN W13 IOSTANDARD LVCMOS33} [get_ports x_w13]   ;# J10-24 B34_L4N_W13
set_property -dict {PACKAGE_PIN T12 IOSTANDARD LVCMOS33} [get_ports x_t12]   ;# J10-26 B34_L2P_T12
set_property -dict {PACKAGE_PIN T11 IOSTANDARD LVCMOS33} [get_ports x_t11]   ;# J10-28 B34_L1P_T11
set_property -dict {PACKAGE_PIN L14 IOSTANDARD LVCMOS33} [get_ports x_l14]   ;# J11-35 B35_L22P_L14
set_property -dict {PACKAGE_PIN L15 IOSTANDARD LVCMOS33} [get_ports x_l15]   ;# J11-36 B35_L22N_L15
set_property -dict {PACKAGE_PIN M14 IOSTANDARD LVCMOS33} [get_ports x_m14]   ;# J11-33 B35_L23P_M14
set_property -dict {PACKAGE_PIN M15 IOSTANDARD LVCMOS33} [get_ports x_m15]   ;# J11-34 B35_L23N_M15
set_property -dict {PACKAGE_PIN N15 IOSTANDARD LVCMOS33} [get_ports x_n15]   ;# J11-31 B35_L21P_N15
set_property -dict {PACKAGE_PIN N16 IOSTANDARD LVCMOS33} [get_ports x_n16]   ;# J11-32 B35_L21N_N16
set_property -dict {PACKAGE_PIN V16 IOSTANDARD LVCMOS33} [get_ports x_v16]   ;# J11-29 B34_L18P_V16
set_property -dict {PACKAGE_PIN W16 IOSTANDARD LVCMOS33} [get_ports x_w16]   ;# J11-30 B34_L18N_W16
set_property -dict {PACKAGE_PIN V17 IOSTANDARD LVCMOS33} [get_ports x_v17]   ;# J11-27 B34_L21P_V17
set_property -dict {PACKAGE_PIN V18 IOSTANDARD LVCMOS33} [get_ports x_v18]   ;# J11-28 B34_L21N_V18
set_property -dict {PACKAGE_PIN R16 IOSTANDARD LVCMOS33} [get_ports x_r16]   ;# J11-19 B34_L19P_R16
set_property -dict {PACKAGE_PIN Y19 IOSTANDARD LVCMOS33} [get_ports x_y19]   ;# J11-26 B34_L17N_Y19
set_property -dict {PACKAGE_PIN L16 IOSTANDARD LVCMOS33} [get_ports x_l16]   ;# J11-17 B35_L11P_L16
set_property -dict {PACKAGE_PIN R17 IOSTANDARD LVCMOS33} [get_ports x_r17]   ;# J11-20 B34_L19N_R17
set_property -dict {PACKAGE_PIN K16 IOSTANDARD LVCMOS33} [get_ports x_k16]   ;# J11-15 B35_L24P_K16
set_property -dict {PACKAGE_PIN L17 IOSTANDARD LVCMOS33} [get_ports x_l17]   ;# J11-18 B35_L11N_L17
set_property -dict {PACKAGE_PIN U20 IOSTANDARD LVCMOS33} [get_ports x_u20]   ;# J11-13 B34_L15N_U20
set_property -dict {PACKAGE_PIN J16 IOSTANDARD LVCMOS33} [get_ports x_j16]   ;# J11-16 B35_L24N_J16
set_property -dict {PACKAGE_PIN T17 IOSTANDARD LVCMOS33} [get_ports x_t17]   ;# J11-11 B34_L20P_T17
set_property -dict {PACKAGE_PIN T20 IOSTANDARD LVCMOS33} [get_ports x_t20]   ;# J11-14 B34_L15P_T20
set_property -dict {PACKAGE_PIN M20 IOSTANDARD LVCMOS33} [get_ports x_m20]   ;# J11-9 B35_L7N_M20
set_property -dict {PACKAGE_PIN R18 IOSTANDARD LVCMOS33} [get_ports x_r18]   ;# J11-12 B34_L20N_R18
set_property -dict {PACKAGE_PIN L20 IOSTANDARD LVCMOS33} [get_ports x_l20]   ;# J11-7 B35_L9N_L20
set_property -dict {PACKAGE_PIN M19 IOSTANDARD LVCMOS33} [get_ports x_m19]   ;# J11-10 B35_L7P_M19
set_property -dict {PACKAGE_PIN P15 IOSTANDARD LVCMOS33} [get_ports x_p15]   ;# J11-5 B34_L24P_P15
set_property -dict {PACKAGE_PIN L19 IOSTANDARD LVCMOS33} [get_ports x_l19]   ;# J11-8 B35_L9P_L19
set_property -dict {PACKAGE_PIN N17 IOSTANDARD LVCMOS33} [get_ports x_n17]   ;# J11-3 B34_L23P_N17
set_property -dict {PACKAGE_PIN P16 IOSTANDARD LVCMOS33} [get_ports x_p16]   ;# J11-6 B34_L24N_P16
set_property -dict {PACKAGE_PIN P18 IOSTANDARD LVCMOS33} [get_ports x_p18]   ;# J11-4 B34_L23N_P18
set_property -dict {PACKAGE_PIN K17 IOSTANDARD LVCMOS33} [get_ports x_k17]   ;# J12-14 B35_L12P_K17
set_property -dict {PACKAGE_PIN G18 IOSTANDARD LVCMOS33} [get_ports x_g18]   ;# J12-16 B35_L16N_G18

create_clock -period 40.000 -name f_sck [get_ports f_sck]
create_clock -period 40.000 -name r_sck [get_ports r_sck]
