Mlngyu-Park/2026ESWContest_free_A_IndustryGyuArm/Industry_gyu_arm/sts_arm2.py

# 2번 팔(B팔) 실물 값 — 같은 선에 모터 11~15 (2026-11-02)
#   A팔(1~5)과 다른 팔이라 영점·범위가 다르다. arm_studio_web.py 가 시작할 때 영점·범위·방향 표에 더하고,
#   3D 에서 B팔로 바꾸면(arm_switch) 관절→모터 번호를 이 번호로 갈아끼운다.
ID_OFFSET = 10                      # B팔 모터 번호 = A팔 번호 + 10 (j1~j4 = 11~14, 그리퍼 = 15)

# 기본 자세(base) 영점 — 11-02 B팔을 기본 자세에 두고 잰 값 (sts_apply_arm2.py --ofs-ok 로 위치 보정을 옮긴 뒤)
ZERO_RAW = {11: 2043, 12: 2076, 13: 2069, 14: 1998, 15: 2331}

# 관절 범위 (raw) — 10-29 19:46 잰 값을 11-02 위치 보정 이동만큼 옮긴 것 (sts_apply_arm2_result.json 의 measured)
#   모터 자체 한계는 이보다 20 안쪽 (그리퍼 최소만 11-02 에 2311 로: 닫힌 자리 2331 이 범위 밖이 돼서)
LIMIT_RAW = {11: (638, 3460), 12: (813, 3285), 13: (947, 3152), 14: (886, 3213), 15: (2311, 3788)}

# 방향 — A팔과 같은 부품·같은 조립이라 같다고 본다 (전 관절 반전). ★ 처음 실물로 움직일 때 확인할 것
DIR = {11: -1, 12: -1, 13: -1, 14: -1, 15: -1}

# 그리퍼 — A팔(잰 최소 822 → 닫기 855 · 열기 2060)과 같은 간격: 잰 최소 2328 + 33 / + 1238
GRIPPER_CLOSE = 2361
GRIPPER_OPEN = 3566

# 속도·힘 — A팔 그리퍼(ID 5)와 같게 (그리퍼는 저속에선 안 움직인다)
PER_ID_VEL = {15: 600}            # 11-06 (사용자) 열고 닫기 2배: 300->600 (가속은 arm_studio_web.GRIP_ACCEL)
PER_ID_TQ = {15: 250}
