Mlngyu-Park/2026ESWContest_free_A_IndustryGyuArm/Industry_gyu_arm/sts_limits_measured_arm2_20261029_1943.py

# sts_live_limits.py 측정 (2026-10-29 19:43) — 아직 적용 안 함
# 번호: (최소, 최대) raw. 어느 번호가 어느 관절인지는 측정하며 본 대로 적어 둘 것
MEASURED_RAW={
    11: (67, 2428),
    12: (3914, 6390),
    13: (2025, 3327),
    14: (3356, 3360),
    15: (3227, 3227),
}
