Mlngyu-Park/2026ESWContest_free_A_IndustryGyuArm/Industry_gyu_arm/sts_limits_measured_arm2_20261029_1946.py

# sts_live_limits.py 측정 (2026-10-29 19:46) — 아직 적용 안 함
# 번호: (최소, 최대) raw. 어느 번호가 어느 관절인지는 측정하며 본 대로 적어 둘 것
MEASURED_RAW={
    11: (-396, 2426),
    12: (3919, 6391),
    13: (1871, 4076),
    14: (1743, 4070),
    15: (2328, 3788),
}
