Mlngyu-Park/2026ESWContest_free_A_IndustryGyuArm/Industry_gyu_arm/robot_pins_fixed.py

# pick_robot_pins.py 가 생성한 로봇 기준 목심 2점
# (base_link 로컬 좌표, mm) - 이 파일이 있으면
# arm_studio_web.py 는 자동 감지 대신 이 값만 쓴다.
# 원본 메쉬: /home/drboom/2026_project/urdf/sts3215/Industry_gyu_arm_20260728_base/urdf/../meshes/base_link.STL
ROBOT_PINS_MM = [[210, -250], [270, -250]]
