Mlngyu-Park/2026ESWContest_free_A_IndustryGyuArm/Industry_gyu_arm/cartesian_base_to_1.py

#!/usr/bin/env python3
"""
base -> 1 을 엔드 이펙터 '축별 직선'(x -> y -> z 순서)으로 이동. 실물 + RViz.
- EE가 x축 직선 -> y축 직선 -> z축 직선 순서로 한 축씩 이동
- 그리퍼 기울기(가리키는 방향) 고정 (orientation_mode='Z')
- 경로 전체를 먼저 IK로 계산/검증, 전부 통과해야만 움직임 (안전)
- 돌아올 땐 역순 (z -> y -> x)

실행: conda run --no-capture-output -n gyu_arm python cartesian_base_to_1.py [--loop]
RViz: ros2 launch Industry_gyu_arm_20260724_base_position jog.launch.py
Ctrl+C = 즉시 토크 OFF.
"""
import sys, math, time, signal
import numpy as np
import xml.etree.ElementTree as ET
from ikpy.chain import Chain
from ikpy.link import OriginLink, URDFLink
from dynamixel_sdk import PortHandler, PacketHandler
import rclpy
from rclpy.node import Node
from sensor_msgs.msg import JointState

sys.stdout.reconfigure(line_buffering=True)
LOOP="--loop" in sys.argv

PORT='/dev/ttyUSB0'; BAUD=57600
ADDR_TORQUE=64; ADDR_P_ACCEL=108; ADDR_P_VEL=112; ADDR_GOAL=116; ADDR_PRESENT=132
ADDR_DRIVE_MODE=10
SAFE_VEL=25; SAFE_ACCEL=8
# 시간 기반 프로파일 (스트리밍 떨림 방지): 웨이포인트당 이동시간(ms)
PROFILE_MS=110; ACCEL_MS=35   # 1.5배속
URDF='/home/drboom/2026_project/urdf/Industry_gyu_arm_20260724_base_position/urdf/Industry_gyu_arm_20260724_base_position.urdf'

JOINTS=['j1','j2','j3','j4','j5','j6']
J2ID=[0,1,2,4,3,5]                                   # j4<->j5 배선 교차
ZERO_RAW={0:1517,1:2483,2:1562,3:2244,4:2545,5:2018}
DIR={0:-1,1:1,2:1,3:1,4:1,5:1}                        # j1 반전
LIMIT_RAW={0:(380,2571),1:(1479,3555),2:(1334,3382),3:(1271,3153),4:(1599,3524),5:(1970,3525)}

BASE=[0.0]*6
POSE1=[-0.3161,0.3773,-0.3053,0.0,-0.6826,0.0]        # jog 교정본
N_WAY=40           # 웨이포인트 수
WAY_DT=0.08        # 웨이포인트 간격(s) - 1.5배속

def s32(v): return v-0x100000000 if v>0x7FFFFFFF else v
def jr_limits(jidx):
    i=J2ID[jidx]; lo,hi=LIMIT_RAW[i]
    a=DIR[i]*(lo-ZERO_RAW[i])*math.pi/2048.0
    b=DIR[i]*(hi-ZERO_RAW[i])*math.pi/2048.0
    return (min(a,b),max(a,b))
def rad_to_raw(jidx,rad):
    i=J2ID[jidx]
    raw=int(ZERO_RAW[i]+DIR[i]*rad*2048.0/math.pi)
    lo,hi=LIMIT_RAW[i]; return max(lo,min(hi,raw)), i

def build_chain():
    root=ET.parse(URDF).getroot()
    jm={j.get('name'):j for j in root.findall('joint')}
    links=[OriginLink()]; active=[False]
    for k,jn in enumerate(JOINTS):
        j=jm[jn]; o=j.find('origin')
        xyz=[float(x) for x in o.get('xyz').split()]
        rpy=[float(x) for x in (o.get('rpy') or '0 0 0').split()]
        ax=[float(x) for x in j.find('axis').get('xyz').split()]
        links.append(URDFLink(name=jn,origin_translation=xyz,origin_orientation=rpy,
                              rotation=ax,bounds=jr_limits(k),joint_type='revolute'))
        active.append(True)
    return Chain(name='arm',links=links,active_links_mask=active)
CHAIN=build_chain()
def fk(q):
    T=CHAIN.forward_kinematics([0]+list(q)); return T[:3,3].copy(), T[:3,:3].copy()
def rot_aa(a,th):
    a=a/np.linalg.norm(a); x,y,z=a; c,s=np.cos(th),np.sin(th); C=1-c
    return np.array([[c+x*x*C,x*y*C-z*s,x*z*C+y*s],
                     [y*x*C+z*s,c+y*y*C,y*z*C-x*s],[z*x*C-y*s,z*y*C+x*s,c+z*z*C]])

def plan_axis_path(qa,qb,axis_order):
    """qa->qb 를 축별 직선(axis_order 순서)으로 이동하는 관절 웨이포인트.
    그리퍼 z축(기울기)은 진행률에 따라 slerp (대개 고정). 실패 시 None."""
    p0,r0=fk(qa); p1,r1=fk(qb)
    d=p1-p0
    total=sum(abs(d[i]) for i in range(3))
    if total<1e-6: return [list(qa),list(qb)]
    z0=r0[:,2]; z1=r1[:,2]
    cz=np.clip(np.dot(z0,z1),-1,1); angz=np.arccos(cz)
    axz=np.cross(z0,z1)
    axz=axz/np.linalg.norm(axz) if np.linalg.norm(axz)>1e-9 else np.array([1,0,0.0])
    way=[list(qa)]; q=list(qa); cur=p0.copy(); traveled=0.0; seg_end=[]
    for axis_i in axis_order:
        dist=d[axis_i]
        if abs(dist)<0.002:
            cur[axis_i]+=dist; traveled+=abs(dist); seg_end.append(None); continue
        n=max(6,int(abs(dist)/0.003))            # 3mm당 1점
        for k in range(1,n+1):
            t=k/n; te=t*t*(3-2*t)                # 구간별 가감속
            pt=cur.copy(); pt[axis_i]+=dist*te
            frac=(traveled+abs(dist)*te)/total
            zt=rot_aa(axz,angz*frac)@z0
            sol=CHAIN.inverse_kinematics(target_position=pt,target_orientation=zt,
                                         orientation_mode='Z',initial_position=[0]+q)
            qn=list(sol[1:])
            pchk,_=fk(qn)
            if np.linalg.norm(pchk-pt)>0.004: return None
            if max(abs(a-b) for a,b in zip(qn,q))>math.radians(15): return None
            way.append(qn); q=qn
        cur[axis_i]+=dist; traveled+=abs(dist)
        seg_end.append(len(way)-1)
    way[-1]=list(qb)   # 끝점은 정확히 목표 관절각 (검증상 이미 일치)
    return way

# --- 모터/ROS ---
port=PortHandler(PORT); packet=PacketHandler(2.0)
if not port.openPort(): print("포트 실패"); raise SystemExit
port.setBaudRate(BAUD)
def set_time_profile(on):
    """시간 기반 프로파일 ON/OFF. Drive Mode(EEPROM)는 토크 OFF 상태에서만 변경 가능."""
    for i in ZERO_RAW:
        packet.write1ByteTxRx(port,i,ADDR_TORQUE,0)
    for i in ZERO_RAW:
        dm,r,_=packet.read1ByteTxRx(port,i,ADDR_DRIVE_MODE)
        if r!=0: continue
        ndm = (dm|0x04) if on else (dm & ~0x04)
        if ndm!=dm:
            packet.write1ByteTxRx(port,i,ADDR_DRIVE_MODE,ndm)
    for i in ZERO_RAW:
        if on:   # 시간 기반: vel=이동시간(ms), accel=가속시간(ms)
            packet.write4ByteTxRx(port,i,ADDR_P_ACCEL,ACCEL_MS)
            packet.write4ByteTxRx(port,i,ADDR_P_VEL,PROFILE_MS)
        else:    # 속도 기반 원복 (다른 스크립트용 안전)
            packet.write4ByteTxRx(port,i,ADDR_P_ACCEL,SAFE_ACCEL)
            packet.write4ByteTxRx(port,i,ADDR_P_VEL,SAFE_VEL)

def emergency_off(*_):
    print("\n[긴급정지] 토크 OFF + 프로파일 원복")
    signal.signal(signal.SIGINT, signal.SIG_IGN)
    for i in ZERO_RAW: packet.write1ByteTxRx(port,i,ADDR_TORQUE,0)
    try: set_time_profile(False)   # 속도 기반으로 원복 (중요: 다른 스크립트 안전)
    except Exception: pass
    port.closePort()
    try: rclpy.shutdown()
    except Exception: pass
    sys.exit(0)
signal.signal(signal.SIGINT, emergency_off)

# 시간 기반 프로파일 설정 + 토크 ON
set_time_profile(True)
for i in ZERO_RAW:
    packet.write1ByteTxRx(port,i,ADDR_TORQUE,1)

rclpy.init(); node=Node('cartesian_base_to_1')
pub=node.create_publisher(JointState,'joint_states',10)
def publish(q):
    m=JointState(); m.header.stamp=node.get_clock().now().to_msg()
    m.name=list(JOINTS); m.position=[float(x) for x in q]; pub.publish(m)
def send_joints(q):
    for jidx in range(6):
        raw,i=rad_to_raw(jidx,q[jidx])
        packet.write4ByteTxRx(port,i,ADDR_GOAL, raw & 0xFFFFFFFF)
def read_joints():
    q=[0.0]*6
    for jidx in range(6):
        i=J2ID[jidx]
        p,r,_=packet.read4ByteTxRx(port,i,ADDR_PRESENT)
        if r==0: q[jidx]=DIR[i]*(s32(p)-ZERO_RAW[i])*math.pi/2048.0
    return q

# --- 경로 미리 계산/검증 (움직이기 전) ---
print("경로 계산 중 (base->1: x->z->y, 1->base: y->z->x)...")
path_fwd=plan_axis_path(BASE,POSE1,[0,2,1])    # x -> z -> y
path_back=plan_axis_path(POSE1,BASE,[1,2,0])   # y -> z -> x (역순 복귀)
if path_fwd is None or path_back is None:
    print("경로 계산 실패 - 중단 (로봇 안 움직임)"); emergency_off()
print(f"경로 OK: 가는길 {len(path_fwd)}점, 오는길 {len(path_back)}점. 이동 시작.")

# --- 시작: 관절 순서대로 base 이동 ---
print("먼저 base 자세로 (관절 순서대로, Ctrl+C=정지)")
q=read_joints()
for jidx in range(6):
    if abs(q[jidx])<0.005: q[jidx]=0.0; continue
    print(f"  j{jidx+1} 이동")
    start=q[jidx]
    for k in range(51):
        t=k/50; t=t*t*(3-2*t)
        q[jidx]=start*(1-t)
        send_joints(q); publish(q); time.sleep(0.05)
    time.sleep(0.2)
time.sleep(0.6)

def run_path(way,label):
    print(f"  -> {label} (EE 직선)")
    for qq in way:
        send_joints(qq); publish(qq); time.sleep(WAY_DT)

print("시퀀스: base->1->base (EE 직선 경로)" + (" 반복" if LOOP else ""))
while True:
    run_path(path_fwd,"1");    time.sleep(0.8)
    run_path(path_back,"base");time.sleep(0.8)
    if not LOOP: break

print("완료. Ctrl+C로 토크 해제.")
try:
    while True: time.sleep(1)
except KeyboardInterrupt:
    emergency_off()
