Mlngyu-Park/2026ESWContest_free_A_IndustryGyuArm/Industry_gyu_arm/cam_grid/camsync.py

"""ARM STUDIO 앱용 카메라 동기화 — 녹화 영상으로 카메라 위치 · 1인칭 · 판 위 물건(로봇·도킹)을 읽는다.

앱(arm_studio_web.py)은 이 모듈의 SYNC 하나만 쓴다:
    SYNC.load(path)               영상 분석 시작 (백그라운드, 수 초)
    SYNC.ctl(cmd)                 play / pause / fp(1인칭) / view(1인칭 보기: 영상+트윈 → 트윈만 → 영상만) /
                                  auto(자동 반영 켜기·끄기) / rot(판 90도) / x± y±(한 칸) / tx± ty±(한 타일) / reset
    SYNC.state(origin, ztop)      뷰어 /state 에 실을 dict (프레임 = 재생 시각)
    SYNC.jpeg(k)                  k 번째 프레임 JPEG

좌표
  판 좌표: pose.py — 판 30×30 의 첫 목심이 원점 (m, z 위). 첫 목심은 타일 경계에 맞춰져 있다.
  앱 월드: 판의 첫 목심을 앱 바닥판 '왼쪽 아래 타일' 의 첫 목심(origin)에 맞춘다.
           rot(판 가운데 기준 90도씩)·shift 로 사용자가 고칠 수 있다.

물건 (objects.py)
  '가려진 구멍' 으로 로봇(위치만)과 도킹(위치 + 색)을 읽는다. 영상을 처음부터 따라가며 판정을
  시간순으로 기록해 두고, 재생 시각까지 카메라가 본 만큼의 배치를 낸다 (녹화 영상에서의 실시간).
"""
import os, sys, threading, time, math
import numpy as np
import cv2

HERE = os.path.dirname(os.path.abspath(__file__))
if HERE not in sys.path: sys.path.insert(0, HERE)
from grid import Board, detect_holes, pitch_of            # noqa: E402
from pose import PITCH, focal_from_H, K_of, camera_pose   # noqa: E402
from objects import Tracker, N, COLOR_HEX                 # noqa: E402

SIDE = 29 * PITCH                 # 첫 목심 ~ 마지막 목심 (580 mm)
JPEG_W = 960                      # 1인칭 배경으로 보내는 영상 폭
SNAP_EVERY = 4                    # 물건 판정을 몇 프레임마다 기록하나
PERSIST = 3                       # 연속 몇 번 같은 자리에 있어야 인정하나 (깜빡임 막기)


def robot_template(mesh_path):
    """로봇 받침 메쉬(base_link)에서 자세 맞추기에 쓸 것들 (로컬 m).
    위에서 본 높이 지도로: 날개 판 윗면 높이, 기둥 가운데, 판 구멍들, '틈 있는 가장자리' 의 구멍 한 쌍."""
    import trimesh
    from scipy import ndimage
    m = trimesh.load(mesh_path); v = np.asarray(m.vertices) * 1000; F = np.asarray(m.faces)
    lo = v[:, :2].min(0) - 5; hi = v[:, :2].max(0) + 5
    Hm = np.full((int(hi[1] - lo[1]) + 1, int(hi[0] - lo[0]) + 1), -1.0)
    for f in F:
        t = v[f]; z = t[:, 2].max()
        msk = np.zeros(Hm.shape, np.uint8); cv2.fillPoly(msk, [(t[:, :2] - lo).astype(np.int32)], 1)
        b = msk.astype(bool); Hm[b] = np.maximum(Hm[b], z)
    z0 = v[:, 2].min()
    lvl = float(np.median(Hm[(Hm > z0) & (Hm < z0 + 25)]))           # 낮은 판 윗면
    col = np.argwhere(Hm > lvl + 5).mean(0)[::-1] + lo
    inside = ndimage.binary_fill_holes(Hm > 0)
    dent = inside & ((Hm < 0) | (Hm < lvl - 2)) & ~(Hm > lvl + 5)
    dent &= ~ndimage.binary_dilation(Hm > lvl + 5, iterations=2)
    lab, n = ndimage.label(dent)
    holes = np.array([np.argwhere(lab == k).mean(0)[::-1] + lo for k in range(1, n + 1)
                      if 15 <= (lab == k).sum() <= 200])
    # 기둥에서 가장 먼 쪽 가장자리의 구멍 한 쌍 (실물에서는 '구멍 줄 + 틈' 이 있는 앞 가장자리)
    d = (holes - col) @ ((holes.mean(0) - col) / (np.linalg.norm(holes.mean(0) - col) + 1e-9))
    front = holes[np.argsort(d)[-2:]].mean(0)
    return {'hb': (lvl - z0) / 1000, 'col': col / 1000, 'front': front / 1000}
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
