Mlngyu-Park/2026ESWContest_free_A_IndustryGyuArm/(commit log)

2026-08-05 ARM STUDIO 초기 백업 — 블록 기반 로봇팔 제어 스튜디오
    start.sh 실행에 필요한 구성 전체:
    - Industry_gyu_arm/ 웹 스튜디오 본체 + 모터 세팅 스크립트
    - urdf/ base / 1st_position 자세 정의
    - stl/ 작업 환경 메쉬 (docking, plate, seed_plate)
    - README.md 프로젝트 소개
    캘리브레이션 (실측값, 재현 불가):
    sts_zero.py base 영점 (2026-07-28)
    sts_limits.py 관절 한계 (2026-07-27 재측정)
    sts_gripper.py 그리퍼 열림/닫힘
    동일 디렉토리의 javis/, ecc/ 등 무관한 7GB 는 .gitignore 화이트리스트로 제외.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
    [Industry_gyu_arm_20260721 - docking_station-6.STL, Industry_gyu_arm_20260727 - docking_station-5.STL, Industry_gyu_arm_20260727 - plate_bottom-10.STL, Industry_gyu_arm_20260727 - plate_bottom-7.STL, Industry_gyu_arm_20260727 - plate_bottom-8.STL, Industry_gyu_arm_20260727 - plate_bottom-9.STL, Industry_gyu_arm_20260727 - seed_plate-1.STL, Industry_gyu_arm_20260728.csv]
2026-08-05 UI 산업용 테마: 다크/라이트 토글, 버튼 위계, 파이프라인 블록화
    - 테마: 강철/그래파이트 팔레트, 헤더의 [◐ 다크/라이트]로 전환
    (localStorage 기억, 3D 뷰어 배경도 postMessage로 함께 전환)
    - 버튼 위계: 실물이 움직이는 버튼 = 안전 주황(실행/이 자세로),
    조그·그리퍼·토크 = 주황 외곽선, 편집 = 강철 파랑, 정지 = 빨강 유지
    - 파이프라인 Radio를 블록 룩으로: ■자세=파랑 블록, ┃이동=점선 들여쓰기,
    ◆그리퍼=호박색 (JS가 기호로 분류, 배선 변경 없음 = 기능 무위험)
    - 조인트 선택 J1~J5 세그먼트 버튼화, 상태창 HMI 콘솔 스타일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
2026-08-06 UI 베이스 수정: 다크모드 실작동 + 정렬 + 시안 4종 CSS 보관
    - gradio 6 은 launch(js=)를 실행하지 않음 -> head= <script> 주입으로 교체
    (다크/라이트 토글, 뷰어 연동, 파이프라인 블록 분류가 이제 실제로 동작)
    - 다크 변수를 html.dark 로 재정의 (gradio 자체 .dark 보다 우선)
    - 테마 토글을 순수 HTML 버튼으로 (gradio 이벤트 js 의존 제거)
    - 정지 버튼 직접 빨강 (gradio 6 cancel 변수 미사용 대응)
    - 정렬: ↻ 아이콘 버튼화, 행 하단 정렬, 버튼 높이 통일, 자세 목록 칩화
    - ui_variants/: 시안 A(STEEL HMI) B(BLUEPRINT) C(MISSION CONSOLE)
    D(MODERN PRO) — 선택되면 THEM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
2026-08-06 파이프라인 블록 가시성 + 전 버튼 크기 통일
    - ■자세 = 강철파랑 꽉 찬 블록(흰 글씨), ◆그리퍼 = 호박색 채움
    - ┃이동 = 들여쓰기 + 점선 테두리, 위아래 블록을 잇는 세로 연결선 추가
    - 선택 = 3px 안전주황 링 (채운 블록 위에서도 확실)
    - 모든 gr.Button(lg/md/sm) 높이 44px·글자 크기 통일 — 크기 제각각 해소
    - 다크/라이트 양쪽 스크린샷 검증 완료
2026-08-07 URDF 디렉토리 로봇 패밀리별 분할: sts3215/ + dynamixel/
    - urdf/sts3215/ SO-ARM101(STS3215) 패키지 2종 이동 (calib.json 동반)
    - urdf/dynamixel/ 옛 Dynamixel 로봇 20260723 자세 4종 신규 추가
    (base_postion / 1st / 2nd / 3rd_position)
    - base 자동탐색을 활성 패밀리 폴더로 한정 (ARM_ROBOT_FAMILY, 기본 sts3215)
    -> 양쪽 폴더에 base 가 있어도 섞이지 않음. 구버전 평면 구조도 호환
    - 검증: base 탐색·보정 데이터·자세 3종 로드 정상
    [Industry_gyu_arm_20260723_1st_position.csv, Industry_gyu_arm_20260723_1st_position.urdf, Industry_gyu_arm_20260723_2nd_position.csv, Industry_gyu_arm_20260723_2nd_position.urdf, Industry_gyu_arm_20260723_3rd_position.csv, Industry_gyu_arm_20260723_3rd_position.urdf, Industry_gyu_arm_20260723_base_postion.csv, Industry_gyu_arm_20260723_base_postion.urdf]
2026-08-07 매크로 버튼 1·2·3: 현재 위치 기록 -> 원버튼 이동
    - [이동] 탭에 ▶M1/M2/M3 (주황 = 실물 동작) + 슬롯 선택/기록/비우기
    - 기록: 실물 연결 시 실물 좌표, 아니면 3D 자세 (출처 표시)
    - 재생: h_ft_goto 와 같은 안전 절차 - 수평 유지(j5 고정)·그리퍼 상태
    불변·정지 버튼 즉시 반응, 터미널 이동 로그(tag=M{n})
    - calib.json 에 영속화 (S['macros']) - 재시작해도 유지
    - 입력과 동작 분리: 추후 물리 버튼(아두이노/RP2040)·조이스틱 버튼도
    같은 h_macro_go(slot) 을 부르면 됨
    - 검증: 기록/라벨 갱신/빈 슬롯 안내/영속화 실클릭 테스트 통과
    Co-Authored-B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
2026-08-07 웹 디자인 롤백 (back_up 기준) — 기능은 유지
    - 디자인: back_up/Industry_gyu_arm/arm_studio_web.py (초기 백업 8e1aa5f)와
    100% 동일로 복원 — 테마/CSS/다크모드/블록 스타일 전부 제거
    - 유지한 기능 (백업 대비 추가분 94줄):
    1) URDF 로봇 패밀리 분할 탐색 (ROBOT_FAMILY, urdf/sts3215 우선)
    2) 매크로 버튼 1·2·3 (기록/재생/비우기, calib.json 영속화)
    - 스크린샷 검증: 원본 디자인 + 매크로 섹션 정상 렌더
2026-08-07 로봇 베이스 위치 자유 배치 (플레이트 타일 스냅)
    - BASE_OFF 도입: fk/fk_points/link_frames 는 월드 좌표(+오프셋),
    IK 목표는 로컬(-오프셋) - 나머지 코드는 전부 월드라 무수정
    - IK 5곳(직선/회전/축별/수평4축) 목표 변환, 뷰어/plotly base 메쉬,
    2D 맵 로봇 발자국(_fill_mesh2d off), 충돌 격자까지 일괄 반영
    - [환경] 탭 "로봇 위치": 이동 모드 켜면 3D에서 플레이트 타일이
    초록 클릭 대상이 됨 -> 클릭한 타일 중앙으로 로봇 이동. 원점 복귀 버튼
    - 이동 시 IK/최대높이/경로 캐시·장애물 격자 자동 무효화
    - calib.json 에 robot_xy 영속화 (재시작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
2026-08-07 멀티 로봇: Dynamixel 지원 + 실행 로봇 선택 (EE 경로 공유)
    원리: 두 로봇이 공유하는 것은 관절각이 아니라 EE 경로.
    각자 base 자세 기준 EE 변위를 (앞,옆,위) 축 정렬로 옮기고 각자 IK 로 푼다.
    - dxl_profile/dxl_zero: 2026-07-24 실측 (j4<->j5 배선 교차, j1 방향 -1,
    한계·영점). 영점은 VERIFIED=False - 재캡처 전 경고 표시
    - dxl_scan.py / dxl_capture_zero.py: 스캔·영점 캡처 도구
    - DXL 기구학: URDF 가 y-up(SolidWorks) 이어도 프레임 파라미터 자동 산출
    (up 축/EE 수직축/orientation_mode). 수평 유지 4축도 자동 판별
    - STS=j1,j2,j3,j4 / DXL=j1,j2,j3,j5 (네이밍 꼬임 자동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
2026-08-08 시뮬레이션 모드 + Dynamixel 영점 확정
    - [이동] 탭 실행 로봇에 '시뮬레이션 (로봇 없이)' 추가
    로봇 미연결/미배선이어도 실행 버튼이 그대로 동작하고 3D·RViz 만 재생.
    RobotMux._sim() 이 _sts()/_dxl() 를 모두 False 로 만들어 통신 전면 생략
    (connect=항상 True, read=3D 현재자세, wait/settle=시간 페이싱, estop=무동작)
    - DXL 영점 확정: {0:1486,1:2523,2:1468,3:2210,4:2567,5:1992}
    캡처 스트림의 안정값. 가동범위가 j1 -95~+97, j2 -92~+91 로 대칭 =
    기계적 중립에 정확히 앉음. 옛 7/24 영점과도 3~8도 이내 일치
    - 실물 검증 완료: 94도 대이동 base 복귀, 도착 오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
2026-08-08 버그: RobotMux 에 last_want/last_got/port 위임 누락
    증상: [토크 해제] 등에서 "'RobotMux' object has no attribute 'last_want'"
    원인: 멀티로봇 파사드 도입 시 Robot 의 데이터 속성을 옮기지 않음.
    추종 비교 로그(LOG_COMPARE)가 ROBOT.last_want/last_got 를 4곳에서 읽고,
    종료 정리 코드가 ROBOT.port 를 읽는다.
    수정: 세 속성을 프로퍼티로 위임 (port 는 STS/DXL 중 열린 것)
    검증: ROBOT.* 사용 속성 14개를 sim/sts/dxl/both 네 모드에서 전수 접근 -
    전부 통과. h_torque_off 정상 동작 확인
2026-08-08 공간 선택: 목심 좌표 이동 + 3D 호버/클릭 + 미리보기 + 자세 등록
    URDF 자세 없이 "바닥 목심 + 높이" 만으로 이동하는 좌표계를 추가.
    목심 간격 20mm 는 플레이트 STL 자기상관으로 실측 (플레이트당 10x10).
    - 높이 기준 = 플레이트 윗면(z=20mm) -> j6 축 원점 (IK 가 푸는 그 점).
    "0mm = 플레이트 표면에 닿음" 이 되어 사람이 말하는 높이와 일치
    - 3D 목심 인터랙션: 평소 안 보이고, 호버한 구멍만 노랑(도달가능)/
    빨강(불가), 클릭하면 파랑(선택). 400개를 항상 칠하지 않아 화면이 깨끗
    - 선택하면 그 목심까지 가는 경로를 3D 에서 왕복 반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
2026-08-09 툴 중심(axis_7) 3D 표시 — 기존 URDF 유지
    사용자가 SolidWorks 에서 그리퍼 회전 원의 중심에 axis_7 좌표계를 만들고
    j7(fixed) 로 내보낸 URDF(20260809_base)를 제공. 비교 결과:
    - j1~j6 (xyz/rpy/axis) 차이 0건
    - 메쉬 7개 형상 동일 (정점수/bounds/무게중심 오차 0.0000mm,
    md5 만 다른 것은 재내보내기 타임스탬프 때문)
    -> URDF 를 갈아탈 이유가 없어 기존 20260728 을 그대로 base 로 고정하고
    (base_urdf.txt) axis_7 오프셋만 가져다 쓴다.
    - TOOL_OFF = j6 에서 (-9.0, 39.5, 39.3)mm, 거리 56.5mm
    URDF 에 j7 이 있으면 그 값이 우선, 없으면 이 상수로 폴백
    - tool_pos(q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
    [Industry_gyu_arm_20260809_base.csv, Industry_gyu_arm_20260809_base.urdf, base_link.STL, l1.STL, l2.STL, l3.STL, l4.STL, l5.STL]
2026-08-09 목심 이동 기준을 axis_6 -> axis_7(툴 중심)으로 전환
    지금까지 목심 위로 가던 것은 j6 원점이라 실제 그리퍼 중심은 그보다
    56.5mm 벗어난 곳에 있었다. 이제 자홍색 마커(툴 중심)가 목심 위에 온다.
    - ik_tool(): 툴 중심을 목표로 푸는 수평유지 IK.
    IK 는 j6 를 풀고 툴 오프셋의 월드 방향은 j1 회전에 따라 달라지므로
    (z 성분만 일정) 한 번에 뺄 수 없다 -> '풀고, 툴 위치 오차만큼 목표를
    밀어주고' 를 반복해 수렴시킴. 보통 2~3회, 0.5mm 이내에서 종료
    - 목심 관련 IK 5곳 전환: 도달성 판정(워커 2), 미리보기, 실물 이동, 자세 등록
    - 도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
2026-08-09 툴 IK 수렴 기준 조임: 오차 0.15mm -> 0.002mm
    오차의 원인은 원리적 한계가 아니라 임의로 정한 정지 조건이었다.
    반복마다 오차가 약 7배씩 줄어든다(측정): 56.5 -> 1.23 -> 0.16 -> 0.02
    -> 0.003 -> 0.0004mm. "0.5mm 이내면 충분" 에서 멈춰 0.16mm 가 남았던 것.
    0.01mm 로 조여도 IK 1회당 11.3ms -> 15.7ms (4ms 증가) 뿐이라 조인다.
    검증: 목심 이동 도착 오차 0.0024mm, 스캔 시간은 2.3초로 동일.
2026-08-09 목심 도달성: xy 링 선별 먼저 (사용자 제안) + 해석적 IK 뼈대
    사용자 제안: 높이를 바꾸면 먼저 xy 평면에서 가능/불가를 가르고, 그 다음
    z 를 계산하면 빠르다 -> 맞았고, 기존 반경 컷이 무용지물이었음을 확인.
    - 기존 _arm_reach() 는 링크 길이 단순 합(765mm)이라 400개 중 0개를 걸렀다.
    실측 도달 반경은 190~360mm (최소 반경도 존재 - 너무 가까우면 못 감)
    - reach_ring(z): 평면 팔(j2,j3,j4) 구조에서 그 높이의 도달 수평거리 구간을
    공식으로 계산. 3D IK 전에 (x,y) 만으로 링 밖을 탈락시킨다
    높이 80mm -> 링 124~368mm, 150mm -> 138~375mm
    - ik_tool_f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
2026-08-09 목심 도달 구간표: 1mm 정밀 사전계산 -> 조회는 즉시
    사용자 제안: 1mm(z축) 기준으로 도달 가능한 목심을 미리 다 계산해두고
    나중에 불러오기만 하자. 실측 결과 각 목심의 도달 높이가 '연속 구간'
    (중간 끊김 0곳)이어서, 목심마다 [zmin,zmax] 두 값만 저장하면 된다.
    -> 1mm 는 물론 소수점 높이까지 해상도 제한 없이 조회 가능.
    - build_peg_table(): 목심마다 이분탐색으로 도달 구간을 1mm 정밀도로 산출.
    fork 프로세스 병렬. 400개에 51초 (최초 1회, 로봇위치/URDF 바뀌면 무효화)
    - peg_reachable_fast(): 표에서 즉시 조회. 0.04~0.14ms (기존 2초)
    - 목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
2026-08-09 3D 뷰: EE(axis_6) 축 표시 숨김
    기준점이 툴 중심(axis_7, 자홍색)으로 바뀌었으므로 j6 축이 함께 보이면
    어느 쪽이 기준인지 헷갈린다. eeAxes.visible=false 로 숨기고 범례에서도
    '작은축=EE' 문구 제거. 위치 갱신 로직은 그대로 두어 필요하면 다시 켤 수 있음.
2026-08-09 버그: 빨간(도달불가) 목심이 클릭·이동되던 문제 + 색 판정 지연
    사용자 지적 3가지를 전부 확인하고 수정:
    1) "빨간색 클릭해도 움직인다"
    - 뷰어 클릭 핸들러가 ok 플래그를 안 봤고, 서버 /peg/ 도 무조건 선택했다.
    - h_peg_goto 는 표를 안 보고 자기가 IK 를 다시 풀어서, 표가 불가라 해도
    솔버가 어쩌다 풀리면 그냥 움직였다 (판정과 실행이 다른 계산)
    -> 3중으로 막음: JS 클릭 무시 / 서버 선택 거부 / 이동 실행 전 재확인
    2) "계산이 이상하다" = 색이 실제와 어긋남
    - 슬라이더가 release(놓을 때)에만 갱신돼서, 드래그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
2026-08-09 버그: 도달 구간표의 '연속 구간' 가정이 틀렸음 -> 구간 목록으로
    사용자 지적("미리 계산하는 방식에서 도달 가능한 것이 불가능하다고 뜬다")
    확인 결과 사실이었다. 원인은 내가 표본 3개만 보고 "각 목심의 도달 높이는
    연속 구간"이라고 단정한 것.
    실제로는 관절 한계 때문에 중간이 끊기는 목심이 있다:
    0,0:I8 -> 0~0mm 가능, 2~38mm 불가, 40~232mm 가능
    이런 목심에 [min,max] 하나만 저장하니 구멍 구간이 '가능'으로 잘못 떴다.
    (400개 중 4개: A2, A6, I8, D10)
    - _peg_span_one: 이분탐색(구간 1개 가정) -> 1mm 전수 검사 후 구간 목록 저장
    - peg_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
2026-08-09 목심 도달표 사전계산기 (peg_table_build.py) + 앱 자동 로드
    오래 걸리는 계산(1mm 전수, 약 6분)을 앱과 분리해 미리 돌려두고,
    앱은 결과 파일만 불러 쓴다.
    - peg_table_build.py: 목심 400개 x 높이 0~250mm(1mm) 도달성을 계산해
    <URDF 패키지>/peg_table.json 에 저장. --max-h / --out 옵션.
    진행 정보(로봇 위치, 플레이트, 워커 수, 총 IK 횟수)를 먼저 출력
    - arm_studio_web: 시작 시 load_peg_table() 로 자동 로드.
    로봇 위치/URDF/플레이트 배치가 파일과 다르면 무시하고 안내 (재생성 필요)
    - 앱 안에서 표를 만든 경우에도 같은 파일로 저장 -> 다음 실행부터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
2026-08-09 3D 뷰: 플레이트 위 base_link 좌표계 축 숨김
    플레이트 바닥에 그려지던 큰 X/Y/Z 축을 표시하지 않는다.
    범례도 축 설명을 빼고 툴 중심(자홍색)만 남겼다.
    (makeAxes 호출을 주석 처리한 것이라 필요하면 한 줄로 복구 가능)
    남는 표시: 툴 중심(axis_7) 자홍색 구 + 작은 축.
    EE(j6) 축은 앞선 커밋에서 이미 숨김.
2026-08-09 버그: 목심 미리보기 자기오염 + '확확 튀는' 재생
    사용자 지적 2가지 모두 실제 버그였다. 스레드 중첩은 없었고(정지 로직 정상)
    원인은 다른 두 가지:
    1) 출발 자세 자기오염
    _peg_sim_loop 이 매번 CURRENT_Q 를 출발점으로 읽는데, 그 CURRENT_Q 는
    미리보기가 스스로 움직여 놓은 중간 자세다. 그래서 같은 목심을 다시
    선택하면 출발점이 0도 -> 97도 -> 101도 로 계속 바뀌고 경로가 달라졌다.
    -> 재생 시작 때 기준 자세(home)를 기억해 넘기고, 정지 시 그 자세로 복귀
    2) '확확' 튀는 느낌
    웨이포인트 101개를 40프레임으로 솎아내면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
2026-08-09 버그: 플레이트를 추가하면 새 목심이 전부 빨강으로 뜨던 문제
    원인: 플레이트를 추가하면 목심이 100개 늘어나는데(400->500),
    PEG_VIEW['ok'] 는 추가 이전 목록 그대로였다. 뷰어는 그 목록으로 색을
    칠하므로 새 목심은 전부 '불가(빨강)'. 슬라이더를 건드려야 갱신됐다.
    계산 자체는 정확했고(새 플레이트 목심 16개 도달 가능 = 실제 IK 와 일치)
    갱신 시점만 빠져 있었다.
    - _peg_layout_changed(): 도달표/캐시 무효화 + dirty 플래그.
    add_plate / remove_plate 에서 호출
    - 뷰어 /state 가 dirty 를 보면 그 자리에서 한 번 재계산해 반영
    (표가 아직 없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
2026-08-09 잡을 수 있는 물체(bricks): PPAP 등록 + 도킹 위 배치 + 잡기 판정
    사용자 정의: 잡기 조건은 두 가지뿐이다.
    ① 물체 중심축(axis_ppap)과 툴 중심축(axis_7)이 x-y 에서 일치
    ② 두 축의 z 수직거리 = 36.37mm (PPAP 바닥 기준)
    원통이라 회전 방향은 무관하고, 수평 유지는 기존 IK 가 이미 보장한다.
    - urdf/bricks/ 스캔해 물체 자동 등록. PPAP 실측: 지름 34.0mm 높이 139.5mm,
    중심축이 메쉬 원점 (URDF 의 ppap_j1 은 xyz=0 이라 거리 정보가 없어
    사용자가 알려준 36.37mm 를 GRASP_DZ_DEFAULT 로 사용)
    - place_brick_on_docking(): 도킹 스테이션 중심축에 물체를 세움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
    [Industry_gyu_arm_20260809_ppap.csv, Industry_gyu_arm_20260809_ppap.urdf, ppap_base.STL, ppap_l1.STL]
2026-08-09 잡기/놓기 블록 + UI (그리퍼는 열기/닫기만으로 충분)
    do_grasp: 접근 -> 그리퍼 열기 -> 하강(잡는 점) -> 닫기 -> 상승
    do_release: 접근 -> 하강 -> 열기 -> 상승 (잡기의 역순, 물체 위치 갱신)
    잡는 조건은 축 일치 + z 거리 36.37mm 뿐이고, 그리퍼는 열림/닫힘 두 상태로
    충분하다는 사용자 정의를 그대로 따랐다.
    - _lift_point(): 접근/상승 여유 높이를 '실제 도달 가능한' 값으로 자동 선택.
    6cm 를 고정으로 쓰니 팔 한계로 접근점이 도달 불가였다(잡는 점은 가능한데)
    -> 6cm 부터 1cm 씩 낮춰 가능한 높이를 찾는다 (실측 도킹6 에선 40mm)
    - HELD: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
2026-08-09 잡기 순서를 사용자 정의대로 재작성 (열기 -> 최고z -> 수직하강 -> 닫기)
    이전 구현은 순서가 달랐고(접근 후 열기), 하강도 관절 보간이라 경로가
    옆으로 샐 수 있었다. 정의된 순서로 다시 짰다:
    ① 그리퍼 열기
    ② 목표 도킹 축 위로, 그 자리에서 갈 수 있는 최고 높이까지 이동
    ③ 두 축(axis_ppap = axis_7)을 맞춘 채 수직으로만 하강
    ④ 물체 바닥 +36.37mm 에서 닫기 = 잡힘
    - _max_z_over(x,y): 그 축 위에서 도달 가능한 최고 z 를 탐색 (②)
    - _descend(): x,y 를 고정하고 z 만 5mm 씩 낮추며 매 지점 IK -> 축 유지 (③)
    검증: 하강 중 축 이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
2026-08-09 잡기 순서 정정: z 상승 먼저 + 경로 공통 최고 z, 잡는 높이 37mm 고정
    사용자 정정 2가지 반영.
    1) 순서를 다시 잡았다 (이전엔 열기가 맨 앞, 최고 z 를 목표점에서만 계산)
    ① z 상승 - 현재 위치에서 목표 축까지 '경로 전체' 공통 최고 z 로
    ② 그리퍼 열기 (안전 높이에서)
    ③ 축 일치 - 그 높이 유지한 채 수평 이동 (axis_ppap = axis_7)
    ④ 수직 하강 - 축 맞춘 채 z 만
    ⑤ 닫기 = 잡힘
    _travel_z(): 출발-목표를 8구간으로 나눠 각 지점의 최고 z 중 가장 낮은
    값을 쓴다. 한쪽만 높이 올라가도 중간에 막히면 수평 이동이 안 되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
2026-08-09 잡기/놓기를 파이프라인 블록으로 + 물체·도킹 이름 지정
    1) 파이프라인 블록
    - '@grasp:<물체>' / '@release:<도킹>' 항목 추가. 라벨은 ◈ 로 표시
    (■자세 ┃이동 ◆그리퍼 와 구분)
    - 실행 루프에서 do_grasp/do_release 를 호출. 이 블록들은 스스로
    상승->축일치->하강->그리퍼 를 수행하므로 경로 계획에서는 제외한다
    (pose_seq 가 물체 블록도 걸러냄)
    - 자세가 1개여도 물체 블록만으로 실행 가능하도록 가드 완화
    2) 이름 지정
    - set_name/disp_name: 물체·도킹에 부르는 이름과 색을 지정, calib.json 저장
    - 지정하면 3D 색과 블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
2026-08-10 보정값을 '자세 × 로봇' 별로 분리 + DXL base 손으로 맞추기
    보정값은 URDF 이론값과 실물의 차이라, 로봇이 다르면 조립오차·링크휨도
    달라 같은 자세라도 값이 달라야 한다. 지금까지는 자세당 offset 이 하나뿐이라
    SO-ARM 을 보고 맞춘 값이 Dynamixel 에도 그대로 적용됐다.
    - p['offsets'] = {'sts':[...], 'dxl':[...]} 로 분리.
    get/set_offset 이 현재 실행 로봇(EXEC['mode'])에 따라 자동으로 고른다
    -> 이 두 함수만 고치면 호출부 12곳은 그대로 동작
    - 예전 형식 p['offset'] 은 STS 보정으로 자동 이관 (기존 데이터 보존).
    sts 쪽은 구버전 필드도 함께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
2026-08-10 보정을 [자세] 탭으로 통합: 대상 로봇 직접 선택 + base 캡처 공통화
    이전 커밋의 잘못 3가지를 바로잡았다.
    ① base 캡처를 Dynamixel 전용으로 만들었다 (SO-ARM 도 똑같이 필요한데)
    ② 보정 대상을 '실행 로봇' 에 묶었다 (실행과 보정은 별개 개념)
    ③ 보정 기능을 [이동] 탭에 뒀다 (보정은 [자세] 탭에서 하는 일)
    - CAL['robot']: 보정 대상을 [자세] 탭에서 직접 고른다. EXEC(실행 로봇)과
    완전히 분리 - 실물이 연결돼 있지 않아도 보정값을 보고 고칠 수 있다
    - h_cal_torque_off / h_cal_capture_zero: 두 로봇 공통.
    선택한 로봇의 토크를 풀고,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
2026-08-10 USB 자동 인식: 포트 번호 대신 by-id 로 로봇 판별
    증상: "Dynamixel 연결 실패 (/dev/ttyUSB0), SO-ARM 연결 실패 (/dev/ttyACM0)"
    원인: 두 로봇 다 정상 연결돼 있었는데 번호가 0 -> 1 로 밀려 있었다.
    usbipd detach/attach 를 반복하면 이전 번호가 정리되기 전에 다시 잡혀
    다음 번호를 받는다. 사용자 추측이 맞았다.
    해결: /dev/serial/by-id/ 의 고정 경로를 쓴다. 칩 종류와 시리얼번호가 박혀
    있어 번호가 밀려도 늘 같은 장치를 가리키고, 어느 로봇인지도 구별된다.
    SO-ARM(STS3215) = CH343 칩 (1a86) -> usb-1a86_..._5B3D044884-if00
    Dynamixel(U2D2) = FTDI 칩 (04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
2026-08-10 버그: [자세] 탭 '로봇을 이 자세로'가 항상 STS 로만 갔다
    사용자 지적대로였다. h_ft_goto 가 ROBOT(RobotMux)을 써서 [이동] 탭의
    실행 로봇 설정을 따랐고, 그 기본값이 sts 라 [자세] 탭에서 Dynamixel 을
    골라도 SO-ARM 이 움직였다. 미세조정 +/- 는 앞서 _cal_send 로 고쳤는데
    이 버튼과 그리퍼 버튼이 빠져 있어, 같은 탭 안에서 버튼마다 다른 로봇으로
    가는 상태였다.
    - h_ft_goto: 보정 대상 로봇(offset_robot)으로 전송. 출발 자세도 실물 read
    대신 3D 기준 자세를 쓴다(로봇이 달라도 같은 기준에서 계획)
    - h_ft_grip: 같은 기준. Dynamixel 은 그리퍼 열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
2026-08-10 축 수를 URDF 에서 읽도록 + Dynamixel 속도 절반
    1) robot_njoints() 가 return 5 로 하드코딩돼 있었다(사용자 지적).
    이제 그 로봇의 URDF 에서 revolute 조인트를 세고 마지막 하나(그리퍼)를
    빼서 조정 축 수를 정한다. 축 수가 다른 로봇을 붙여도 미세조정 UI 와
    가동범위 표시가 자동으로 따라간다.
    현재 두 로봇 다 revolute 6개 -> 조정 5축 (우연히 같지만 이제 읽어서 나온 값)
    2) Dynamixel 이 너무 빨라 속도를 절반으로:
    - DXL_MOVE_MS 600 -> 1200 (시간기반 프로파일, 클수록 느림)
    - 전송 간격도 2배(DXL_STEP_SLOW). 모터만 늦추면 명령이 앞질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
2026-08-10 안전 버그: Dynamixel 미세조정 때 토크가 꺼져 팔이 낙하
    증상: j3 를 0.5도 내리려 했는데 모든 모터의 토크가 꺼져 팔이 바닥에 부딪힘.
    원인: DXLRobot.time_profile() 이 Drive Mode 를 바꾸려고 전 모터의 토크를
    끈다(Dynamixel 은 토크가 켜져 있으면 Drive Mode 변경 불가). 그런데 끄기만
    하고 되살리지 않았고, _cal_send() 가 미세조정 한 번마다 이 함수를 불렀다.
    -> time_profile(토크 OFF) → torque(True) 사이에 팔이 중력으로 낙하.
    수정:
    - 프로파일이 이미 같은 설정이면 아예 건드리지 않는다(_prof 캐시).
    반복 호출에서 토크가 다시 꺼지는 일 자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
    [dxl_axis_check.py]
2026-08-10 버그: 미세조정에서 관절 하나를 눌러도 여러 축이 함께 움직임
    원인 두 가지가 겹쳐 있었다.
    1) Dynamixel 은 _cal_send 가 map_sts_to_dxl(EE 경로 매핑)을 거쳤다.
    J2 하나만 눌러도 IK 가 전 관절을 다시 풀어 여러 축이 동시에 움직인다
    -> 미세조정 자체가 불가능. direct 전송(관절값 그대로) 옵션 추가
    2) '로봇을 이 자세로' 는 level_offset 을 썼다. 물컵 규칙상 j2/j3 에 준
    보정을 j4 로 상쇄하므로(j2 +1도 -> j4 -1도) 하나 눌렀는데 둘이 움직인다.
    보정 작업에는 상쇄를 쓰지 않고 저장된 보정값을 그대로 적용
    - 미세조정 +/- 와 보정 초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
2026-08-10 Dynamixel 의 수평 기준을 'base 자세'로 분리 (SO-ARM 은 그대로)
    사용자 정정: 물컵 규칙의 기준이 로봇마다 다르다.
    SO-ARM - 지금 방식 유지 (j2+j3+j4 합으로 기울기 계산). 건드리지 않음
    Dynamixel - 손으로 물컵 규칙에 맞게 잡아둔 base 자세가 곧 수평의 기준
    DXL 은 축 구성이 달라(수평 그룹이 j1,j2,j3,j5) SO-ARM 의 합 수식이 맞지 않는다.
    - dxl_level_axes(): 수평을 만드는 축을 DXL URDF 에서 자동 판별
    실측 결과 j1,j2,j3,j5 가 수평 그룹, j4 가 수평을 깨는 축
    - dxl_apply_level(): 수평을 깨는 축(j4)을 base 값으로 고정.
    SO-ARM 의 j5 고정과 같은 개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
2026-08-10 버그(재발): 미세조정이 여전히 전 모터에 명령을 보냈다
    앞선 커밋에서 '관절값 계산' 은 한 축만 바뀌게 고쳤지만, send() 가 항상
    5개 모터 전부에 write 를 날리는 구조는 그대로였다. 나머지 4개는 '같은 값'
    이지만 명령을 받으면 미세하게 움직인다 -> 사용자 눈에는 여러 축이 함께
    움직이는 것으로 보인다. 실제 write 를 추적해 확인했다(5개 명령 발생).
    - Robot.send / DXLRobot.send 에 only=[관절인덱스] 추가.
    지정하면 그 관절에만 write 한다
    - _cal_send(only=...) 로 전달, h_ft_step 은 only=[j] 로 고른 관절만
    - 실행 경로(파이프라인/잡기)는 on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
2026-08-10 영점(base) 보존: 저장 시 이전 값 백업 + 형식 통일
    사용자가 두 로봇의 base 를 손으로 맞춰 저장했다. 그 값이 재시작 후에도
    유지되고, 다시 저장하면 갱신되는지 확인했다.
    확인 결과 저장·복원은 정상:
    STS {1:1457, 2:1411, 3:1853, 4:874, 5:3462, 6:842} (sts_zero.py)
    DXL {0:1600, 1:2526, 2:1465, 3:2158, 4:2493, 5:2001} (dxl_zero.py)
    앱이 읽은 값과 파일 내용 일치, 재시작해도 그대로 로드됨
    안전장치 추가:
    - 영점을 새로 저장할 때 이전 파일을 .bak 으로 백업.
    잘못 캡처해도 되돌릴 수 있다(예전에 내가 값을 잘못 고른 적이 있었음)
    - sts_zero.py 에도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
2026-08-11 ARM STUDIO PRO: 새 UI 를 3단계 탭으로 재구성 (공장·로봇·음성)
    사용자가 만들어 둔 arm_studio_pro.py(FastAPI, 기존 앱을 라이브러리로
    재사용) + pro_ui(순수 HTML/CSS/JS)를 확인하고, 개발용 4탭(자세/이동/환경/
    공간선택)을 실사용자 관점의 3단계 탭으로 재배치했다.
    ① 공장 꾸미기 - 설비(STL 표시/업로드), 이름 붙이기, 바닥 플레이트,
    로봇 위치(타일 스냅), 공간 좌표(목심)
    ② 로봇 연동 - 실행 로봇 선택/연결 확인/토크, 자세 목록/3D 슬라이더,
    미세조정(보정 로봇별), 영점 손으로 맞추기, 자세 관리
    ③ 음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
2026-08-11 PRO UI: RViz 전환 제거, 3D 뷰가 왼쪽 카드 전체 사용
    - viewHead(제목 + 3D뷰/RViz 토글) 삭제 -> iframe 만 남아 세로 공간 확대
    - app.js 의 RViz 전환 배선 제거 (뷰어는 three.js 3D 전용)
    - 백엔드/코어의 RViz 웹 스트리밍은 건드리지 않음 (기존 UI 용으로 유지)
    - 검증: 스크린샷, JS 오류 0
2026-08-11 공장 꾸미기: 색 즉시 반영, 플레이트 더블클릭 확장, 로봇 2핀 배치(회전), 설비 썸네일 드래그 배치, 탭 재구성(공장/시뮬레이션/연동)
    - 뷰어: 이름 붙이기 색 변경이 3D에 즉시 반영
    - 플레이트: 더블클릭=확장 모드, 유령 클릭=추가 후 자동 닫힘 (패널 제거)
    - 로봇 이동: 주황 핀 클릭 -> 바닥 목심 -> 하늘색 후보 목심 = 위치+회전(90도 스냅) 확정
    BASE_YAW 가 FK/IK/충돌격자/목심표 전체에 반영
    - 설비: 접두어 제거 + STL 썸네일(SVG) + 플레이트 제외 + 드래그로 3D 배치(20mm 스냅, 영속화)
    - PRO UI: 탭 = 공장 꾸미기 / 시뮬레이션 / 연동, 미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
2026-08-11 설비도 로봇처럼 2핀 배치: 드롭 -> 다리(핀) 클릭 -> 목심 -> 하늘색 후보 = 자리+회전
    - 설비 STL 바닥 다리(Ø10mm) 자동 검출 (docking5: 40mm 간격 2개)
    - 드래그 드롭이 바로 놓지 않고 배치 모드 시작 (핀 미검출 STL 만 예전 중심 스냅 폴백)
    - 회전(yaw) 지원: 뷰어 렌더, 장애물 격자, 충돌 검사(기존 미변환 버그 수정), docking_top
    - 빈 곳 클릭 = 배치 취소(/emoff), env_off 는 [x,y,yaw] 로 영속화(구형식 호환)
2026-08-11 드래그 앤 드랍 업그레이드: 입체 썸네일 + 실물 STL 이 커서를 따라옴 + 드롭 자리에서 핀 선택
    - 썸네일: 위에서 본 실루엣 -> 등각투영 + 면 음영 SVG (입체 이미지)
    - 드래그 중: 납작한 브라우저 고스트 대신 3D 안 실제 STL 메쉬가 커서 밑 바닥을 따라다님
    (env_drag 로 드래그 id 전달, 뷰어가 25ms 폴링으로 즉시 추적)
    - 드롭: 예전 위치로 날아가지 않고 드롭 지점 근처(20mm 스냅)로 옮긴 뒤 그 자리에서
    주황 다리(핀) 선택 시작 - 확대/축소 없이 바로 클릭 가능
2026-08-11 목심 도달표를 로봇 상대좌표로 전환: 로봇/설비를 옮겨도 재계산 0초
    - 도달 가능성은 '로봇에서 (dx,dy) 떨어진 곳' 의 성질 -> 상대 격자 (10+20i,10+20j)mm
    로 딱 한 번 계산해 저장, 이후는 월드->로컬 변환 후 조회만 (뺄셈+회전)
    - 로봇 이동/회전(90도 스냅), 설비 이동, 플레이트 추가/삭제 모두 표 무효화 안 함
    - 높이별 reach_ring 선별을 빌드에도 적용해 IK 횟수 절감
    - 실제 이동은 그대로 라이브 IK: 4개 자세(이동+회전)에서 표 판정 = 라이브 IK
    160/160 일치 검증, 격자 위상 어긋남 0
    - 구형식 peg_table.json 은 자동 무시하고 새로 만든다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
2026-08-11 시뮬 버그 수정: 미리보기가 잡기/놓기 블록까지 전부 3D 재생 + 연결 자동감지 표시 + 카드 색 지정
    - [버그] 미리보기가 자세-자세 경로만 재생하고 잡기/놓기 블록은 건너뛰어
    '자세 1개 + 잡기 + 놓기' 파이프라인이면 아무것도 안 움직였음
    -> h_preview 가 파이프라인 전체(첫 자세 이동, 그리퍼, 잡기/놓기, 구간)를 재생
    - FORCE_SIM: 미리보기 동안은 실행 로봇 설정이 무엇이든 실물 통신 전면 차단
    (② 시뮬레이션 탭 = 무조건 시뮬. EE 20개 위치 이동 + 실물 전송 0 검증)
    - 상단 연결 칩: USB by-id 자동 감지해 '로봇 없음 - 시뮬레이션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
    [arm_studio_pro.py]
2026-08-11 README: 남은 작업 전체 기록 (무선 2모드, 음성 제어+실시간 시뮬, 기타)
2026-09-02 README 재작성: 지금 동작하는 기능만 기록
    - 남은 작업 목록과 옛 정보(포트 7860, start.sh) 제거
    - 공장 꾸미기 / 블록 파이프라인 / 말로 만들기 / 실물 실행 / 물컵 규칙 정리
    - 사진 자리(docs/factory.png)와 작성자 칸만 비워둠
2026-09-02 말로 만들기 안정화: LLM 사고 비활성 + 출력 검증 강화
    - Gemma 4 thinking 끔 (복잡한 명령에서 토큰 소진으로 빈 응답 나던 문제)
    - LLM 이 낸 블록 후처리: id 정규화, 중첩 배열 펴기, 잡기 앞 이동 보장
    - 시뮬 모드에서 그리퍼 대기·보정 자세 참조 제거 (실물 전용 로직)
    - 도킹 배치 시 색·번호 고정 매칭 (재배치해도 라벨 유지)
2026-09-02 실행에 필요한 파일 보강 + README 정비
    - 실측 결합 치수(dock_mate_fixed, robot_pins_fixed)와 사전 계산 표
    (peg_table, joy_table) 추가 — 클론 직후 바로 동작하도록
    - spark_link.sh 의 서버 주소를 spark_tunnel.txt(미포함)로 분리
    - 데이터셋 생성 스크립트 make_llm_data.py 추가
    - README 를 대회 형식으로 재구성 (기구학·LLM 파인튜닝 중심)
2026-11-05 ARM STUDIO 두 팔·더블 레이첼·DUSK_BOOM TPU 소스 백업 (11-06)
    - ARM STUDIO: 두 팔(A/B) 실물, B팔 보정 수직선 하강·잡는 높이, 일시 정지/계속,
    보정 자세 보호(배치 불러오기·수평 보정·슬라이더가 보정값을 바꾸지 않음), 배치 하나(esw_contest_drboom),
    그리퍼 2배 속도, 접근 높이 209mm, 높이 검사 보강, 새 82mm 펜 메쉬
    - 더블 레이첼·RACHEL: 학습 생성기·검사기·시험지 스크립트, C++ 추론 엔진 소스 (모델 가중치 제외)
    - DUSK_BOOM: Zynq TPU RTL·리눅스 C++ 추론(rachel_tpu)·HDMI 연산 화면(tpu_show)·라떼판다 Mu 실행기
    - 제외: 모델 가중치·학습 데이터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
    [Industry_gyu_arm_20260727 - docking_station-5.STL, ppap_base.STL, ppap_l1.STL]
2026-11-08 비상정지 버튼·Spot 제어 탭·B팔 수직 하강·FPGA 화면 정리 (11-06~11-08)
    - ARM STUDIO
    - 아두이노 비상정지 버튼: '1' = 토크 유지한 채 그 자리 정지(눌린 동안 모든 이동 막음),
    '1' 다음 '0' 또는 연결 끊김 = 두 팔 토크 끔
    - ④ Spot 제어 탭: 책꽂이 공정(:7910)을 본문 자리에 꽉 차게, Spot 화면에서 위쪽 원위치 = Spot 공간 원위치
    - 일시 정지/계속, B팔 보정 자리 수직선 하강(보정 자세 기울기 유지)·잡는 높이까지·B팔 20mm 더,
    보정 자세 보호, 배치 하나, 그리퍼 2배, 접근 높이 209mm
    - Spot 책꽂이 공정 (arm_studio_multi · duo_studio · world_ra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
2026-11-08 문서 개편: RACHEL 메인 문서 · DUSK_BOOM TPU · ARM STUDIO 분리, 영상 링크, Spot 제외 (11-08)
    - README: 발표 흐름(문제 → 목표 → 파이프라인 → 핵심 기술 → 하드웨어 · 개발 환경)으로 다시 씀, 영상 2개(썸네일 링크)
    - RACHEL.md (메인): 작동 원리, PyTorch 로 직접 만든 모델 · 데이터 합성 · 학습, 검사 9가지, 차수별 기록, 성적
    - DUSK_BOOM.md: 직접 설계한 행렬곱 TPU 회로, 보드 프로그램, 검증, 보드 리눅스 · HDMI 회로, 정수 엔진 DUSK
    - ARM_STUDIO.md: 모터 제어 과정, 물병 규칙, 자리 보정, 두 팔, 안전 기능, 실행 방법
    - Spot(arm_studio_multi · duo_studio · w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
2026-11-10 TPU.md: DUSK_BOOM TPU 작동 원리 · 비바도로 만드는 법 · 타이밍 맞춘 빌드 4번 (11-10)
    - 엔진 파이프라인(s1~s8), 레지스터, 프로그램에서 한 번 곱하는 순서, 숫자 넘침 증명
    - build.tcl 단계(PS7 · GP0/HP1/HP2 · 0x43C00000 · MAX_DSP 66), 클럭, Verilog 속성
    - 빌드 1차 배치 실패 → 2차 WNS -2.24 → 3차 -1.16 → 4차 +0.339ns
    - SD 부팅(uEnv.txt), 장치 트리 예약 메모리(zynq-dusk-boom.dts 추가), 검증 3단계
    - build.tcl 머리말을 실제 빌드 기록으로 고침
